Zhangjiexi229/SMART-M/文档/继电器端子特写_缩放.jpg

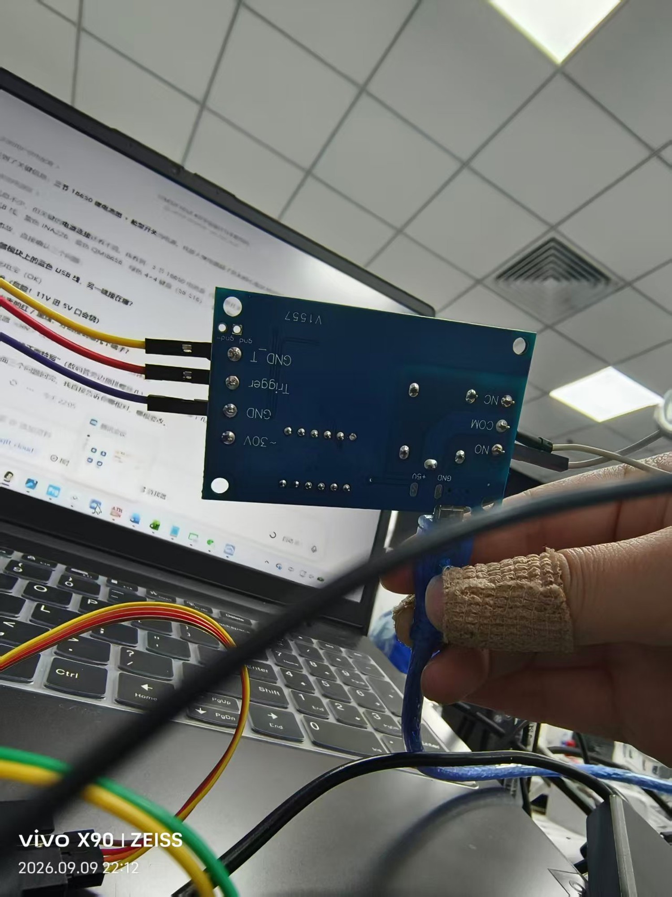
文档/继电器端子特写_缩放.jpg
