Zhangjiexi229/SMART-M/文档/接线_左下板区.jpg

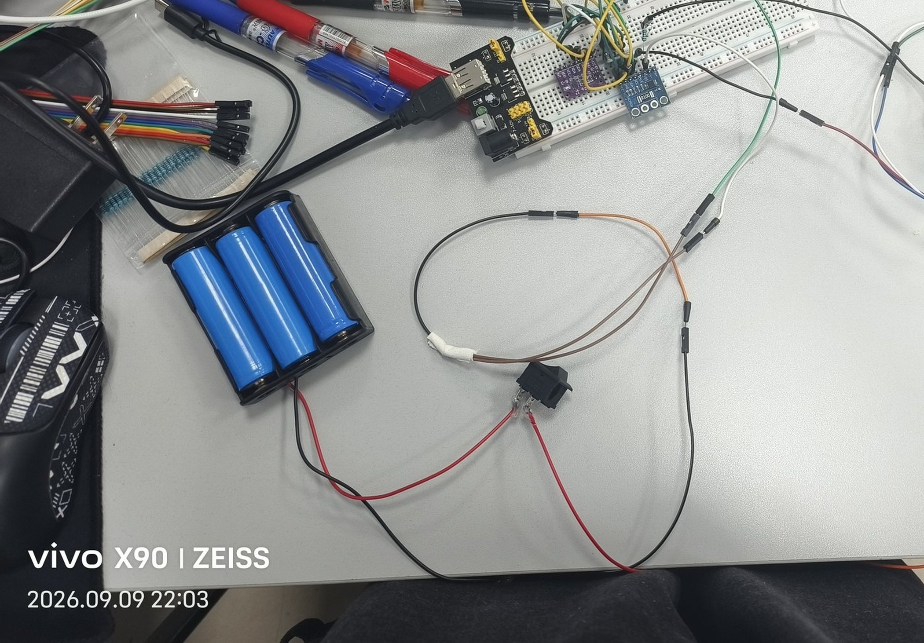
文档/接线_左下板区.jpg
