Zhangjiexi229/SMART-M/文档/器件引脚与功能配置总表.md

# SMART-M — 器件引脚与功能配置总表（F407VET6 新核心板版）

> 芯片：**STM32F407VET6（LQFP100）**，168MHz，512KB Flash / 192KB RAM
> 工程：`D:\STM32kdl\SMART-M`（CubeMX 工程 SMART-M.ioc + usrcode 分层代码）
> 本表为唯一权威引脚依据，与 bsp_xxx.h 头文件、SMART-M.ioc、接线图三处完全一致。

---

## 1. 器件 → 引脚 → 功能 → 配置 总表

| # | 器件/模块 | 信号 | STM32 引脚 | 引脚功能配置 | 配置位置 | 说明 |
|---|---|---|---|---|---|---|
| 1 | **SHT30 温湿度** | SCL | **PB8** | GPIO 推挽输出（开漏模拟时序，外部 4.7kΩ 上拉） | CubeMX GPIO + bsp_i2c_soft.c | 7 位地址 **0x44**（ADDR 接 GND）；总线1 |
| | | SDA | **PB9** | GPIO 开漏/推挽动态切换（4.7kΩ 上拉） | bsp_i2c_soft.c | 总线1 |
| | | VCC/GND | 3.3V / GND | 供电 | - | |
| 2 | **QMI8658 六轴** | SCL | **PB8** | 同上（与 SHT30 共用总线1） | bsp_i2c_soft.c | 7 位地址 **0x6B**（**本模块 AD0 板上固定接地**）；WHO_AM_I=0x05 |
| | | SDA | **PB9** | 同上 | bsp_i2c_soft.c | |
| | | AD0/SA0 | **板上固定 GND** | 地址选择 | 模块固定 | 本模块实测 0x6B；若换悬空模块则地址 0x6A，须同步改驱动 |
| 3 | **INA226 电流** | SCL | **PB8** | 同上（共用总线1） | bsp_i2c_soft.c | 7 位地址 **0x45**（本模块实测；A0/A1 模块出厂固定接 3.3V） |
| | | SDA | **PB9** | 同上 | bsp_i2c_soft.c | |
| | | IN+/IN- | 0.1Ω 采样电阻两端 | 电流采样 | 硬件接线 | 采样电阻串入电机电源回路 |
| 4 | **SSD1306 OLED 0.96"** | SCL | **PD6** | GPIO 推挽输出（总线2，模块自带上拉） | CubeMX GPIO + bsp_oled.c | 7 位地址 **0x3C**；**独立总线2**，不与传感器共用 |
| | | SDA | **PD7** | GPIO 推挽输出 | CubeMX GPIO + bsp_oled.c | |
| 5 | **ESP8266-01S WiFi** | TXD | **PB11** | **USART3_RX**（DMA 循环接收 + IDLE 空闲中断） | CubeMX USART3 + bsp_uart.c + bsp_esp8266.c | 外接（新板无板载接口），115200 8N1 |
| | | RXD | **PB10** | **USART3_TX** | CubeMX USART3 | ESP8266 RXD ← 单片机 TX |
| | | VCC | 独立 3.3V | 供电（**≥300mA**，AMS1117 单独一路） | 硬件接线 | 不可从核心板 3V3 取电 |
| | | CH_PD/EN | 3.3V（10k 上拉） | 使能 | 硬件接线 | 必须拉高 |
| | | GPIO0 | 10k 上拉（或悬空） | 正常运行模式 | 硬件接线 | |
| 6 | **继电器（断电保护）** | IN | **PA4** | GPIO 推挽输出（GPIO_SPEED_FREQ_LOW） | bsp_relay.c 动态初始化 | **高电平吸合**；光耦输入；COM/NO 串接电机电源回路 |
| | | VCC/GND | 5V / GND | 模块供电（光耦隔离，与单片机共地） | 硬件接线 | 上电默认断开，告警断开、恢复自动合闸 |
| 7 | **有源蜂鸣器** | I/O | **PA5** | GPIO 推挽输出 | CubeMX GPIO（BEEP_Pin）+ bsp_beep.c | **外接**（新板无板载）：+→PA5、-→GND；高电平响 |
| 8 | **4×4 矩阵键盘** | 行 R1-R4 | **PE2 / PE6 / PE7 / PE10** | GPIO 推挽输出（扫描时逐行拉低） | bsp_key_matrix.c 动态初始化 | 避开板载 KEY0=PE4、KEY1=PE3、Echo=PE5 |
| | | 列 C1-C4 | **PE8 / PE9 / PE11 / PE12** | GPIO 输入上拉 | bsp_key_matrix.c 动态初始化 | 读列电平判断按下 |
| 9 | **调试串口（printf）** | TX/RX | **PA9 / PA10** | **USART1** 115200 | CubeMX USART1 + bsp_uart.c | 板载 USB 转串口 |
| 10 | 板载 LED2/LED3 | - | **PA6 / PA7** | GPIO 推挽输出（低电平点亮） | CubeMX GPIO + bsp_led.c | 软件占用（LED1/LED3=PA6、LED2/LED4=PA7 为兼容逻辑位） |
| 11 | 板载按键（勿占用） | KEY0/KEY1/WK_UP | **PE4 / PE3 / PA0** | 输入 | 板载 | 勿配置为外设 |
| 12 | HC-SR04（预留，未启用） | Trig | **PC11** | GPIO 推挽输出 | CubeMX GPIO + bsp_hc_sr04.c | 8 外设版未启用 |
| | | Echo | **PE5** | GPIO 输入 | CubeMX GPIO | 5V 电平需 2k/1k 分压 |
| 13 | SWD 下载 | SWDIO/SWCLK | **PA13 / PA14** | SYS Serial Wire | CubeMX SYS | 调试下载口，勿占用 |
| 14 | 外部晶振 | OSC_IN/OUT | **PH0 / PH1** | RCC HSE（8MHz） | CubeMX RCC | 系统时钟 168MHz |

---

## 2. CubeMX 外设配置清单（SMART-M.ioc）

| 外设 | 配置 | 说明 |
|---|---|---|
| RCC | HSE 8MHz，PLL 倍频 → **SYSCLK 168MHz** | PLLM=8, PLLN=336, PLLQ=84 |
| SYS | Debug: **Serial Wire**（PA13/PA14） | SWD 下载 |
| TIM6 | Timebase 时基（NVIC，优先级 15） | HAL 时钟源 |
| TIM2 | 内部时钟（ClockSourceINT） | bsp_delay.c 微秒延时（自由计数） |
| USART1 | 异步 115200 8N1，**DMA2_Stream2 RX 循环** + DMA2_Stream7 TX | 调试 printf（PA9/PA10） |
| USART3 | 异步 115200 8N1，**DMA1_Stream1 RX 循环** + TX | ESP8266 通信口（PB10/PB11） |
| USART2 | 异步 9600（PA2/PA3，Modbus 预留） | module_cfg 中 PROTOCOL 已禁用，不启用 |
| FREERTOS | CMSIS_V2，默认任务 defaultTask | 应用任务在 app_tasks.c 创建 |
| GPIO 静态 | PA5 蜂鸣器 / PA6·PA7 LED / PC11 Trig / PE5 Echo / PD6·PD7 OLED / PB8·PB9 总线1 / PB3·PB4·PB5 SPI(禁用) | 见 gpio.c |
| GPIO 动态 | PA4 继电器 / PE2·PE6·PE7·PE10·PE8·PE9·PE11·PE12 矩阵 | BSP 初始化时配置 |

---

## 3. 8 大外设物理接线明细（杜邦线）

| 外设 | STM32 引脚 | 模块引脚 | 线色建议 | 备注 |
|---|---|---|---|---|
| SHT30 | 3.3V / GND | VCC / GND | 红 / 黑 | |
| | PB8 / PB9 | SCL / SDA | 蓝 / 蓝 | 总线1，SCL/SDA 各 4.7kΩ 上拉至 3.3V |
| QMI8658 | 3.3V / GND | VCC / GND | 红 / 黑 | |
| | - | AD0/SA0 | - | 本模块板上固定接地，**实测地址 0x6B**（软件已按 0x6B 编译） |
| | PB8 / PB9 | SCL / SDA | 蓝 / 蓝 | 共用总线1 |
| INA226 | 3.3V / GND | VCC / GND | 红 / 黑 | |
| | - | A0 / A1 | - | 本模块出厂固定接 3.3V，**实测地址 0x45**（软件已按 0x45 编译） |
| | PB8 / PB9 | SCL / SDA | 蓝 / 蓝 | 共用总线1 |
| | IN+ / IN- | 0.1Ω 电阻两端 | - | 串入电机电源回路 |
| | VBUS | 电机电源正极（与 IN+ 同节点） | 红 | **必接**：母线电压采样，悬空则 Bus 恒为 0 |
| OLED | 3.3V / GND | VCC / GND | 红 / 黑 | 0.96" SSD1306 |
| | PD6 / PD7 | SCL / SDA | 蓝 / 蓝 | 独立总线2 |
| ESP8266 | 独立3.3V | VCC | 红（独立） | ≥300mA |
| | GND | GND | 黑 | 共地 |
| | PB10 / PB11 | RXD / TXD | 绿 / 绿 | USART3 |
| | 3.3V | EN/CH_PD | 红 | 使能拉高 |
| | - | GPIO0 | - | 10k 上拉或悬空 |
| 继电器 | 5V / GND | VCC / GND | 红 / 黑 | 光耦隔离 |
| | PA4 | IN | 黄 | 高电平吸合；COM/NO 串接电机电源 |
| 蜂鸣器 | 3.3V 或 5V | VCC | 红 | 按模块额定电压 |
| | GND | GND | 黑 | |
| | PA5 | I/O | 黄 | 高电平响 |
| 矩阵键盘 | PE2 / PE6 / PE7 / PE10 | R1-R4 | 黄×4 | 行 |
| | PE8 / PE9 / PE11 / PE12 | C1-C4 | 黄×4 | 列 |

---

## 4. 供电架构

```
12V 适配器 ──┬─ 电机驱动板（功率回路，经继电器 COM/NO 通断）
             └─ 5V 降压（AMS1117-5.0 / MP1584）──┬─ 核心板 5V-IN → 板载 3.3V LDO
                                                 ├─ 继电器 VCC（5V）
                                                 └─ 独立 AMS1117-3.3 → ESP8266 VCC（单独一路，≥300mA）
    传感器 / OLED / 蜂鸣器：3.3V（核心板 3V3 或独立 3.3V，与 STM32 共地）
```

---

## 5. 与旧板（小达 M4 核心板 v1.2）关键差异

| 项 | 旧板 | 新板（本表） |
|----|---|---|
| 芯片 | STM32F407（LQFP100） | STM32F407VET6（LQFP100） |
| SHT30/QMI8658/OLED | I2C1 PB8/PB9 共用（OLED 同总线） | 总线1 PB8/PB9 挂三传感器；**OLED 拆独立总线2 PD6/PD7** |
| QMI8658 地址 | 0x6B | **0x6B（本模块 AD0 板上固定接地，实测；悬空模块为 0x6A）** |
| INA226 | 独立 I2C2 PB10/PB11（与 USART3 冲突） | 并入总线1 PB8/PB9 |
| ESP8266 | 板载 P1 接口 | **外接** USART3 PB10/PB11，独立 3.3V |
| 继电器 | PE2 | **PA4** |
| 蜂鸣器 | PE3（板载） | **PA5 外接**（新板无板载） |
| 矩阵键盘 | 行 PE4-PE7 / 列 PE8-PE11 | **行 PE2/PE6/PE7/PE10，列 PE8/PE9/PE11/PE12** |
| 板载 LED | - | PA6/PA7（低电平点亮） |
| HC-SR04（预留） | PA0/PA1 | PC11(Trig)/PE5(Echo) |

---

*本表由工程源码（bsp_*.h / main.h / SMART-M.ioc）考证生成，与已交付接线文档一致。*
