Zhangjiexi229/SMART-M/文档/Day 5 — 告警联动与上位机（完整代码版）.pdf

Day 5 — | 告警联动与上位机（完整代码版）
Day 5 — | 告警联动与上位机（完整代码版）

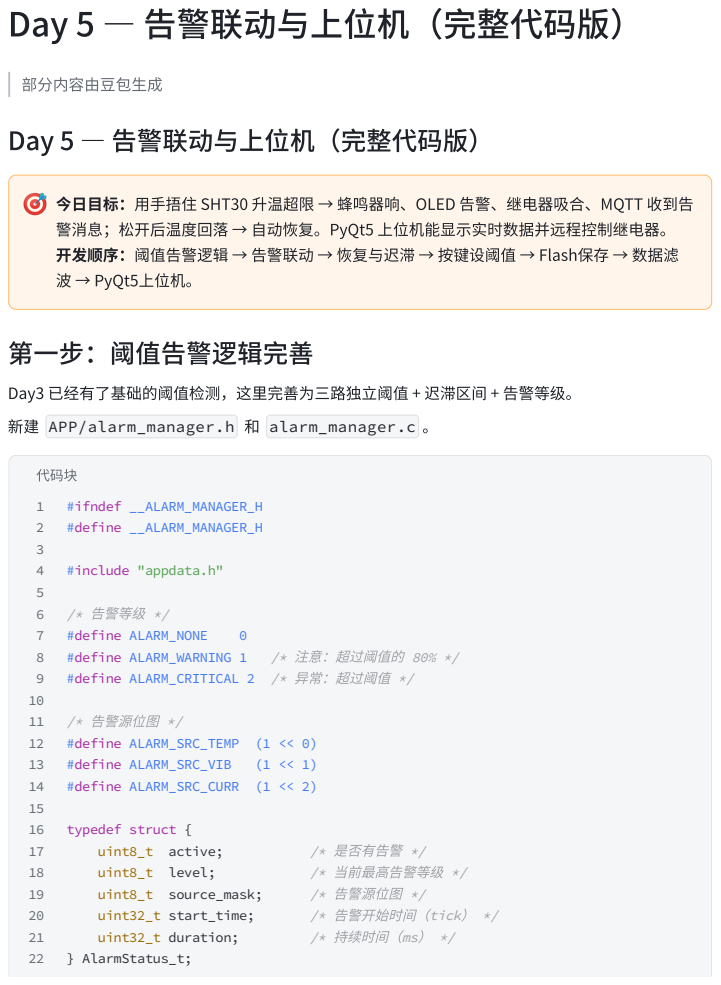
[picture p3: page 1]
部分内容由豆包生成; 第一步：阈值告警逻辑完善; 代码块; #ifndef __ALARM_MANAGER_H #define __ALARM_MANAGER_H; #include "appdata.h"; #define ALARM_NONE; #define ALARM_WARNING 1; /* 注意：超过阈值的 80% */; /* 告警源位图 */ #define ALARM_SRC_TEMP (1 << 0); #define ALARM_SRC_VIB; #define ALARM_SRC_CURR (1 << 2); typedef struct {; uint8_t active;; /* 是否有告警 */; uint8_t level;; /* 当前最高告警等级 */; uint8_t source_mask;; /* 告警源位图 */; uint32_t start_time;; /* 告警开始时间（tick） */; uint32_t duration;; /* 持续时间（ms） */; } AlarmStatus_t;

🎯 今日目标：用手捂住 SHT30 升温超限 → 蜂鸣器响、OLED 告警、继电器吸合、MQTT 收到告
警消息；松开后温度回落 → 自动恢复。PyQt5 上位机能显示实时数据并远程控制继电器。
开发顺序：阈值告警逻辑 → 告警联动 → 恢复与迟滞 → 按键设阈值 → Flash保存 → 数据滤
波 → PyQt5上位机。

Day3 已经有了基础的阈值检测，这里完善为三路独立阈值 + 迟滞区间 + 告警等级。
新建 APP/alarm_manager.h 和 alarm_manager.c 。

/* 告警等级 */
#define ALARM_CRITICAL 2 /* 异常：超过阈值 */

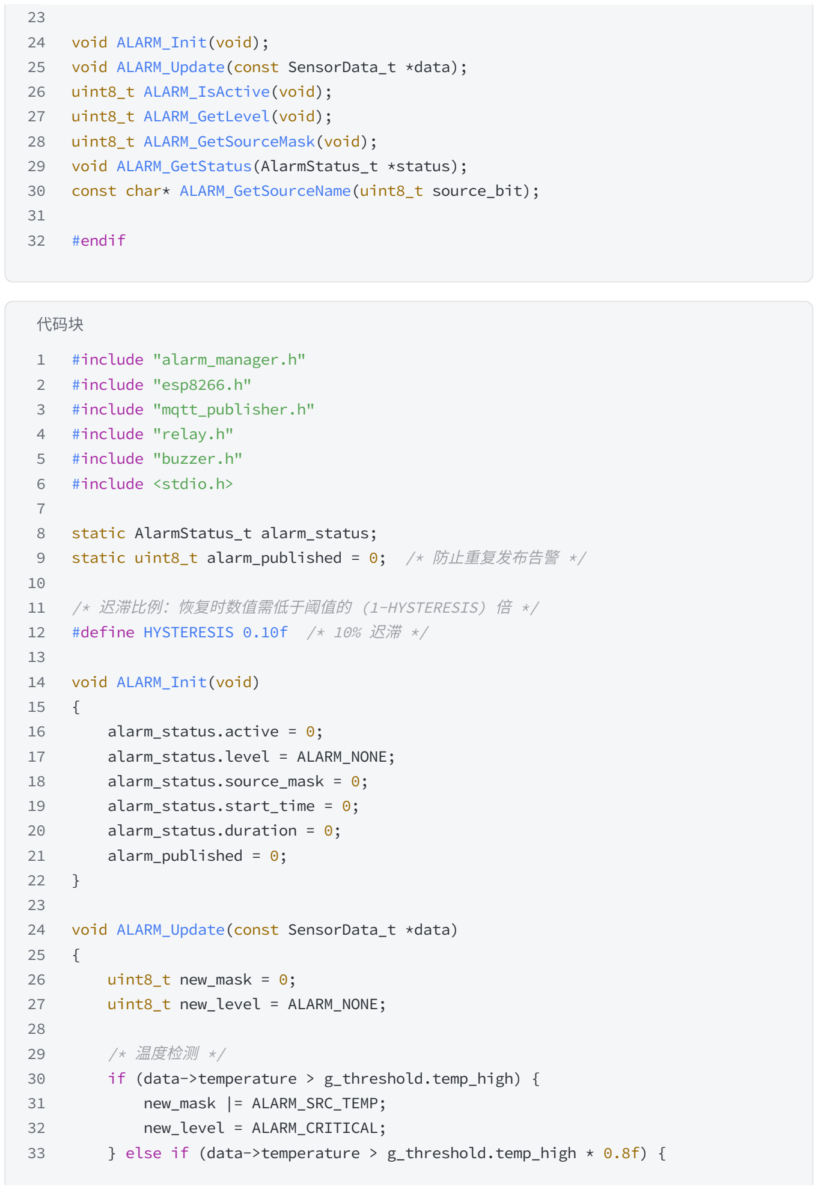
[picture p4: figure]
void ALARM_Init(void); void ALARM_Update(const SensorData_t *data); uint8_t ALARM_IsActive(void); uint8_t ALARM_GetLevel(void); uint8_t ALARM_GetSourceMask(void); void ALARM_GetStatus(AlarmStatus_t *status); const char* ALARM_GetSourceName(uint8_t source_bit);; #endif; 代码块; #include "alarm_manager.h" #include "esp8266.h" #include "mqtt_publisher.h" #include "relay.h" #include "buzzer.h" #include <stdio.h>; static AlarmStatus_t alarm_status;; /* 迟滞比例：恢复时数值需低于阈值的 (1-HYSTERESIS) 倍 */ #define HYSTERESIS 0.10f /* 10% 迟滞 */; void ALARM_Init(void) {; alarm_status.active = 0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

static uint8_t alarm_published = 0; /* 防止重复发布告警 */

} else if (data->temperature > g_threshold.temp_high * 0.8f) {

new_mask |= ALARM_SRC_TEMP;
if (new_level < ALARM_WARNING) new_level = ALARM_WARNING; }

/* 振动检测 */
if (data->vibration > g_threshold.vib_high) {
new_mask |= ALARM_SRC_VIB;
new_level = ALARM_CRITICAL;
} else if (data->vibration > g_threshold.vib_high * 0.8f) { new_mask |= ALARM_SRC_VIB;
if (new_level < ALARM_WARNING) new_level = ALARM_WARNING; }

/* 电流检测 */
if (data->current > g_threshold.curr_high) {
new_mask |= ALARM_SRC_CURR;
new_level = ALARM_CRITICAL;
} else if (data->current > g_threshold.curr_high * 0.8f) { new_mask |= ALARM_SRC_CURR;
if (new_level < ALARM_WARNING) new_level = ALARM_WARNING; }

/* 状态机：带迟滞的告警触发/恢复 */
if (!alarm_status.active && new_level >= ALARM_CRITICAL) { /* 触发告警 */
alarm_status.active = 1;
alarm_status.level = new_level; alarm_status.source_mask = new_mask; alarm_status.start_time = xTaskGetTickCount(); g_alarm_active = 1;
alarm_published = 0;
printf("ALARM TRIGGERED: mask=0x%02X level=%d\r\n", new_mask, new_level);
} else if (alarm_status.active) {
/* 更新告警等级和源 */
alarm_status.level = new_level; alarm_status.source_mask = new_mask; alarm_status.duration = (xTaskGetTickCount() -alarm_status.start_time);

/* 恢复条件：所有指标都低于阈值的 (1-HYSTERESIS) 倍 */
uint8_t can_recover = 1;
if (data->temperature > g_threshold.temp_high * (1.0f - HYSTERESIS)) can_recover = 0;
if (data->vibration > g_threshold.vib_high * (1.0f - HYSTERESIS)) can_recover = 0;

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
75 if (data->current > g_threshold.curr_high * (1.0f - HYSTERESIS)) can_recover = 0;

if (can_recover) {
alarm_status.active = 0;
alarm_status.level = ALARM_NONE; alarm_status.source_mask = 0; g_alarm_active = 0;
alarm_published = 0;
printf("ALARM RECOVERED, duration=%ums\r\n", alarm_status.duration);
}
}
}

uint8_t ALARM_IsActive(void) { return alarm_status.active; }
uint8_t ALARM_GetLevel(void) { return alarm_status.level; }
uint8_t ALARM_GetSourceMask(void) { return alarm_status.source_mask; }

void ALARM_GetStatus(AlarmStatus_t *status)
{
*status = alarm_status;
}

const char* ALARM_GetSourceName(uint8_t source_bit) {
switch (source_bit) {
case ALARM_SRC_TEMP: return "Temperature"; case ALARM_SRC_VIB: return "Vibration"; case ALARM_SRC_CURR: return "Current"; default: return "Unknown";
}
}

## 第二步：告警联动完整实现

在 AlarmTask 中调用 ALARM_Update，并执行联动动作。替换 Day3 的 AlarmTask：

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
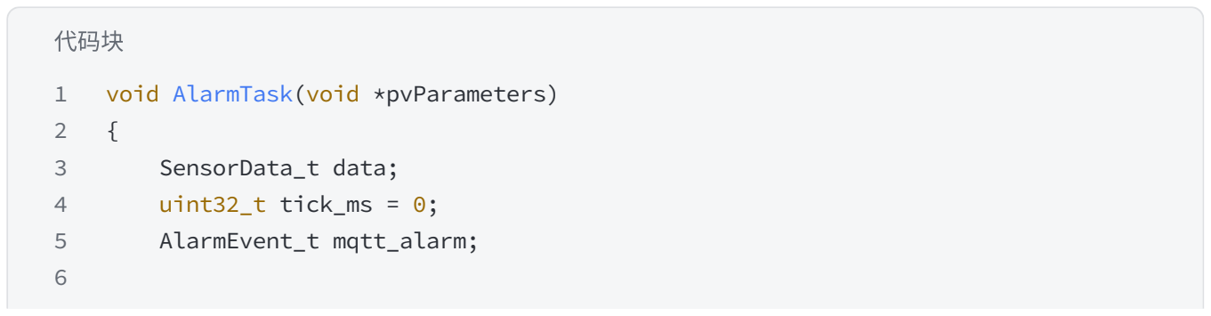
[picture p5: figure]
代码块; void AlarmTask(void *pvParameters) {; SensorData_t data; uint32_t tick_ms = 0; AlarmEvent_t mqtt_alarm;

ALARM_Init();

for (;;) {
/* 读取最新传感器数据 */
if (xSemaphoreTake(xDataMutex, pdMS_TO_TICKS(50)) == pdTRUE) { data = g_sensor_data;
xSemaphoreGive(xDataMutex);

/* 更新告警状态 */
uint8_t was_active = alarm_status.active; ALARM_Update(&data);

/* 告警触发瞬间：执行联动 + 发布 MQTT */
if (alarm_status.active && !was_active) { /* 1. 继电器吸合断电 */
RELAY_On();
/* 2. 蜂鸣器急促告警 */
BUZZER_AlarmPattern(1);
/* 3. 发布 MQTT 告警消息 */
if (alarm_status.source_mask & ALARM_SRC_TEMP) { mqtt_alarm.type = 1;
mqtt_alarm.value = data.temperature; mqtt_alarm.threshold = g_threshold.temp_high;
} else if (alarm_status.source_mask & ALARM_SRC_VIB) { mqtt_alarm.type = 2;
mqtt_alarm.value = data.vibration; mqtt_alarm.threshold = g_threshold.vib_high;
} else {
mqtt_alarm.type = 3;
mqtt_alarm.value = data.current; mqtt_alarm.threshold = g_threshold.curr_high; }
mqtt_alarm.level = alarm_status.level; MQTT_Pub_Alarm(&mqtt_alarm);

printf("ALARM ACTION: relay=ON buzzer=ON mqtt=published\r\n"); }

/* 告警恢复瞬间：解除联动 */
if (!alarm_status.active && was_active) { RELAY_Off();
BUZZER_AlarmPattern(0);
printf("ALARM RECOVER: relay=OFF buzzer=OFF\r\n"); }
}

/* 更新蜂鸣器节奏 */

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
## 第三步：OLED 告警显示优化

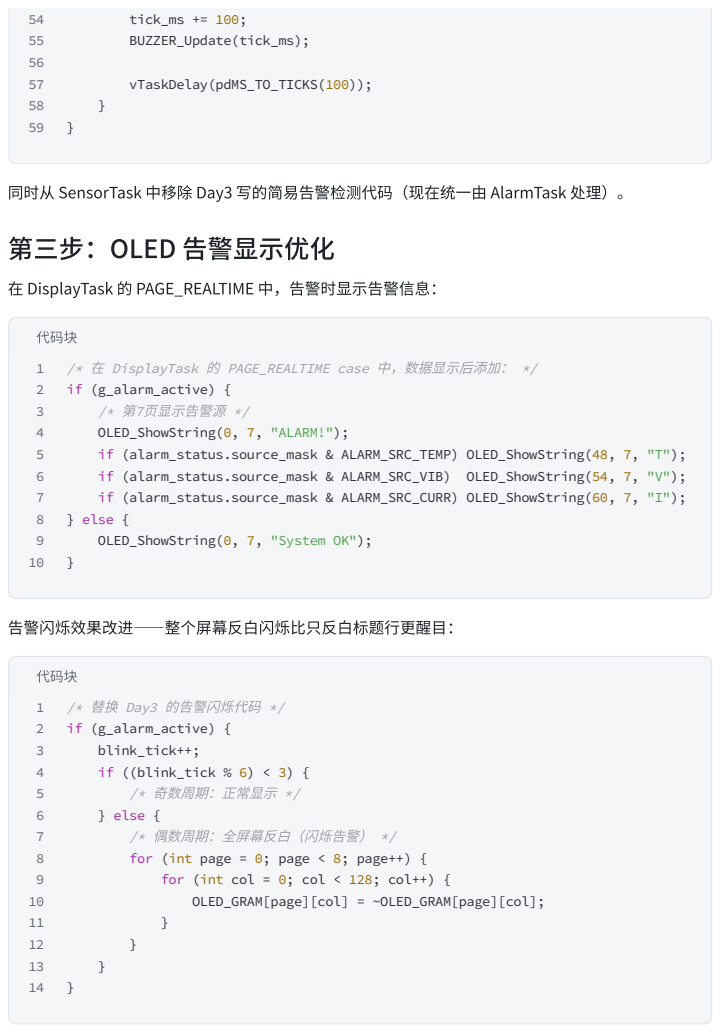
[picture p6: page 6]
tick_ms += 100; BUZZER_Update(tick_ms);; vTaskDelay(pdMS_TO_TICKS(100));; 在 DisplayTask 的 PAGE_REALTIME 中，告警时显示告警信息：; 代码块; /* 在 DisplayTask 的 PAGE_REALTIME case 中，数据显示后添加： */ if (g_alarm_active) { /* 第7页显示告警源 */ OLED_ShowString(0, 7, "ALARM!"); if (alarm_status.source_mask & ALARM_SRC_TEMP) OLED_ShowString(48, 7, "T"); if (alarm_status.source_mask & ALARM_SRC_VIB) OLED_ShowString(54, 7, "V"); if (alarm_status.source_mask & ALARM_SRC_CURR) OLED_ShowString(60, 7, "I")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

同时从 SensorTask 中移除 Day3 写的简易告警检测代码（现在统一由 AlarmTask 处理）。

代码块
if (g_alarm_active) {
blink_tick++;
if ((blink_tick % 6) < 3) {
/* 奇数周期：正常显示 */
} else {
/* 偶数周期：全屏幕反白（闪烁告警） */
for (int page = 0; page < 8; page++) {
for (int col = 0; col < 128; col++) {
OLED_GRAM[page][col] = ~OLED_GRAM[page][col];

## 第四步：按键设置阈值（完整交互）

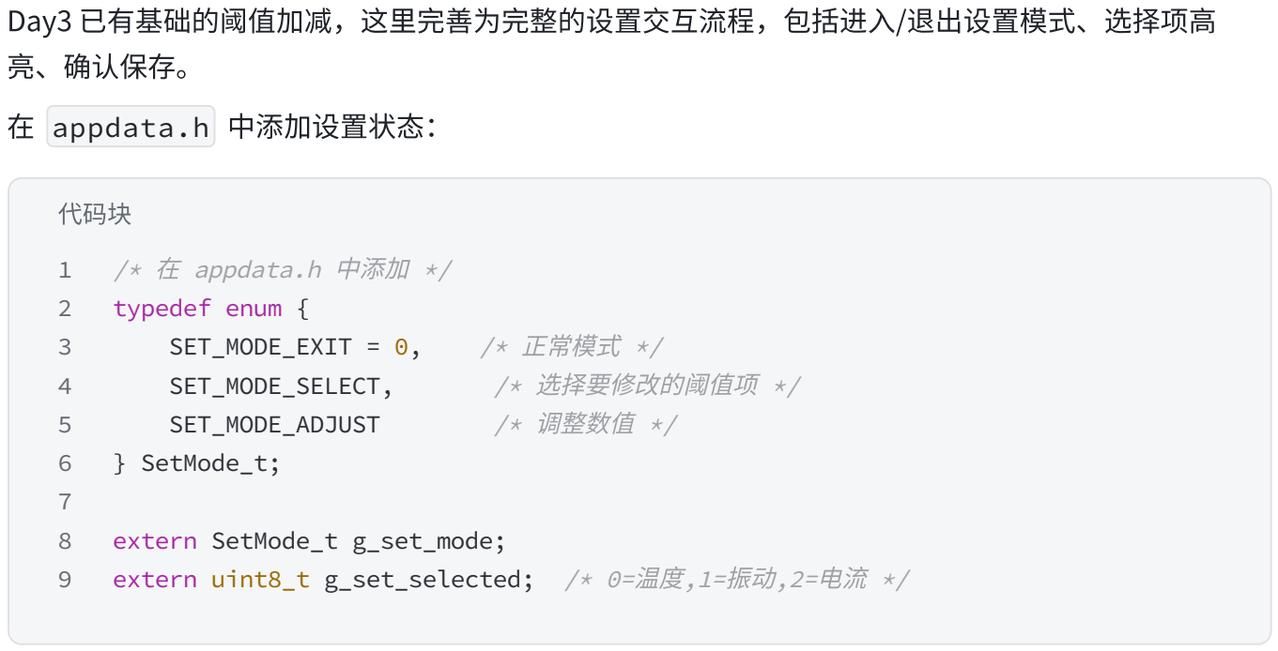
[picture p7: figure]
Day3 已有基础的阈值加减，这里完善为完整的设置交互流程，包括进入/退出设置模式、选择项高; 亮、确认保存。; 在 appdata.h 中添加设置状态：; 代码块; /* 在 appdata.h 中添加 */ typedef enum {; SET_MODE_EXIT = 0,; /* 正常模式 */; SET_MODE_SELECT,; /* 选择要修改的阈值项 */; SET_MODE_ADJUST; /* 调整数值 */; } SetMode_t;; extern SetMode_t g_set_mode;

extern uint8_t g_set_selected; /* 0=温度,1=振动,2=电流 */

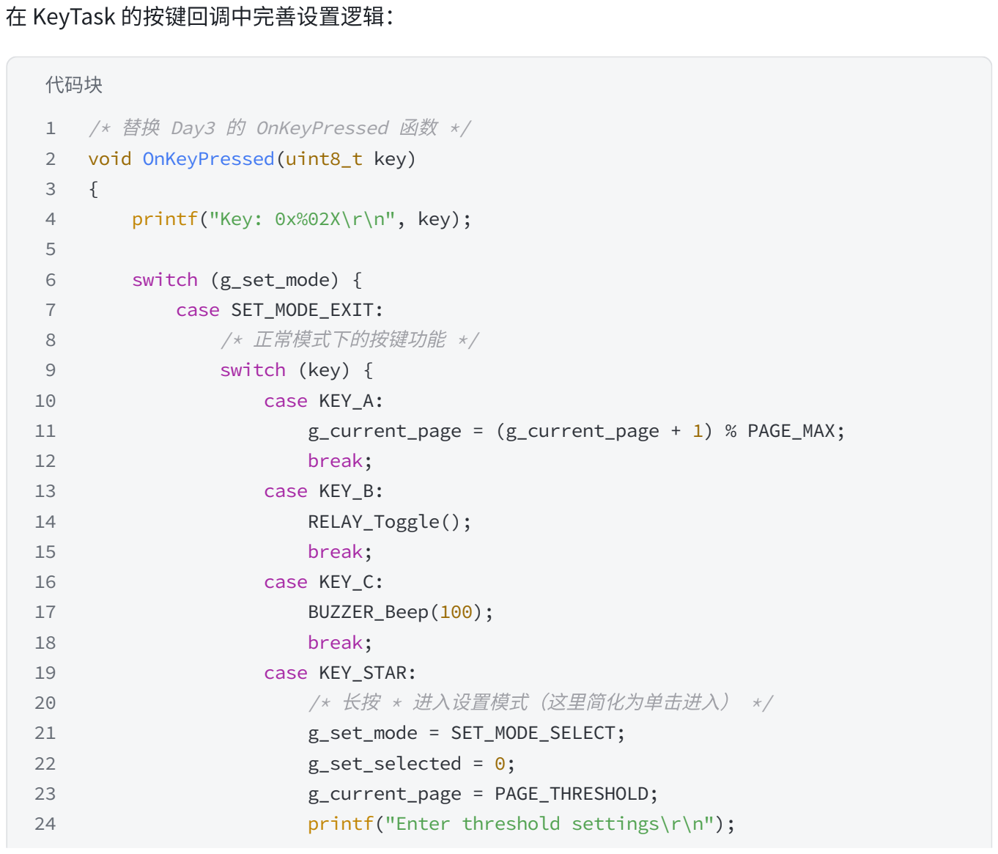
[picture p8: figure]
在 KeyTask 的按键回调中完善设置逻辑：; 代码块; /* 替换 Day3 的 OnKeyPressed 函数 */ void OnKeyPressed(uint8_t key) {; printf("Key: 0x%02X\r\n", key);; switch (g_set_mode) { case SET_MODE_EXIT:; /* 正常模式下的按键功能 */ switch (key) { case KEY_A:; break; case KEY_B: RELAY_Toggle(); break; case KEY_C: BUZZER_Beep(100); break; case KEY_STAR:; /* 长按 * 进入设置模式（这里简化为单击进入） */ g_set_mode = SET_MODE_SELECT; g_set_selected = 0; g_current_page = PAGE_THRESHOLD; printf("Enter threshold settings\r\n");

g_current_page = (g_current_page + 1) % PAGE_MAX;

break;
default:
break;
}
break;

case SET_MODE_SELECT:
/* 选择阈值项模式 */
switch (key) {
case KEY_2: /* 上移 */
g_set_selected = (g_set_selected + 2) % 3; break;
case KEY_8: /* 下移 */
g_set_selected = (g_set_selected + 1) % 3; break;
case KEY_A: /* 确认进入调整 */
g_set_mode = SET_MODE_ADJUST;
break;
case KEY_STAR: /* 退出设置 */
g_set_mode = SET_MODE_EXIT; g_current_page = PAGE_REALTIME; printf("Exit settings\r\n"); break;
default:
break;
}
break;

case SET_MODE_ADJUST:
/* 调整数值模式 */
switch (key) {
case KEY_2: /* 加 */
case KEY_POUND:
switch (g_set_selected) {
case 0: g_threshold.temp_high += 1.0f; break; case 1: g_threshold.vib_high += 0.1f; break; case 2: g_threshold.curr_high += 0.1f; break; }
break;
case KEY_8: /* 减 */
case KEY_STAR:
switch (g_set_selected) {
case 0:
if (g_threshold.temp_high > 10.0f) g_threshold.temp_high -= 1.0f; break;
case 1:

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
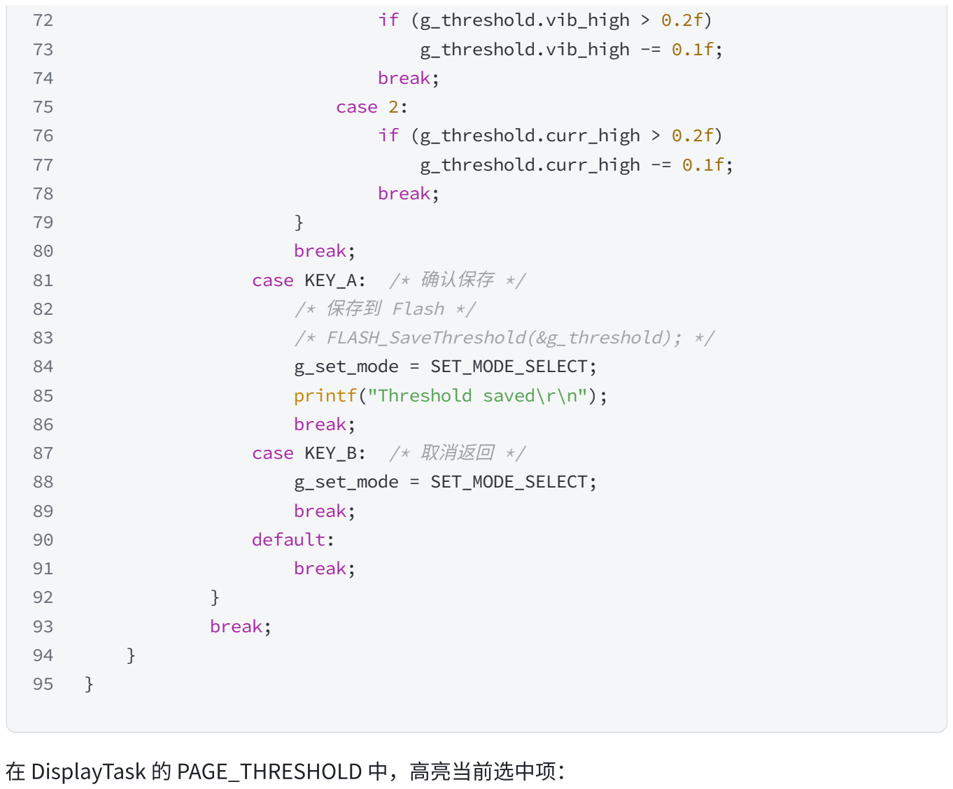
[picture p9: figure]
if (g_threshold.vib_high > 0.2f) g_threshold.vib_high -= 0.1f; break; case 2: if (g_threshold.curr_high > 0.2f) g_threshold.curr_high -= 0.1f; break;; } break; case KEY_A: /* 确认保存 */ /* 保存到 Flash */ /* FLASH_SaveThreshold(&g_threshold); */ g_set_mode = SET_MODE_SELECT; printf("Threshold saved\r\n"); break; case KEY_B: /* 取消返回 */ g_set_mode = SET_MODE_SELECT; break; default: break;; } break;; 在 DisplayTask 的 PAGE_THRESHOLD 中，高亮当前选中项：
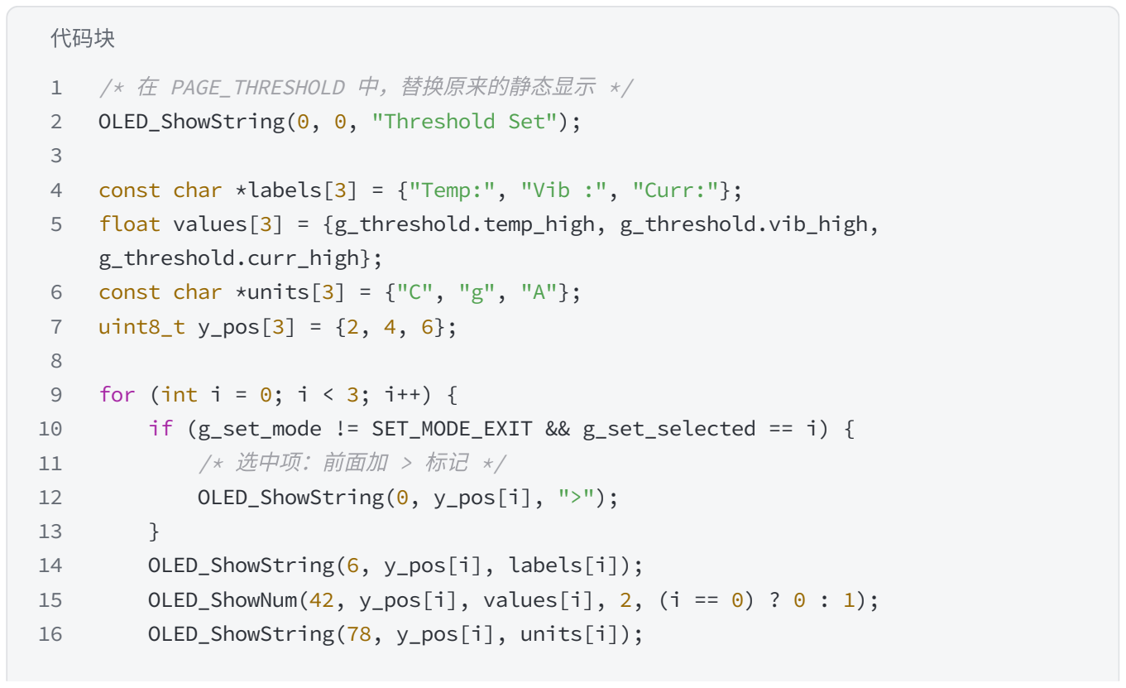
[picture p10: figure]
代码块; /* 在 PAGE_THRESHOLD 中，替换原来的静态显示 */ OLED_ShowString(0, 0, "Threshold Set");; float values[3] = {g_threshold.temp_high, g_threshold.vib_high, g_threshold.curr_high}; const char *units[3] = {"C", "g", "A"}; uint8_t y_pos[3] = {2, 4, 6};; for (int i = 0; i < 3; i++) {; /* 选中项：前面加 > 标记 */ OLED_ShowString(0, y_pos[i], ">");; } OLED_ShowString(6, y_pos[i], labels[i]);; OLED_ShowString(78, y_pos[i], units[i]);

const char *labels[3] = {"Temp:", "Vib :", "Curr:"};

if (g_set_mode != SET_MODE_EXIT && g_set_selected == i) {

OLED_ShowNum(42, y_pos[i], values[i], 2, (i == 0) ? 0 : 1);

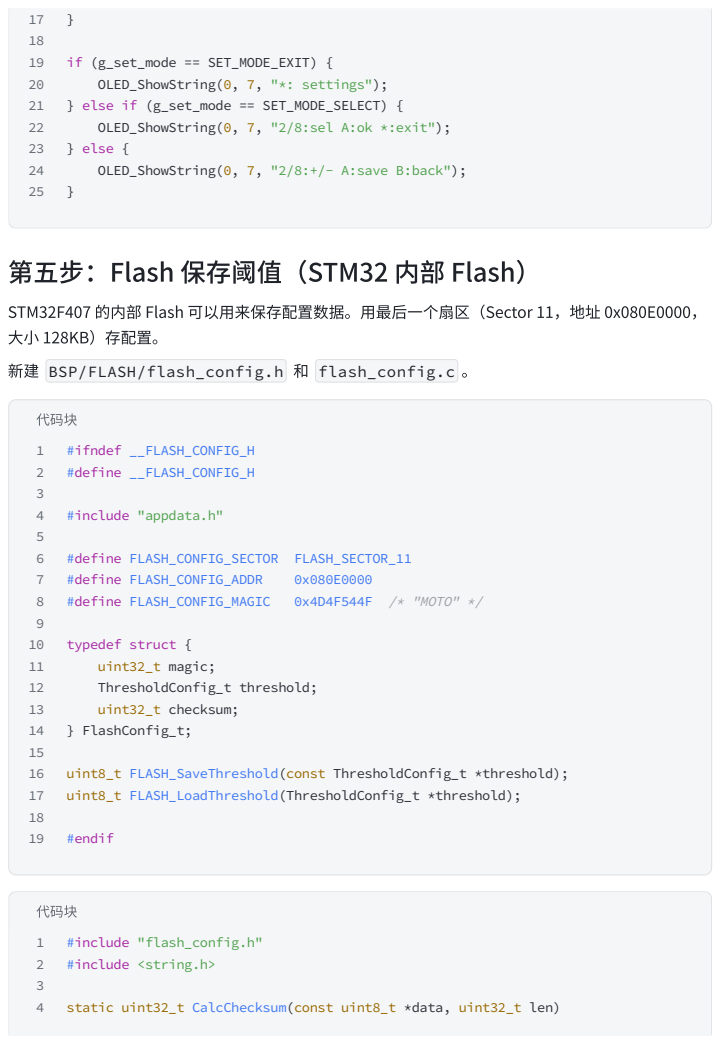
[picture p11: page 10]
if (g_set_mode == SET_MODE_EXIT) { OLED_ShowString(0, 7, "*: settings"); } else if (g_set_mode == SET_MODE_SELECT) { OLED_ShowString(0, 7, "2/8:sel A:ok *:exit"); } else { OLED_ShowString(0, 7, "2/8:+/- A:save B:back");; 代码块; #ifndef __FLASH_CONFIG_H #define __FLASH_CONFIG_H; #include "appdata.h"; #define FLASH_CONFIG_SECTOR FLASH_SECTOR_11; #define FLASH_CONFIG_ADDR; #define FLASH_CONFIG_MAGIC; 0x4D4F544F /* "MOTO" */; typedef struct { uint32_t magic; ThresholdConfig_t threshold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

第五步：Flash 保存阈值（STM32 内部 Flash）

STM32F407 的内部 Flash 可以用来保存配置数据。用最后一个扇区（Sector 11，地址 0x080E0000，
大小 128KB）存配置。
新建 BSP/FLASH/flash_config.h 和 flash_config.c 。

代码块
#include "flash_config.h"
#include <string.h>
static uint32_t CalcChecksum(const uint8_t *data, uint32_t len)

{
uint32_t sum = 0;
for (uint32_t i = 0; i < len; i++) { sum += data[i];
}
return sum;
}

uint8_t FLASH_SaveThreshold(const ThresholdConfig_t *threshold) {
FlashConfig_t config;
config.magic = FLASH_CONFIG_MAGIC;
config.threshold = *threshold;
config.checksum = CalcChecksum((uint8_t *)&config, sizeof(FlashConfig_t) -4);

HAL_FLASH_Unlock();

/* 擦除扇区 */
FLASH_EraseInitTypeDef erase_init; erase_init.TypeErase = FLASH_TYPEERASE_SECTORS; erase_init.Sector = FLASH_CONFIG_SECTOR; erase_init.NbSectors = 1;
erase_init.VoltageRange = FLASH_VOLTAGE_RANGE_3;
uint32_t page_error = 0;
if (HAL_FLASHEx_Erase(&erase_init, &page_error) != HAL_OK) { HAL_FLASH_Lock();
return 1;
}

/* 按字写入 */
uint32_t *data = (uint32_t *)&config;
uint32_t addr = FLASH_CONFIG_ADDR;
for (uint32_t i = 0; i < sizeof(FlashConfig_t) / 4; i++) {
if (HAL_FLASH_Program(FLASH_TYPEPROGRAM_WORD, addr, data[i]) != HAL_OK) {
HAL_FLASH_Lock();
return 2;
}
addr += 4;
}

HAL_FLASH_Lock();
return 0;
}

uint8_t FLASH_LoadThreshold(ThresholdConfig_t *threshold)

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
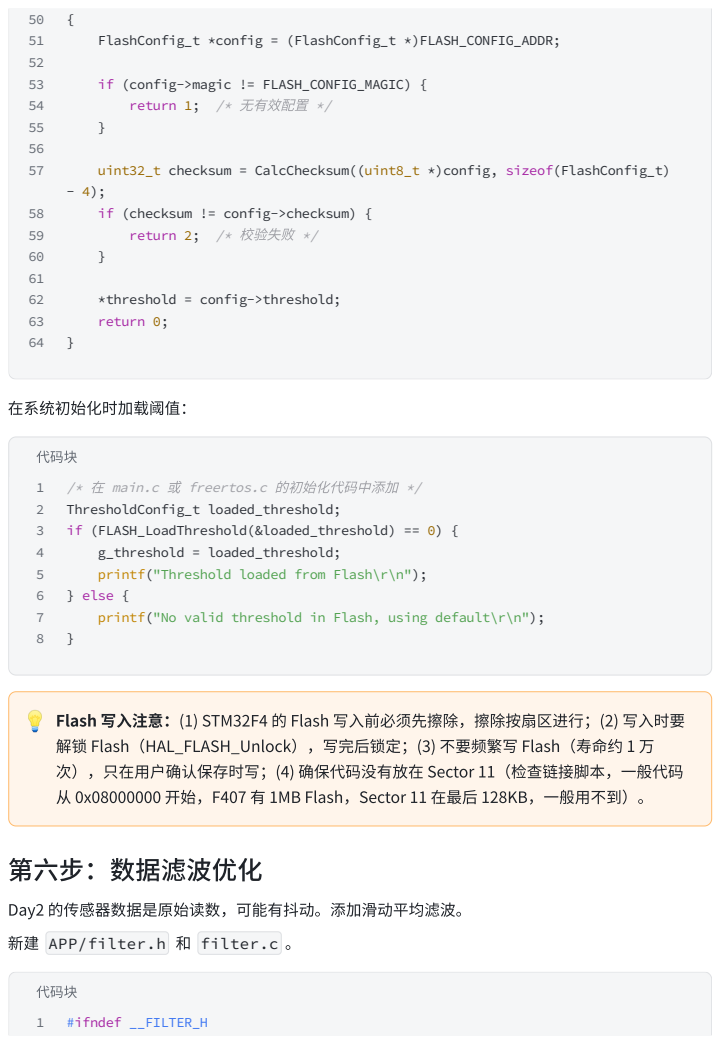
[picture p12: page 12]
FlashConfig_t *config = (FlashConfig_t *)FLASH_CONFIG_ADDR;; - 4); if (checksum != config->checksum) { return 2; /* 校验失败 */; 在系统初始化时加载阈值：; 第六步：数据滤波优化; 代码块; #ifndef __FILTER_H

if (config->magic != FLASH_CONFIG_MAGIC) {
return 1; /* 无有效配置 */

uint32_t checksum = CalcChecksum((uint8_t *)config, sizeof(FlashConfig_t)

*threshold = config->threshold;
return 0;

代码块
/* 在 main.c 或 freertos.c 的初始化代码中添加 */
ThresholdConfig_t loaded_threshold;
if (FLASH_LoadThreshold(&loaded_threshold) == 0) {
g_threshold = loaded_threshold;
printf("Threshold loaded from Flash\r\n");
} else {
printf("No valid threshold in Flash, using default\r\n");

💡 Flash 写入注意：(1) STM32F4 的 Flash 写入前必须先擦除，擦除按扇区进行；(2) 写入时要
解锁 Flash（HAL_FLASH_Unlock），写完后锁定；(3) 不要频繁写 Flash（寿命约 1 万
次），只在用户确认保存时写；(4) 确保代码没有放在 Sector 11（检查链接脚本，一般代码
从 0x08000000 开始，F407 有 1MB Flash，Sector 11 在最后 128KB，一般用不到）。

Day2 的传感器数据是原始读数，可能有抖动。添加滑动平均滤波。
新建 APP/filter.h 和 filter.c 。

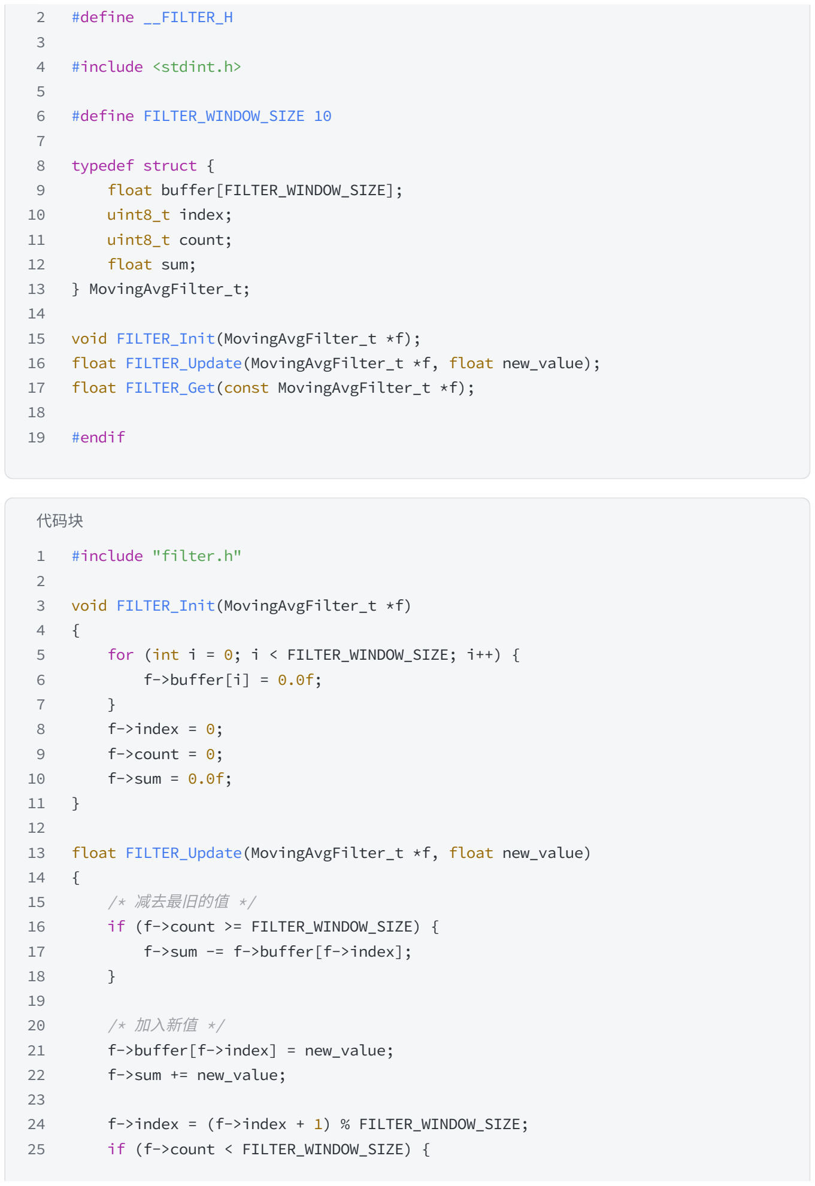
[picture p13: figure]
#define __FILTER_H; #include <stdint.h>; #define FILTER_WINDOW_SIZE 10; typedef struct { float buffer[FILTER_WINDOW_SIZE]; uint8_t index; uint8_t count; float sum; } MovingAvgFilter_t;; void FILTER_Init(MovingAvgFilter_t *f); float FILTER_Update(MovingAvgFilter_t *f, float new_value); float FILTER_Get(const MovingAvgFilter_t *f);; #endif; 代码块; #include "filter.h"; void FILTER_Init(MovingAvgFilter_t *f) {; f->buffer[i] = 0.0f;; } f->index = 0; f->count = 0; f->sum = 0.0f;; float FILTER_Update(MovingAvgFilter_t *f, float new_value) {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

for (int i = 0; i < FILTER_WINDOW_SIZE; i++) {

f->index = (f->index + 1) % FILTER_WINDOW_SIZE;

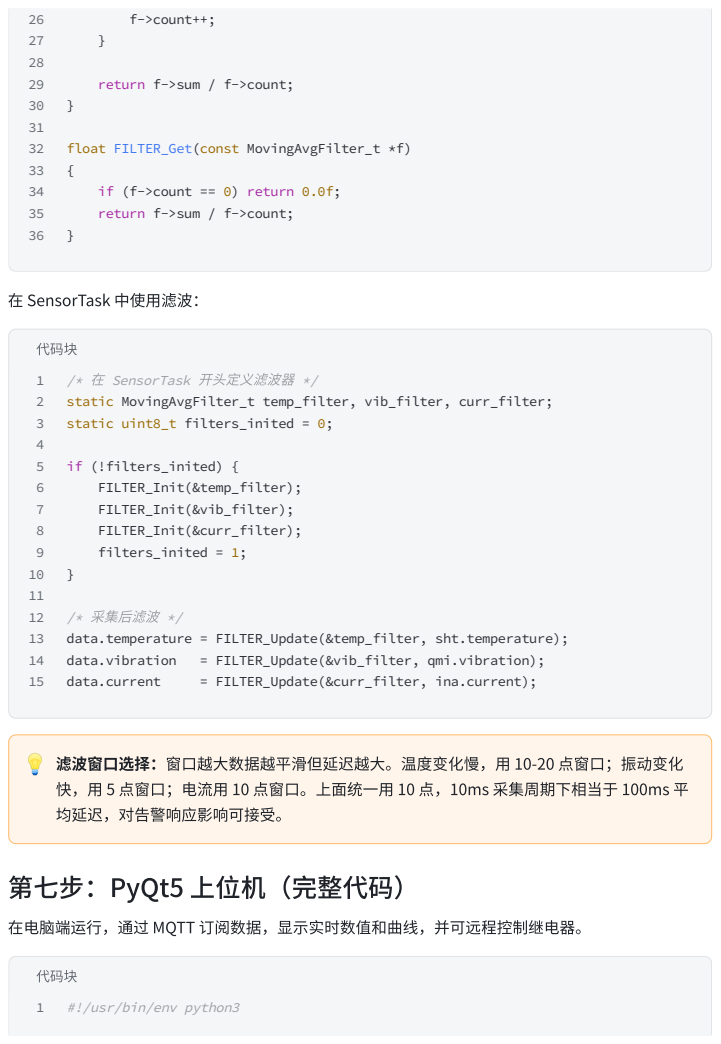
[picture p14: page 14]
f->count++;; 在 SensorTask 中使用滤波：; 代码块; /* 在 SensorTask 开头定义滤波器 */ static MovingAvgFilter_t temp_filter, vib_filter, curr_filter; static uint8_t filters_inited = 0;; if (!filters_inited) { FILTER_Init(&temp_filter); FILTER_Init(&vib_filter); FILTER_Init(&curr_filter); filters_inited = 1;; data.vibration; = FILTER_Update(&vib_filter, qmi.vibration);; data.current; = FILTER_Update(&curr_filter, ina.current);

return f->sum / f->count;

float FILTER_Get(const MovingAvgFilter_t *f)
if (f->count == 0) return 0.0f;

/* 采集后滤波 */
data.temperature = FILTER_Update(&temp_filter, sht.temperature);

💡 滤波窗口选择：窗口越大数据越平滑但延迟越大。温度变化慢，用 10-20 点窗口；振动变化
快，用 5 点窗口；电流用 10 点窗口。上面统一用 10 点，10ms 采集周期下相当于 100ms 平
均延迟，对告警响应影响可接受。

第七步：PyQt5 上位机（完整代码）

在电脑端运行，通过 MQTT 订阅数据，显示实时数值和曲线，并可远程控制继电器。

代码块
#!/usr/bin/env python3

# -*- coding: utf-8 -*-

"""
STM32 工业电机监测系统 — PyQt5 上位机
依赖: pip install PyQt5 paho-mqtt pyqtgraph """

import sys
import json
import time
from collections import deque

from PyQt5.QtWidgets import (QApplication, QMainWindow, QWidget, QVBoxLayout, QHBoxLayout, QLabel, QPushButton, QGroupBox, QGridLayout, QComboBox, QLineEdit)
from PyQt5.QtCore import Qt, QTimer
from PyQt5.QtGui import QFont, QColor, QPalette

import paho.mqtt.client as mqtt
import pyqtgraph as pg

BROKER = "broker.emqx.io"
PORT = 1883
TOPIC_DATA = "motor/sensor/data" TOPIC_ALARM = "motor/sensor/alarm" TOPIC_CTRL = "motor/ctrl"

MAX_POINTS = 100

class MotorMonitorWindow(QMainWindow): def __init__(self):
super().__init__()
self.setWindowTitle("STM32 工业电机监测系统 — 上位机") self.setGeometry(100, 100, 1000, 700)

# 数据缓冲

self.times = deque(maxlen=MAX_POINTS) self.temp_data = deque(maxlen=MAX_POINTS) self.vib_data = deque(maxlen=MAX_POINTS) self.curr_data = deque(maxlen=MAX_POINTS)

# MQTT 客户端

self.mqtt_client = mqtt.Client(client_id="pyqt_upper_001") self.mqtt_client.on_connect = self.on_mqtt_connect self.mqtt_client.on_message = self.on_mqtt_message self.mqtt_connected = False

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
self.init_ui()
self.connect_mqtt()

# 定时刷新曲线

self.timer = QTimer()
self.timer.timeout.connect(self.update_plot) self.timer.start(200)

def init_ui(self):
central = QWidget()
self.setCentralWidget(central) main_layout = QVBoxLayout(central)

# 顶部：连接状态 + 控制

top_group = QGroupBox("连接与控制") top_layout = QHBoxLayout(top_group)

self.conn_label = QLabel("MQTT: 未连接") self.conn_label.setStyleSheet("color: red; font-weight: bold;") top_layout.addWidget(self.conn_label)

top_layout.addWidget(QLabel("Broker:"))
self.broker_edit = QLineEdit(BROKER) self.broker_edit.setFixedWidth(150) top_layout.addWidget(self.broker_edit)

self.reconnect_btn = QPushButton("重新连接") self.reconnect_btn.clicked.connect(self.reconnect_mqtt) top_layout.addWidget(self.reconnect_btn)

top_layout.addStretch()

self.relay_btn = QPushButton("继电器: 断开") self.relay_btn.setCheckable(True) self.relay_btn.clicked.connect(self.toggle_relay) self.relay_btn.setStyleSheet("background-color: #4CAF50; color: white; padding: 8px 16px;")
top_layout.addWidget(self.relay_btn)

main_layout.addWidget(top_group)

# 中部：实时数值卡片

data_group = QGroupBox("实时数据") data_layout = QGridLayout(data_group)

self.value_labels = {}
items = [

("温度", "temp", "°C", "#2196F3"), ("湿度", "humi", "%RH", "#00BCD4"), ("振动", "vib", "g", "#FF9800"), ("电流", "curr", "A", "#F44336"), ("电压", "volt", "V", "#9C27B0"), ("功率", "power", "W", "#795548"),
]

for i, (name, key, unit, color) in enumerate(items): row, col = divmod(i, 3)
card = QVBoxLayout()
title_label = QLabel(name) title_label.setAlignment(Qt.AlignCenter) title_label.setStyleSheet(f"color: {color}; font-size: 14px;")

value_label = QLabel("--") value_label.setAlignment(Qt.AlignCenter) value_label.setStyleSheet(f"color: {color}; font-size: 28px; font-weight: bold;")

unit_label = QLabel(unit)
unit_label.setAlignment(Qt.AlignCenter) unit_label.setStyleSheet("color: #666; font-size: 12px;")

card.addWidget(title_label)
card.addWidget(value_label)
card.addWidget(unit_label) data_layout.addLayout(card, row, col) self.value_labels[key] = value_label

# 告警状态

self.alarm_label = QLabel("系统正常") self.alarm_label.setAlignment(Qt.AlignCenter) self.alarm_label.setStyleSheet("background-color: #4CAF50; color: white; "
"padding: 10px; font-size: 16px; font-weight: bold; "
"border-radius: 5px;")
data_layout.addWidget(self.alarm_label, 2, 0, 1, 3)

main_layout.addWidget(data_group)

# 底部：曲线图

plot_group = QGroupBox("实时曲线") plot_layout = QVBoxLayout(plot_group)

self.plot_widget = pg.PlotWidget()

self.plot_widget.setBackground('w') self.plot_widget.showGrid(x=True, y=True, alpha=0.3) self.plot_widget.addLegend() self.plot_widget.setLabel('left', '数值') self.plot_widget.setLabel('bottom', '时间')

self.curve_temp = self.plot_widget.plot(pen=pg.mkPen('#2196F3', width=2), name='温度(°C)')
self.curve_vib = self.plot_widget.plot(pen=pg.mkPen('#FF9800', width=2), name='振动(g)')
self.curve_curr = self.plot_widget.plot(pen=pg.mkPen('#F44336', width=2), name='电流(A)')

plot_layout.addWidget(self.plot_widget) main_layout.addWidget(plot_group)

def connect_mqtt(self):
try:
self.mqtt_client.connect(self.broker_edit.text(), PORT, 60) self.mqtt_client.loop_start()
except Exception as e:
self.conn_label.setText(f"MQTT: 连接失败 ({e})")

def reconnect_mqtt(self):
self.mqtt_client.loop_stop() self.mqtt_client.disconnect()
self.connect_mqtt()

def on_mqtt_connect(self, client, userdata, flags, rc): if rc == 0:
self.mqtt_connected = True
self.conn_label.setText("MQTT: 已连接") self.conn_label.setStyleSheet("color: green; font-weight: bold;") client.subscribe([(TOPIC_DATA, 0), (TOPIC_ALARM, 0)])
else:
self.conn_label.setText(f"MQTT: 连接失败 (rc={rc})")

def on_mqtt_message(self, client, userdata, msg): try:
data = json.loads(msg.payload.decode()) if msg.topic == TOPIC_DATA: self.update_values(data)
except Exception as e:
print(f"Parse error: {e}")

def update_values(self, data): now = time.strftime("%H:%M:%S")

self.times.append(now)

for key in ['temp', 'humi', 'vib', 'curr', 'volt', 'power']: if key in data and key in self.value_labels:
decimals = 1 if key in ['temp', 'humi', 'volt'] else 2 self.value_labels[key].setText(f"{data[key]:.{decimals}f}")

self.temp_data.append(data.get('temp', 0)) self.vib_data.append(data.get('vib', 0)) self.curr_data.append(data.get('curr', 0))

# 告警状态

if data.get('alarm', 0):
self.alarm_label.setText("⚠ 告警中!") self.alarm_label.setStyleSheet("background-color: #F44336; color: white; "
"padding: 10px; font-size: 16px; font-weight: bold; "
"border-radius: 5px;")
else:
self.alarm_label.setText("系统正常") self.alarm_label.setStyleSheet("background-color: #4CAF50; color: white; "
"padding: 10px; font-size: 16px; font-weight: bold; "
"border-radius: 5px;")

def update_plot(self):
if len(self.times) > 0:
x = list(range(len(self.times))) self.curve_temp.setData(x, list(self.temp_data)) self.curve_vib.setData(x, list(self.vib_data)) self.curve_curr.setData(x, list(self.curr_data))

def toggle_relay(self):
if self.relay_btn.isChecked():
self.relay_btn.setText("继电器: 吸合") self.relay_btn.setStyleSheet("background-color: #F44336; color: white; padding: 8px 16px;") payload = json.dumps({"relay": 1})
else:
self.relay_btn.setText("继电器: 断开") self.relay_btn.setStyleSheet("background-color: #4CAF50; color: white; padding: 8px 16px;") payload = json.dumps({"relay": 0})

if self.mqtt_connected:

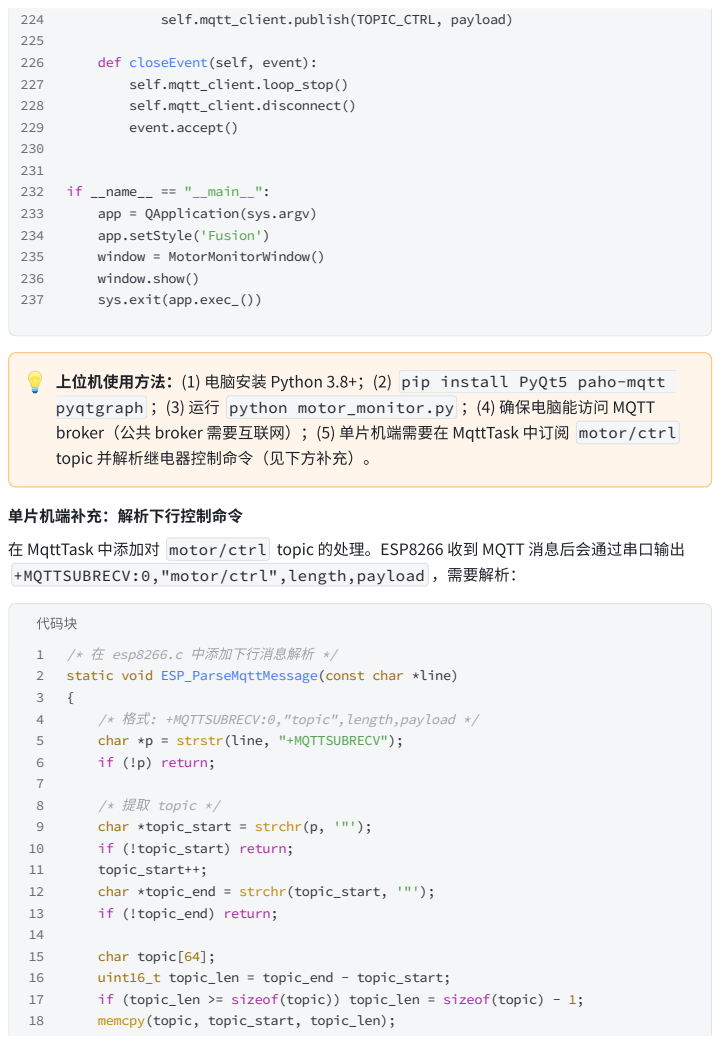
[picture p15: page 20]
💡 上位机使用方法：(1) 电脑安装 Python 3.8+；(2); pip install PyQt5 paho-mqtt; pyqtgraph; ；(3) 运行 python motor_monitor.py ；(4) 确保电脑能访问 MQTT; 单片机端补充：解析下行控制命令; /* 提取 topic */ char *topic_start = strchr(p, '"'); if (!topic_start) return; topic_start++; char *topic_end = strchr(topic_start, '"'); if (!topic_end) return;

self.mqtt_client.publish(TOPIC_CTRL, payload)

def closeEvent(self, event):
self.mqtt_client.loop_stop()
self.mqtt_client.disconnect()
event.accept()

if __name__ == "__main__":
app = QApplication(sys.argv)
app.setStyle('Fusion')
window = MotorMonitorWindow()
window.show()
sys.exit(app.exec_())

broker（公共 broker 需要互联网）；(5) 单片机端需要在 MqttTask 中订阅 motor/ctrl
topic 并解析继电器控制命令（见下方补充）。

在 MqttTask 中添加对 motor/ctrl topic 的处理。ESP8266 收到 MQTT 消息后会通过串口输出
+MQTTSUBRECV:0,"motor/ctrl",length,payload ，需要解析：

代码块
/* 在 esp8266.c 中添加下行消息解析 */
static void ESP_ParseMqttMessage(const char *line)
/* 格式: +MQTTSUBRECV:0,"topic",length,payload */
char *p = strstr(line, "+MQTTSUBRECV");
if (!p) return;

char topic[64];
uint16_t topic_len = topic_end - topic_start;
if (topic_len >= sizeof(topic)) topic_len = sizeof(topic) - 1;
memcpy(topic, topic_start, topic_len);

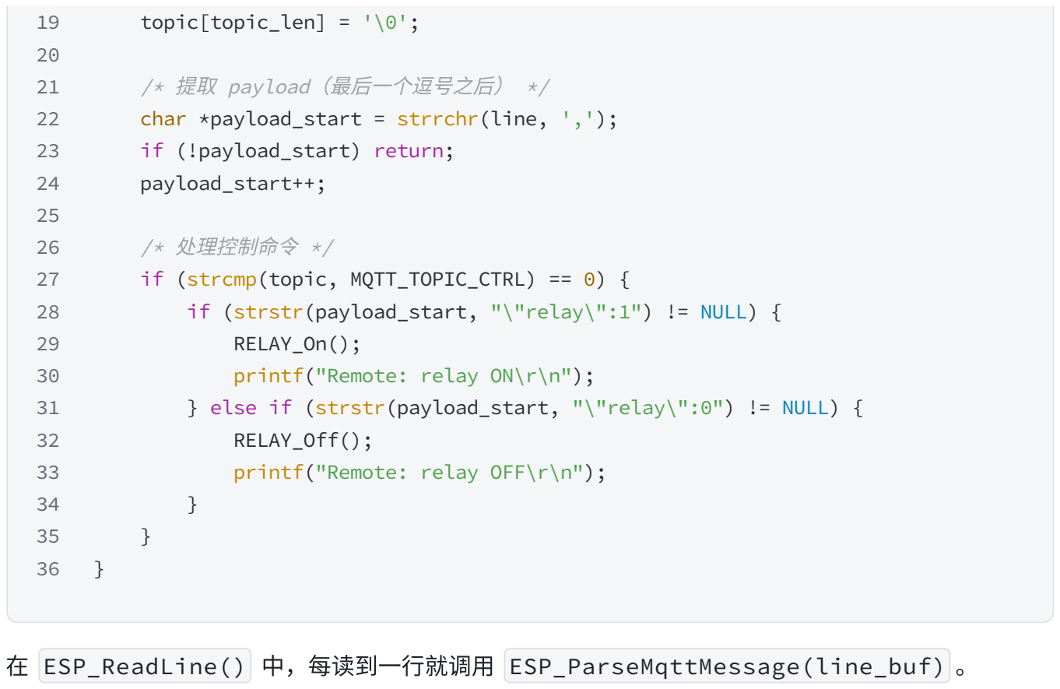
[picture p16: figure]
topic[topic_len] = '\0';; /* 提取 payload（最后一个逗号之后） */ char *payload_start = strrchr(line, ','); if (!payload_start) return; payload_start++;; /* 处理控制命令 */; RELAY_On(); printf("Remote: relay ON\r\n");; RELAY_Off(); printf("Remote: relay OFF\r\n");; 在 ESP_ReadLine() 中，每读到一行就调用 ESP_ParseMqttMessage(line_buf) 。

if (strcmp(topic, MQTT_TOPIC_CTRL) == 0) {
if (strstr(payload_start, "\"relay\":1") != NULL) {

} else if (strstr(payload_start, "\"relay\":0") != NULL) {

## 常见问题排查

现象 | 排查方向
告警不触发 | (1) 阈值设置是否太高（默认 60°C/3g/5A，手捂可能达不到）；(2) ALARM_Update 是否被 AlarmTask 正确调用；(3) 传感器数据是否正常 （滤波后是否有值）
告警不恢复 | (1) 迟滞比例是否太大（10% 意味着温度要降到阈值的 90% 以下）；(2) 传 感器是否有偏移导致读数始终偏高；(3) 继电器是否粘住（机械继电器触点 粘连）
OLED 告警闪烁不明显 | (1) 闪烁周期是否合适（600ms 周期）；(2) 全屏反白是否正确实现；(3) OLED_Refresh 是否在闪烁后调用
按键设置阈值不生效 | (1) 设置模式状态机是否正确切换；(2) 按键回调中 SET_MODE 判断是否正 确；(3) 阈值下限保护是否阻止了修改
Flash 保存后重启丢失 | (1) 写入是否成功（检查返回值）；(2) 魔术字和校验和是否正确；(3) Flash 地址是否被代码覆盖（检查链接脚本）；(4) 读取时指针是否正确
PyQt5 上位机连不上 MQTT | (1) 电脑是否能访问 broker（ping broker.emqx.io）；(2) 端口 1883 是否 被防火墙拦截；(3) client_id 是否和单片机重复（必须唯一）；(4) paho-mqtt 是否正确安装

（注：部分内容可能由 AI 生成）

上位机收不到数据 | (1) topic 是否完全一致；(2) 单片机是否在发布数据（MQTTX 验证）；(3) 上位机是否成功订阅（on_connect 中检查 rc=0）；(4) JSON 解析是否报 错（看控制台输出）
远程控制继电器没反应 | (1) 单片机是否订阅了 motor/ctrl topic；(2) ESP_ParseMqttMessage 是否 被调用；(3) payload 格式是否匹配（"relay":1）；(4) 继电器是否被告警逻 辑强制覆盖（告警时继电器强制吸合）

🏆 Day 5 完成标志：用手捂住 SHT30 升温到阈值以上 → 蜂鸣器急促响、OLED 全屏闪烁告警、

继电器吸合、MQTT 收到告警消息、上位机告警卡片变红；松开手温度回落到阈值 90% 以下 → 自动恢复，继电器断开，蜂鸣器停止。按键 * 进入阈值设置模式，2/8 选择和调整，A 保存 到 Flash，重启后阈值不丢失。PyQt5 上位机显示六路实时数据和曲线，点击继电器按钮可 远程控制。连续运行 1 小时告警功能正常。
