Zhangjiexi229/SMART-M/uploaded_image.png

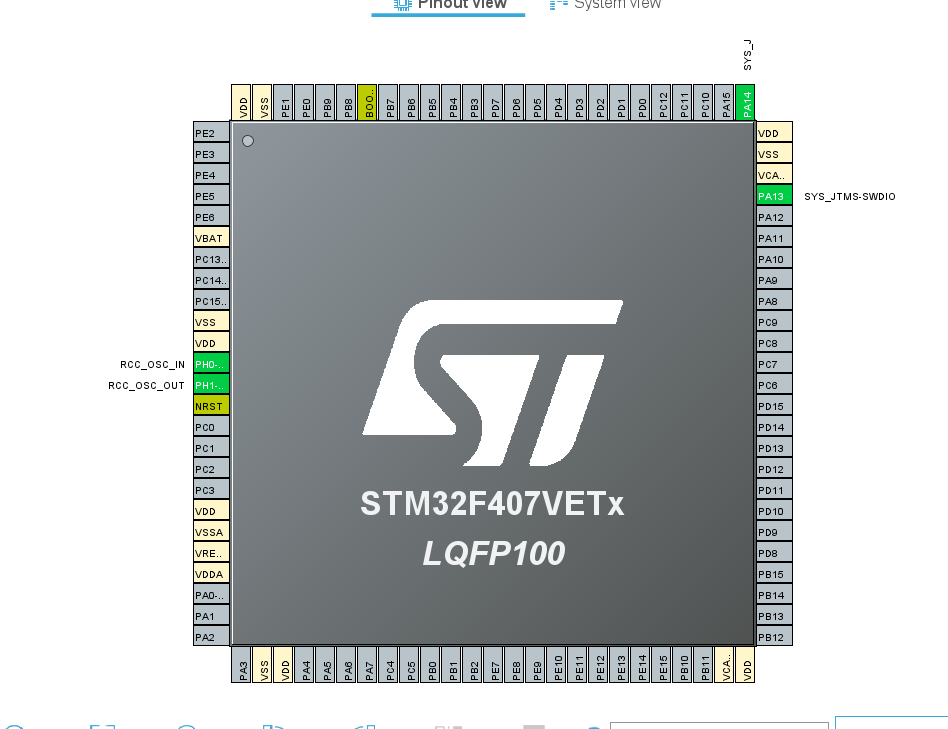
uploaded_image.png
