Zhangjiexi229/SMART-M/user_upload_1445.png

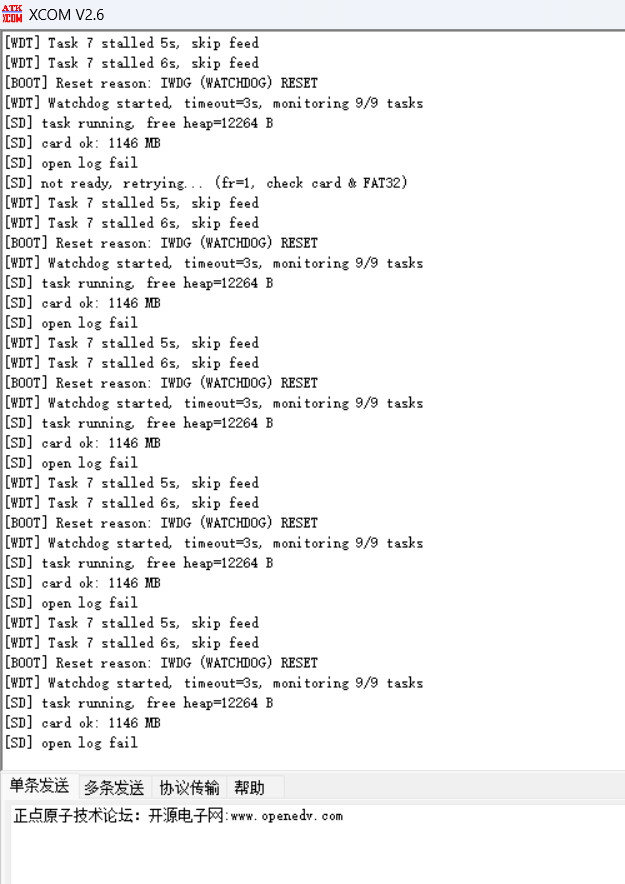
user_upload_1445.png
