Zhangjiexi229/SMART-M/文档/INA226模块照片.jpg

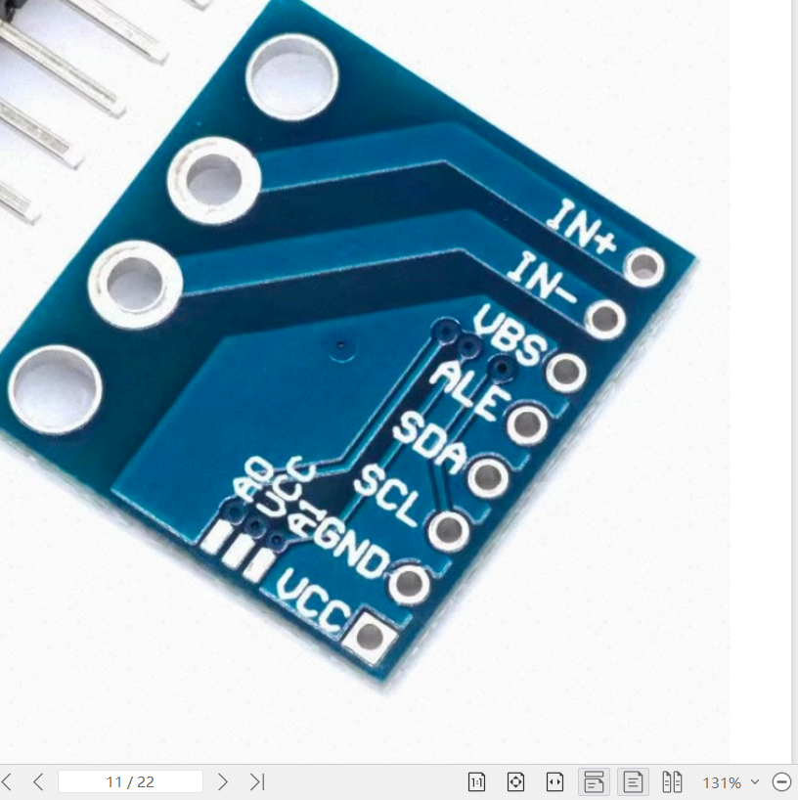
文档/INA226模块照片.jpg
