Zhangjiexi229/SMART-M/文档/sch_led23.png

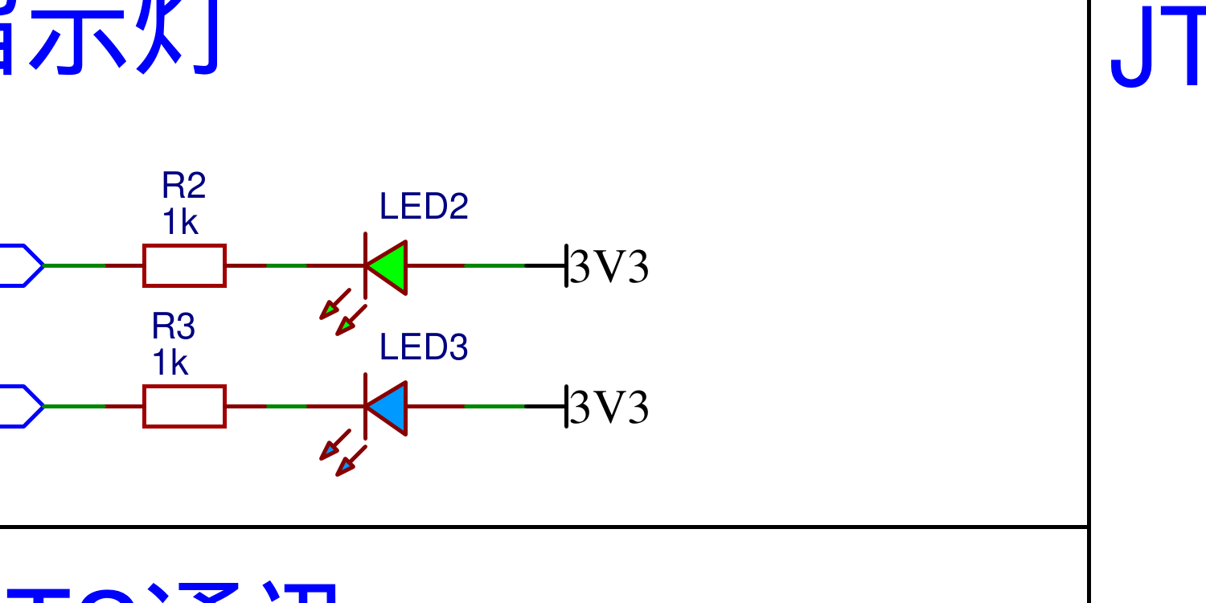
文档/sch_led23.png
