Zhangjiexi229/SMART-M/文档/sch_led_ind.png

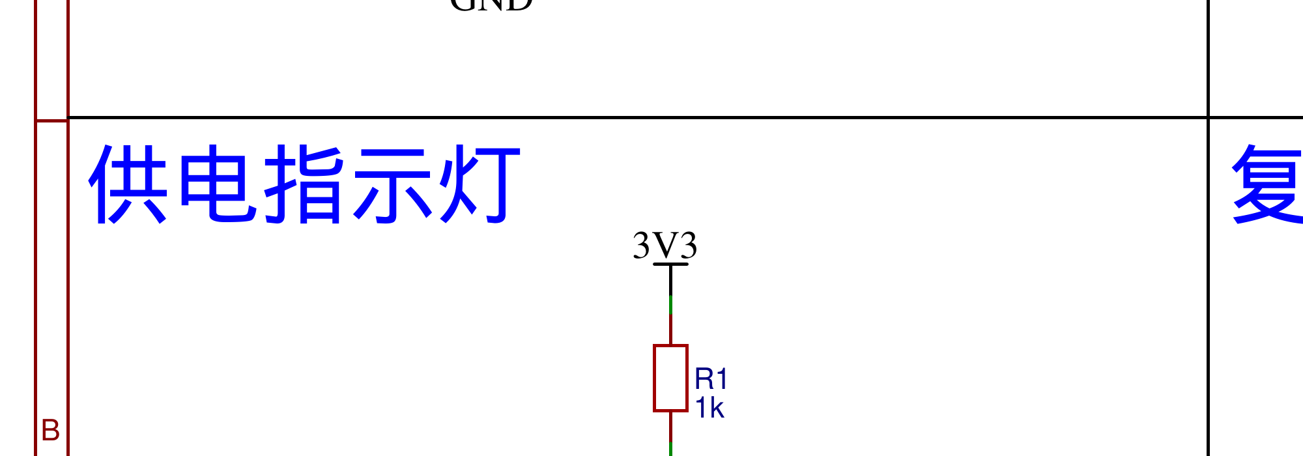
文档/sch_led_ind.png
