Zhangjiexi229/SMART-M/文档/sch_led_left.png

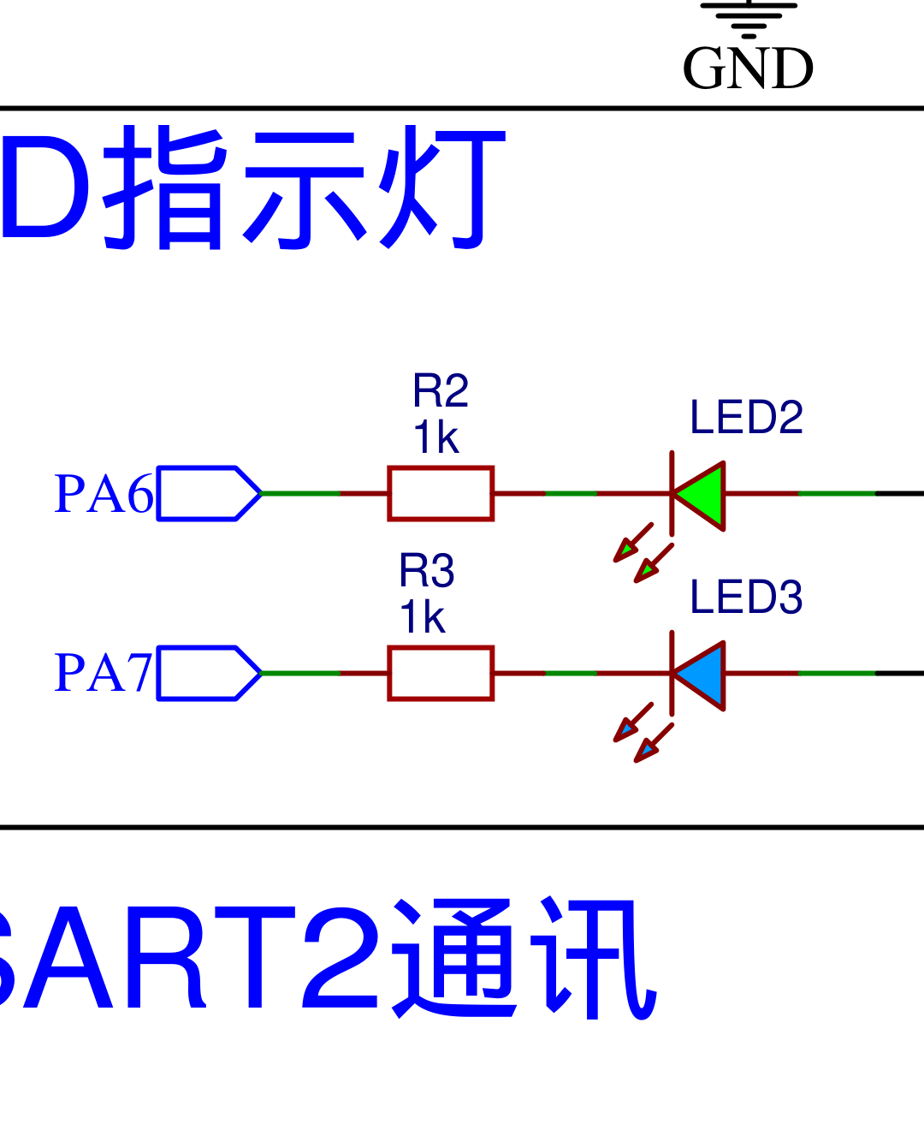
文档/sch_led_left.png
