Zhangjiexi229/SMART-M/文档/sch_led_whole.png

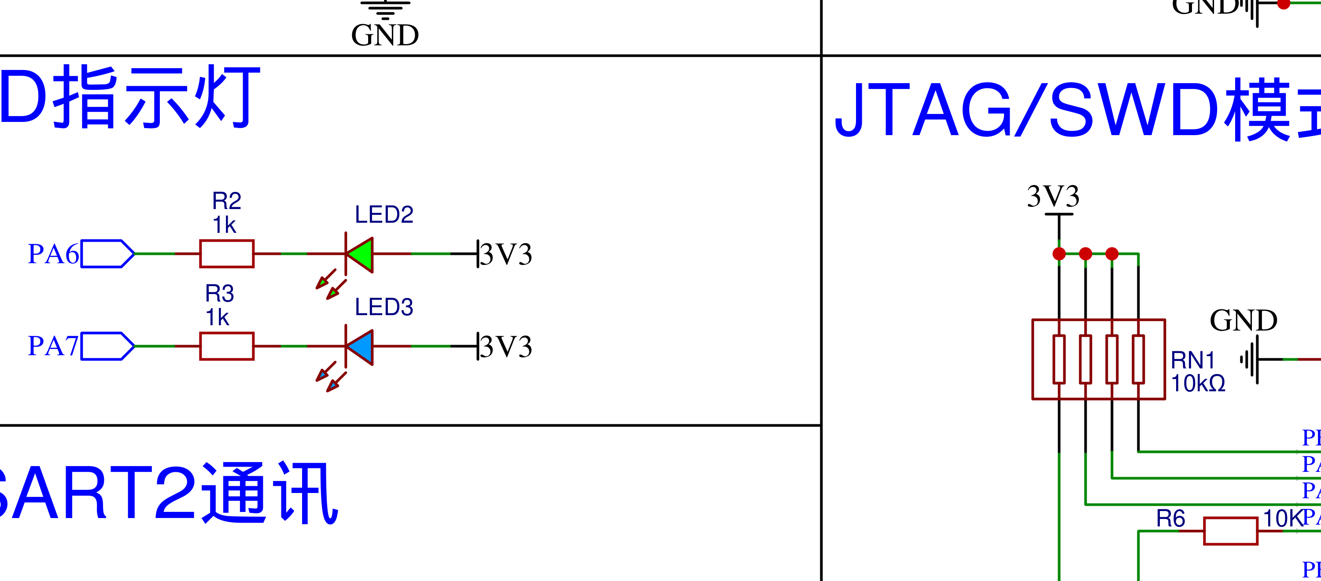
文档/sch_led_whole.png
