Zhangjiexi229/SMART-M/文档/sch_wkup.png

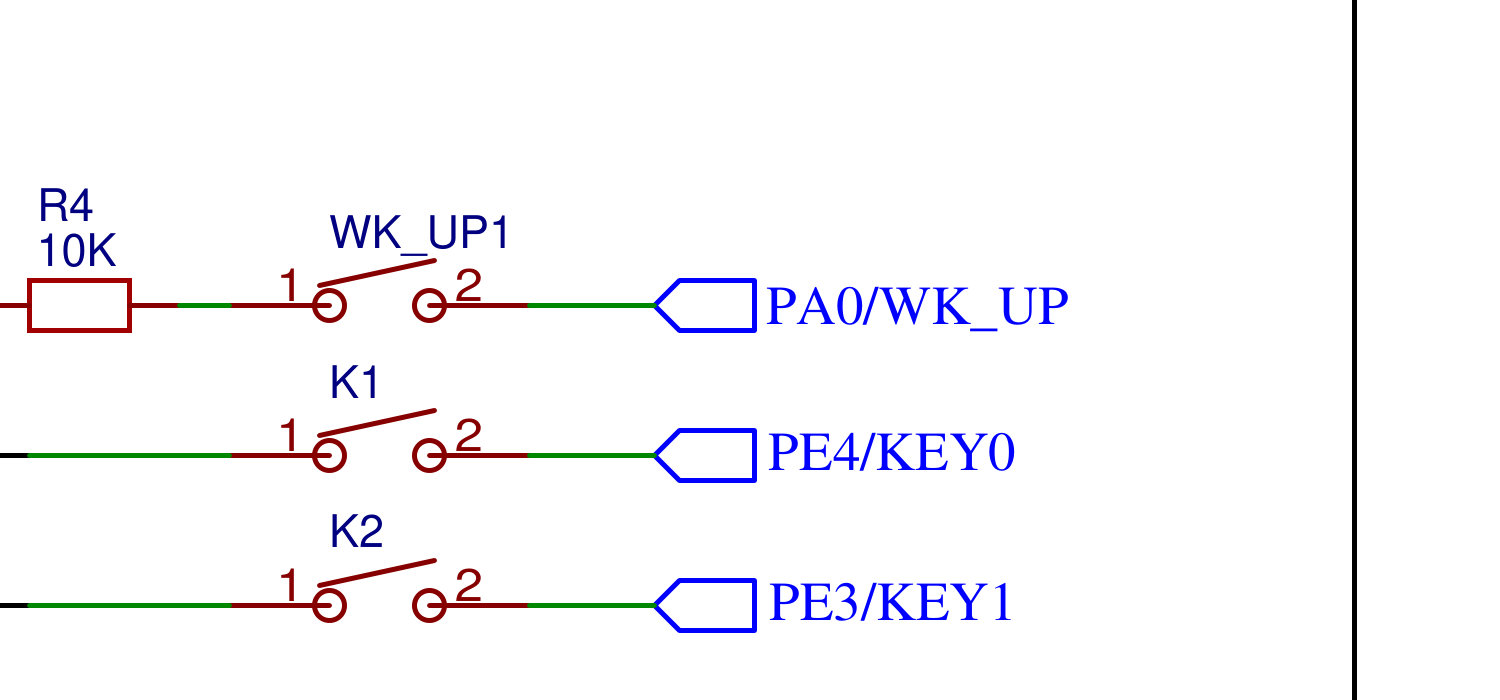
文档/sch_wkup.png
