Zhangjiexi229/SMART-M/文档/tmp_继电器图_2.png

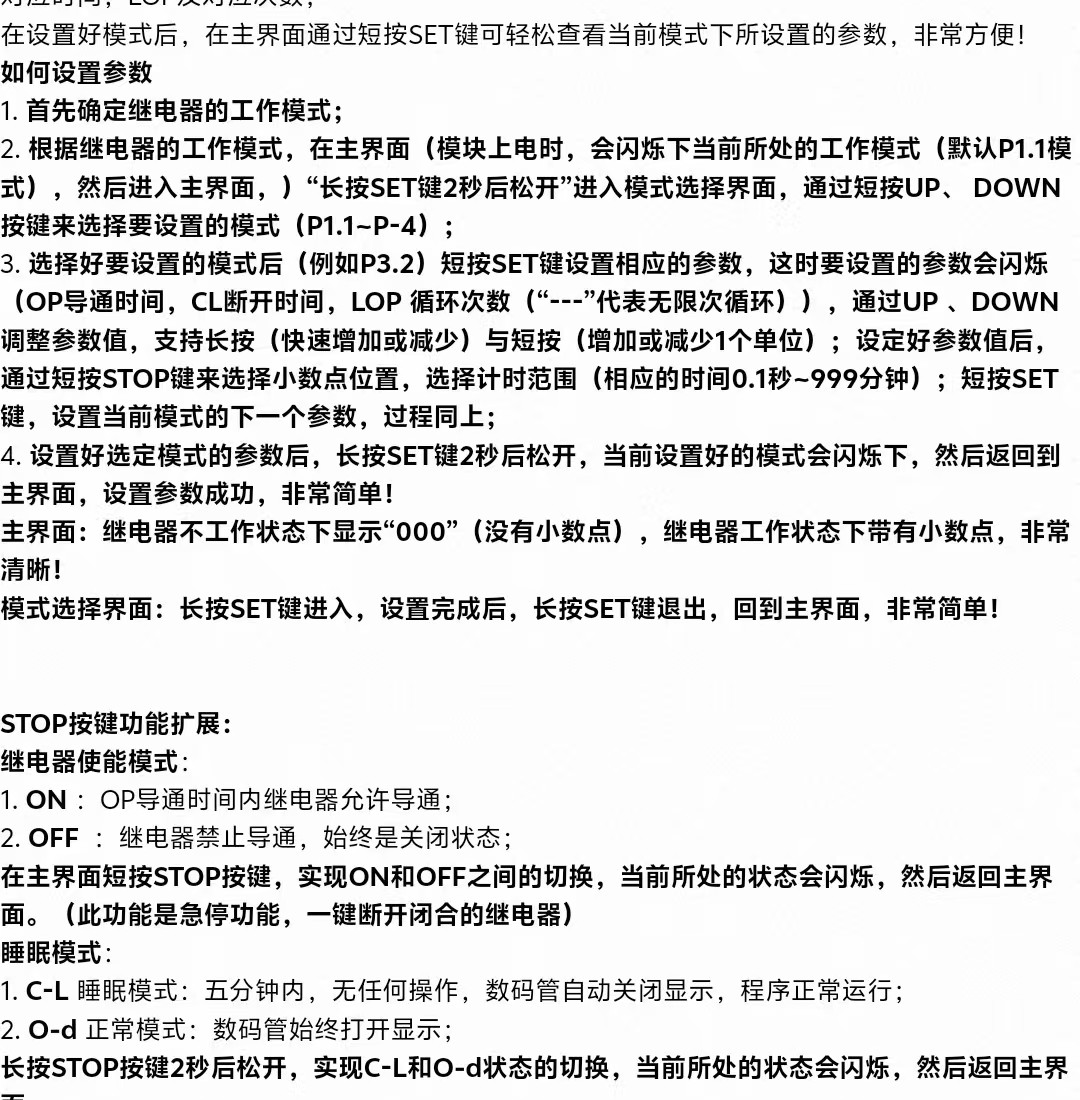
文档/tmp_继电器图_2.png
