Zhangjiexi229/SMART-M/文档/截图_30V端子.jpg

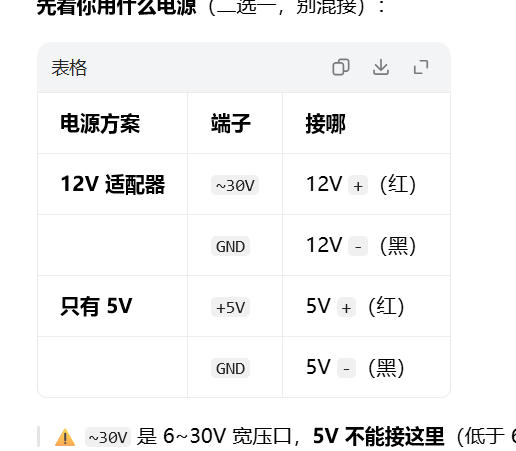
文档/截图_30V端子.jpg
