Zhangjiexi229/SMART-M/文档/截图_AT测试.png

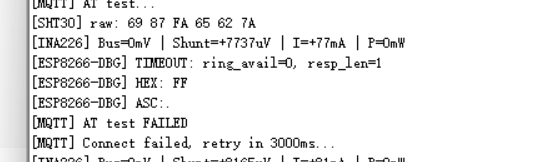
文档/截图_AT测试.png
