Zhangjiexi229/SMART-M/文档/截图_I2C时序修复.png

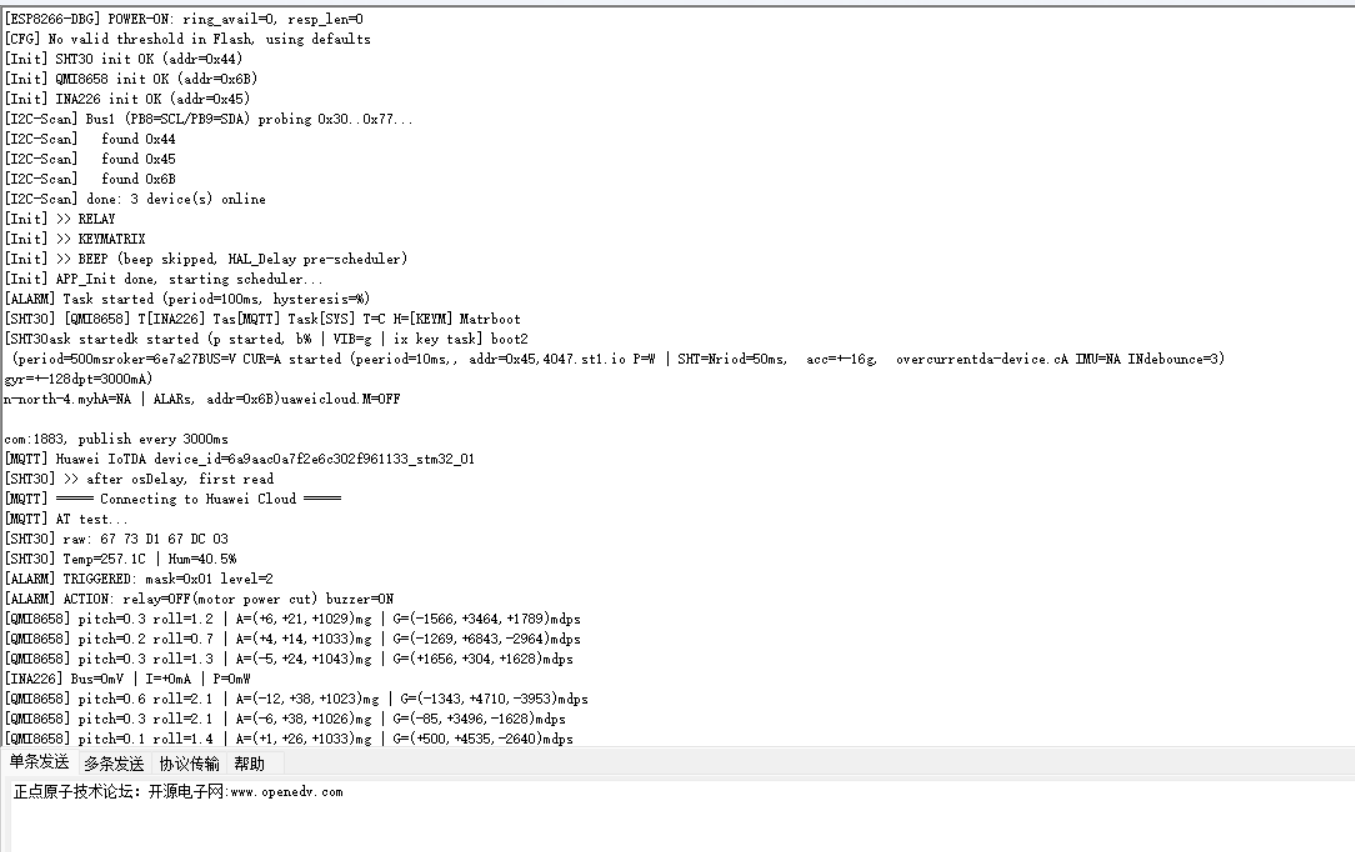
文档/截图_I2C时序修复.png
