Zhangjiexi229/SMART-M/文档/截图_INA226_shunt读数2.png

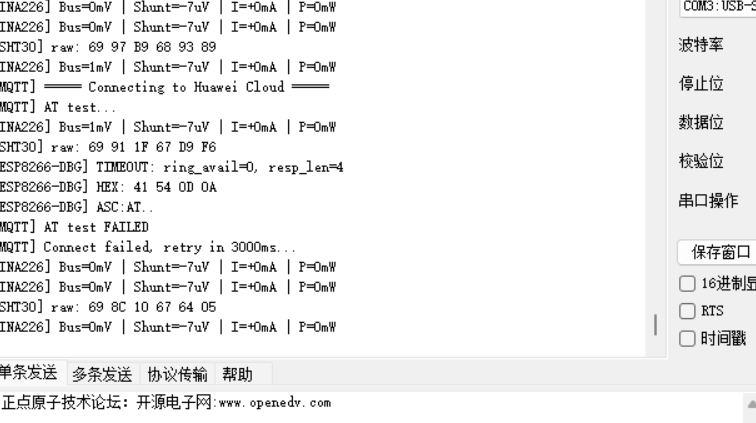
文档/截图_INA226_shunt读数2.png
