Zhangjiexi229/SMART-M/文档/截图_INA226_电流读数.png

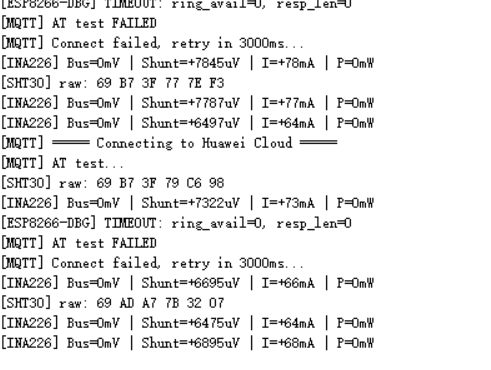
文档/截图_INA226_电流读数.png
