Zhangjiexi229/SMART-M/文档/截图_INA226模块.png

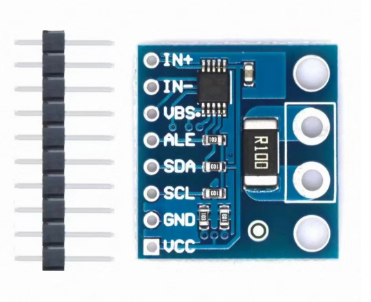
文档/截图_INA226模块.png
