Zhangjiexi229/SMART-M/文档/截图_INA226诊断.jpg

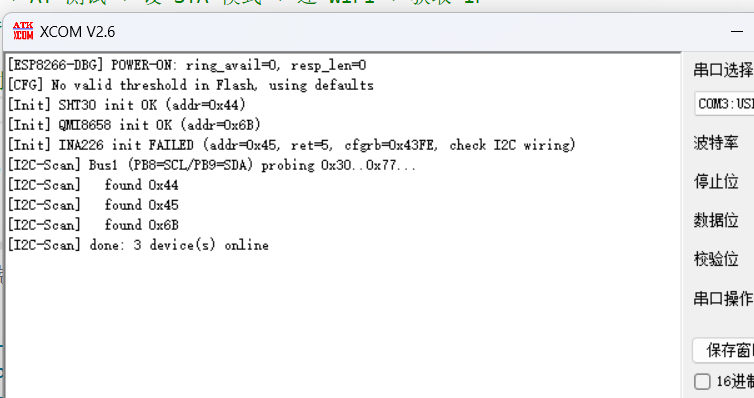
文档/截图_INA226诊断.jpg
