Zhangjiexi229/SMART-M/文档/截图_INA226读数.png

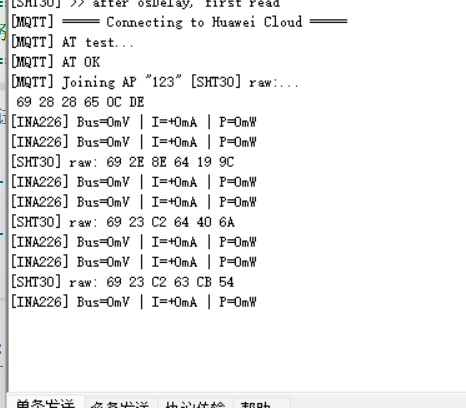
文档/截图_INA226读数.png
