Zhangjiexi229/SMART-M/文档/截图_MQTT测试2.png

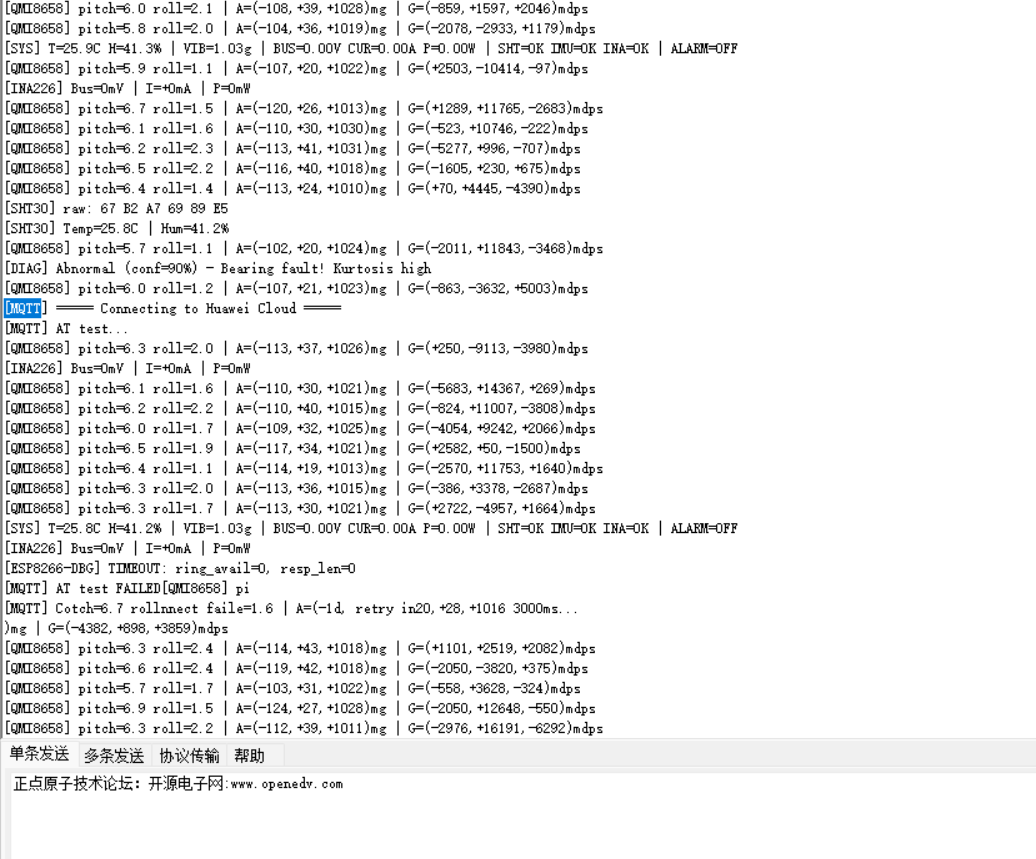
文档/截图_MQTT测试2.png
