Zhangjiexi229/SMART-M/文档/截图_MQTT测试.png

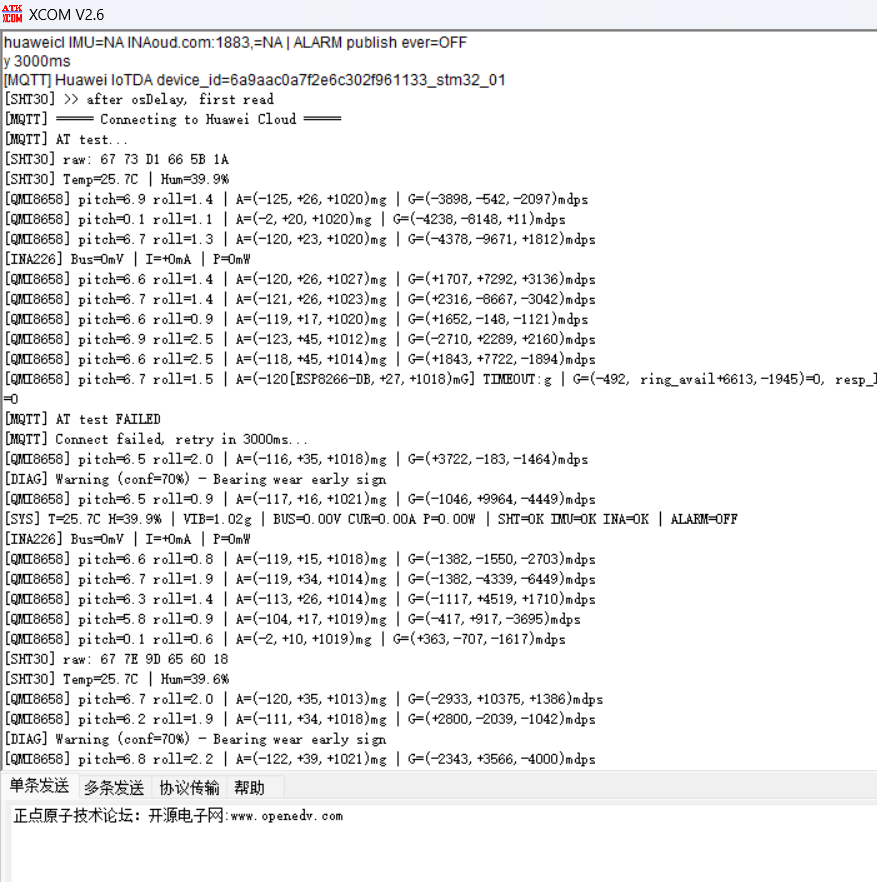
文档/截图_MQTT测试.png
