Zhangjiexi229/SMART-M/文档/截图_MQTT连接成功2.png

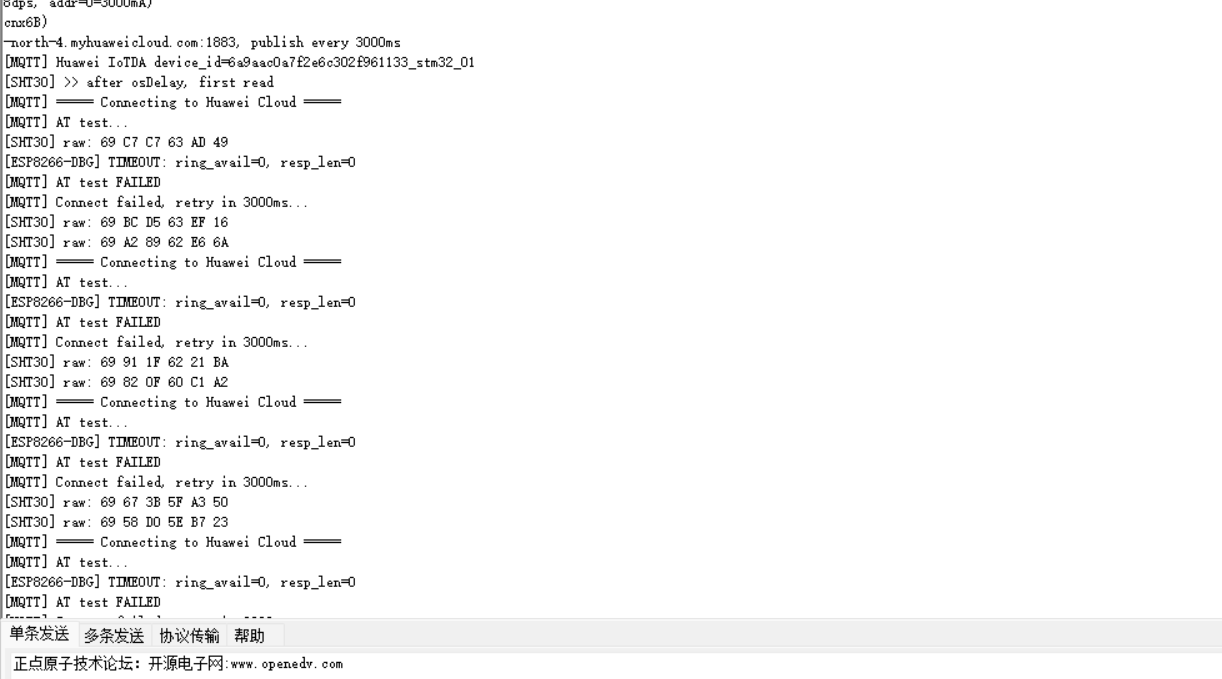
文档/截图_MQTT连接成功2.png
