Zhangjiexi229/SMART-M/文档/截图_MQTT连接成功.png

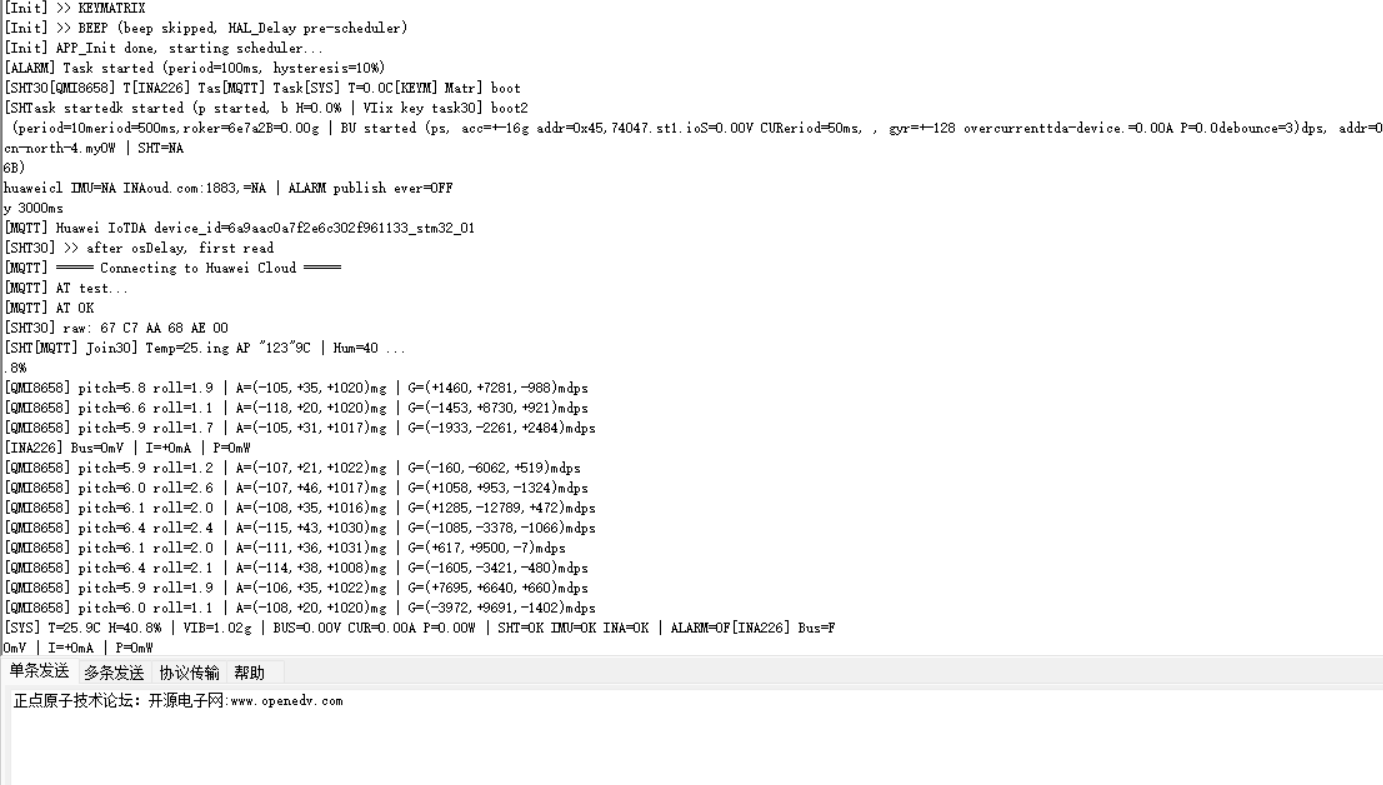
文档/截图_MQTT连接成功.png
