Zhangjiexi229/SMART-M/文档/截图_OLED关闭后.png

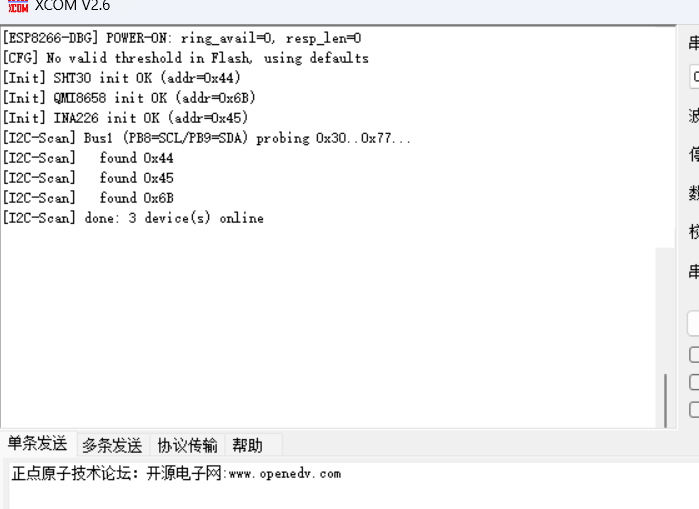
文档/截图_OLED关闭后.png
