Zhangjiexi229/SMART-M/文档/截图_SHT30等待50ms.png

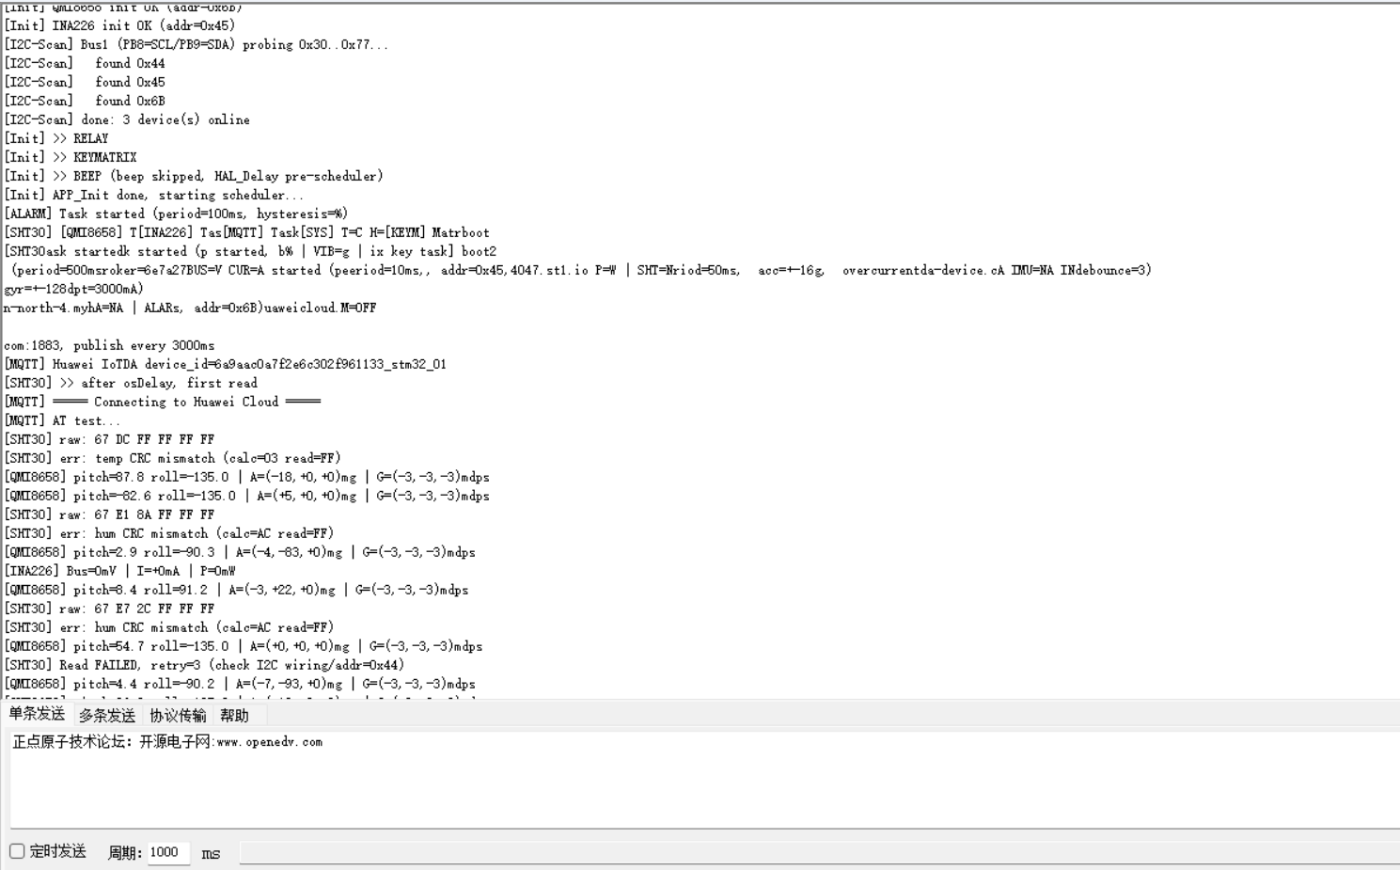
文档/截图_SHT30等待50ms.png
