Zhangjiexi229/SMART-M/文档/截图_SHT30诊断2.png

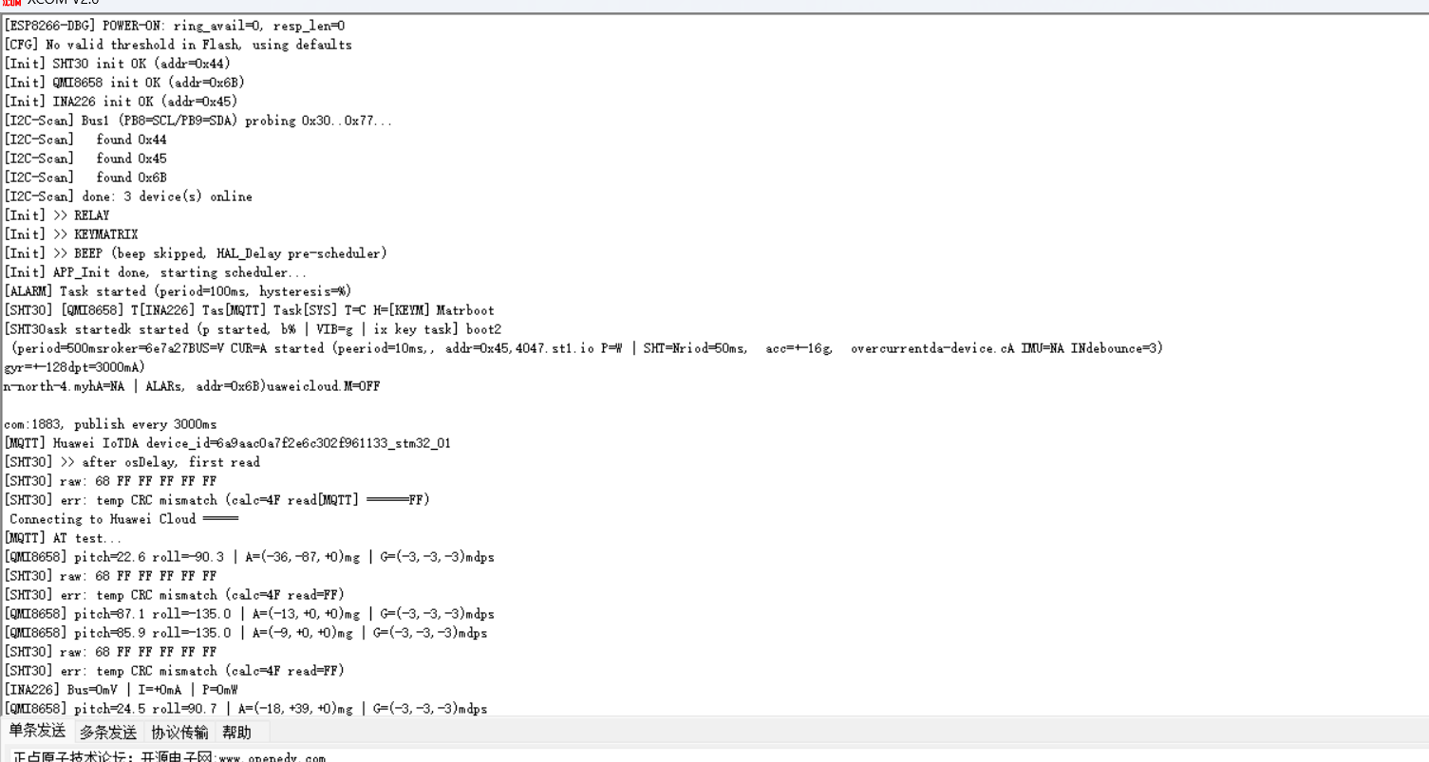
文档/截图_SHT30诊断2.png
