Zhangjiexi229/SMART-M/文档/截图_SHT30诊断.png

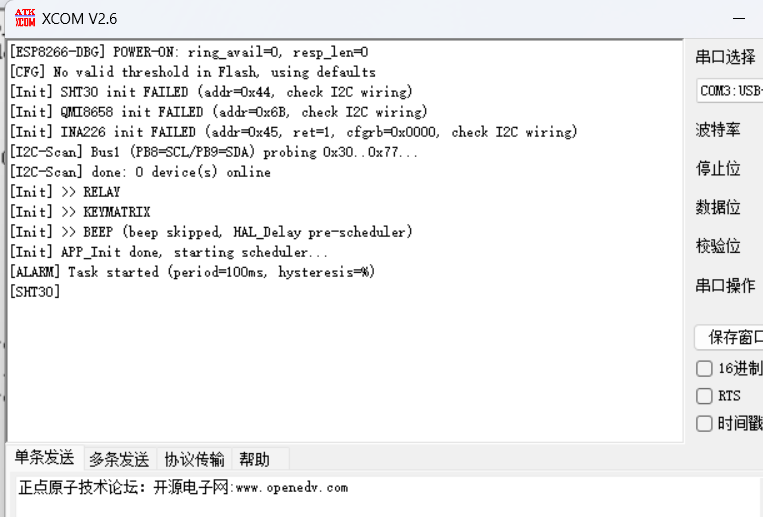
文档/截图_SHT30诊断.png
