Zhangjiexi229/SMART-M/文档/截图_SYS出来了.png

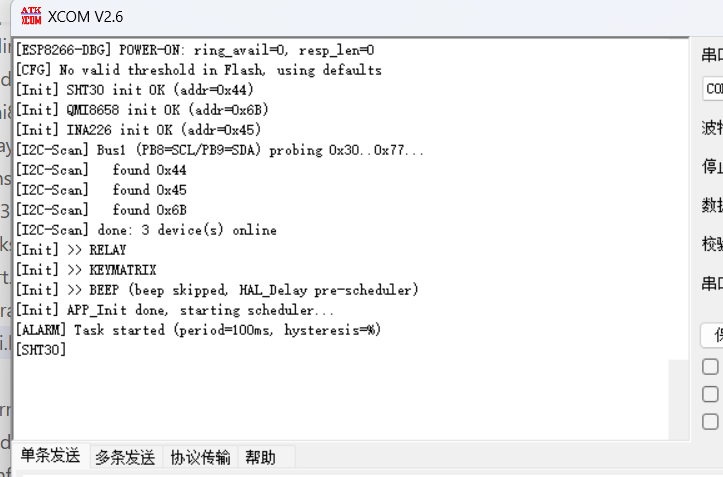
文档/截图_SYS出来了.png
