Zhangjiexi229/SMART-M/文档/截图_SYS数据行.png

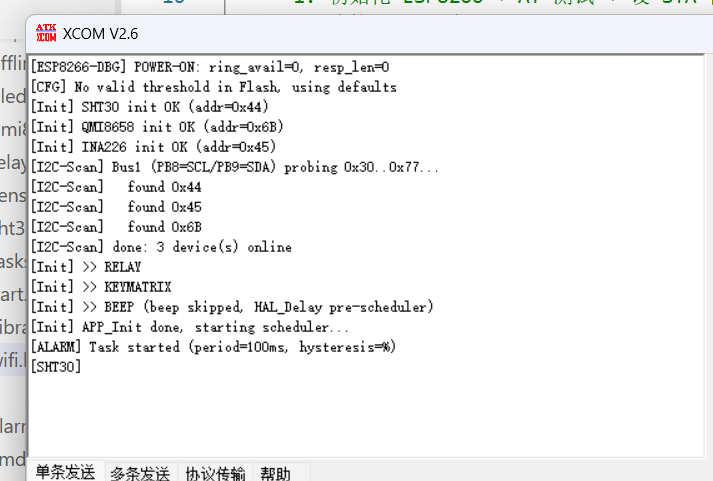
文档/截图_SYS数据行.png
