Zhangjiexi229/SMART-M/文档/截图_三传感器全通.jpg

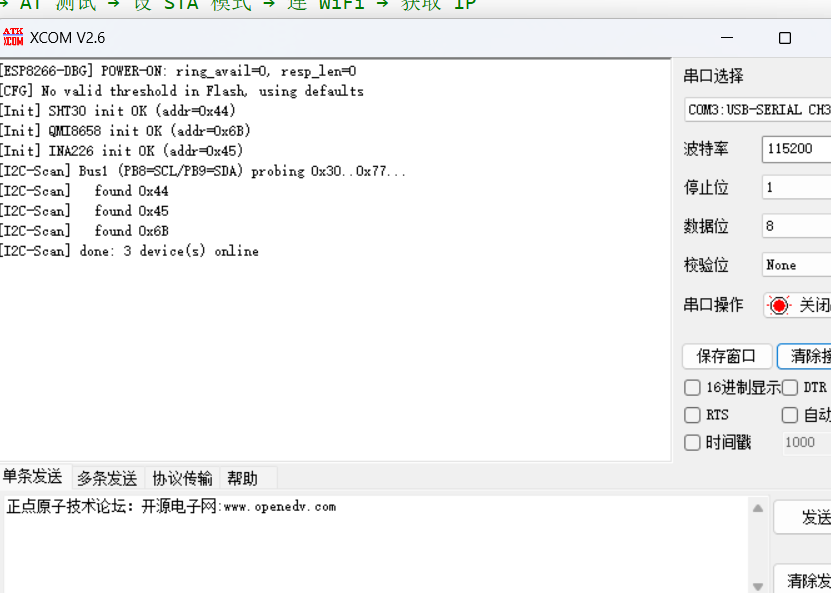
文档/截图_三传感器全通.jpg
