Zhangjiexi229/SMART-M/文档/截图_三传感器验证.jpg

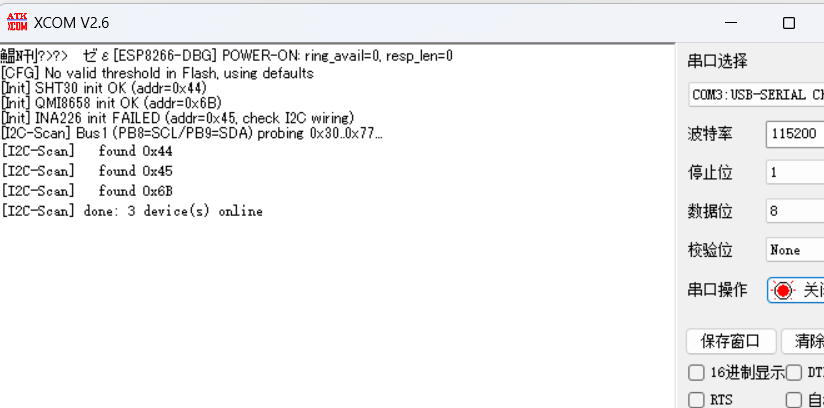
文档/截图_三传感器验证.jpg
