Zhangjiexi229/SMART-M/文档/截图_两个12V.jpg

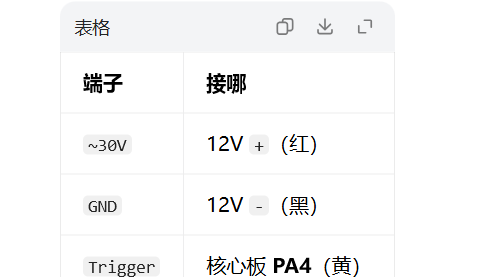
文档/截图_两个12V.jpg
