Zhangjiexi229/SMART-M/文档/截图_串口排查2.jpg

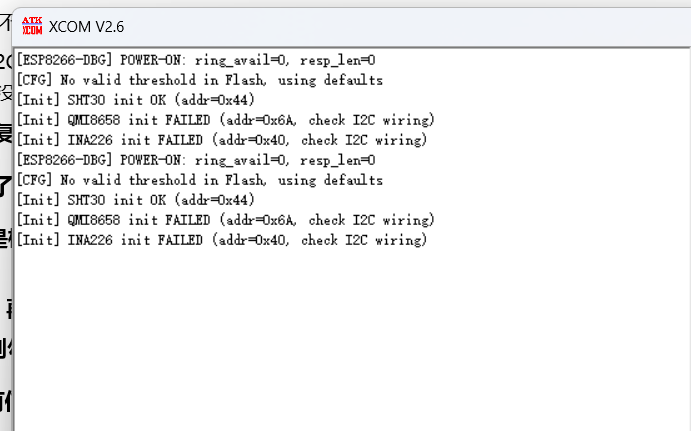
文档/截图_串口排查2.jpg
