Zhangjiexi229/SMART-M/文档/截图_全任务跑通.png

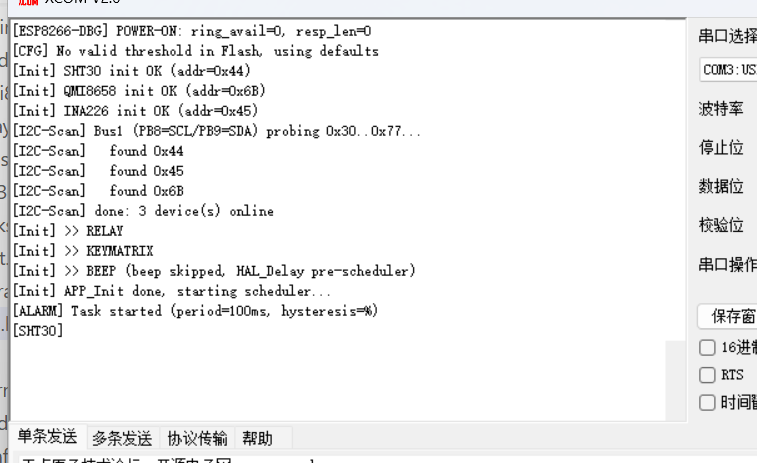
文档/截图_全任务跑通.png
