Zhangjiexi229/SMART-M/文档/截图_卡点诊断.png

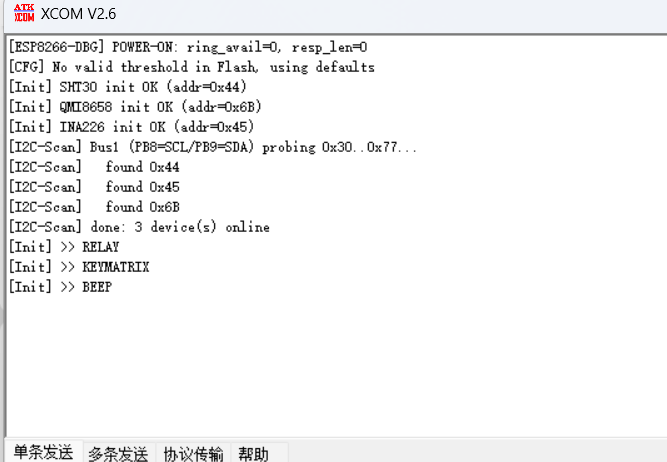
文档/截图_卡点诊断.png
