Zhangjiexi229/SMART-M/文档/截图_寄存器版UART.png

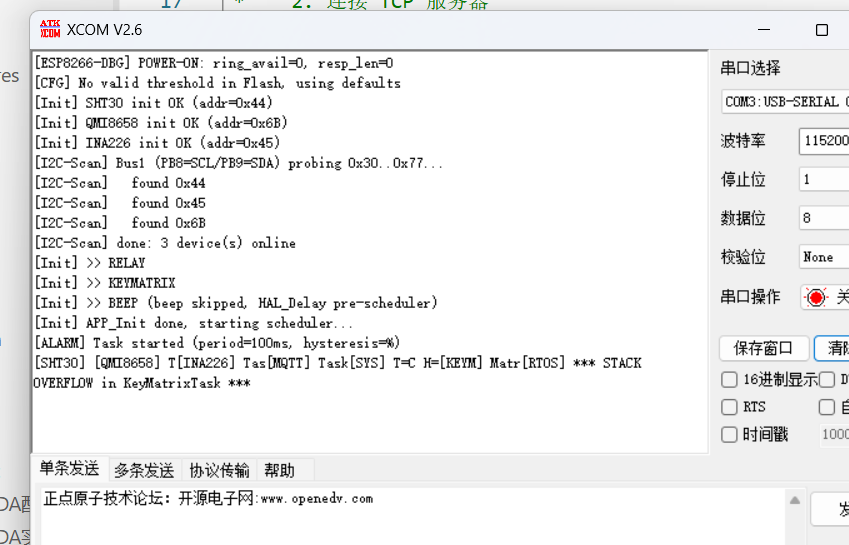
文档/截图_寄存器版UART.png
