Zhangjiexi229/SMART-M/文档/截图_属性列表完成.png

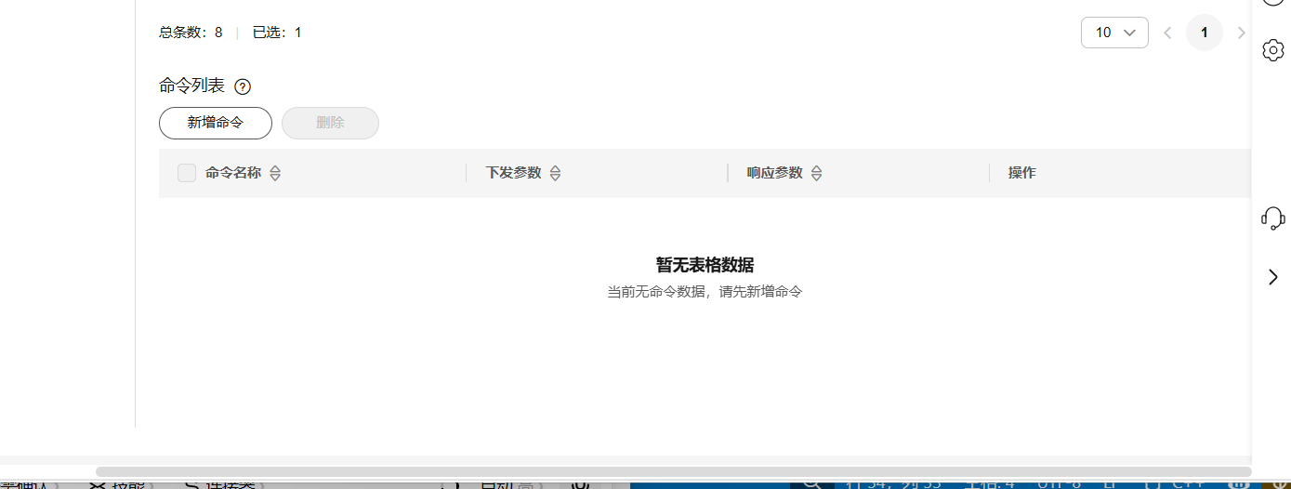
文档/截图_属性列表完成.png
