Zhangjiexi229/SMART-M/文档/截图_属性编辑.png

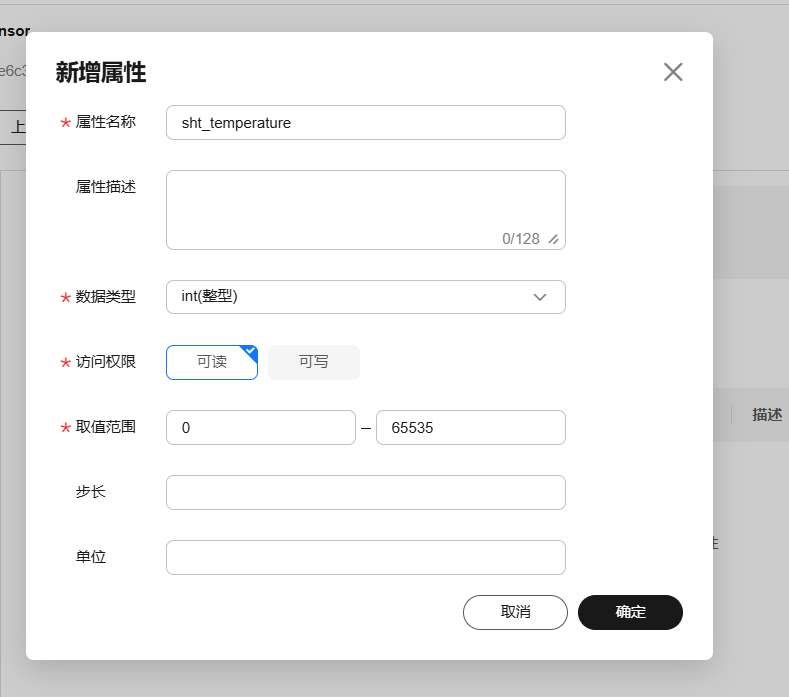
文档/截图_属性编辑.png
