Zhangjiexi229/SMART-M/文档/截图_扫描结果.jpg

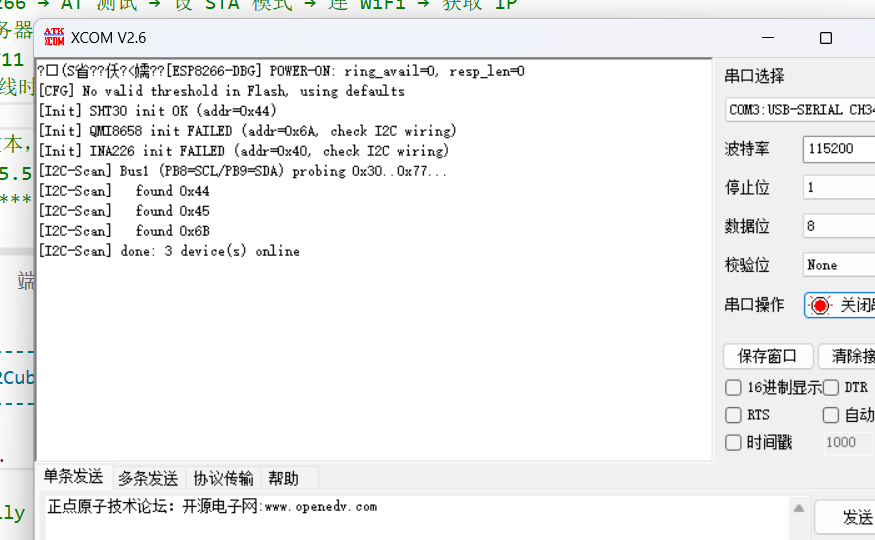
文档/截图_扫描结果.jpg
