Zhangjiexi229/SMART-M/文档/截图_报警测试2.png

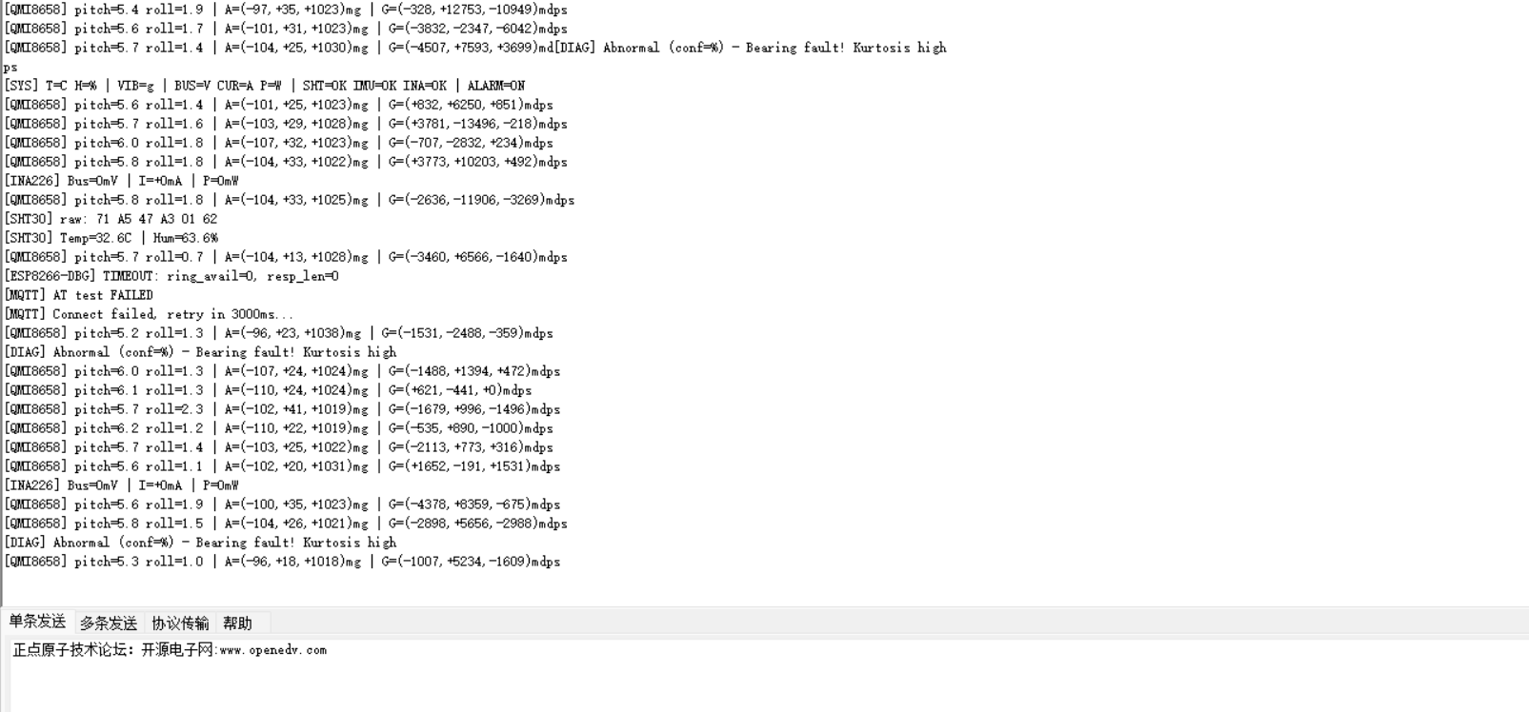
文档/截图_报警测试2.png
