Zhangjiexi229/SMART-M/文档/截图_指认端子.jpg

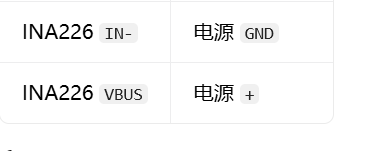
文档/截图_指认端子.jpg
