Zhangjiexi229/SMART-M/文档/截图_按键没反应.png

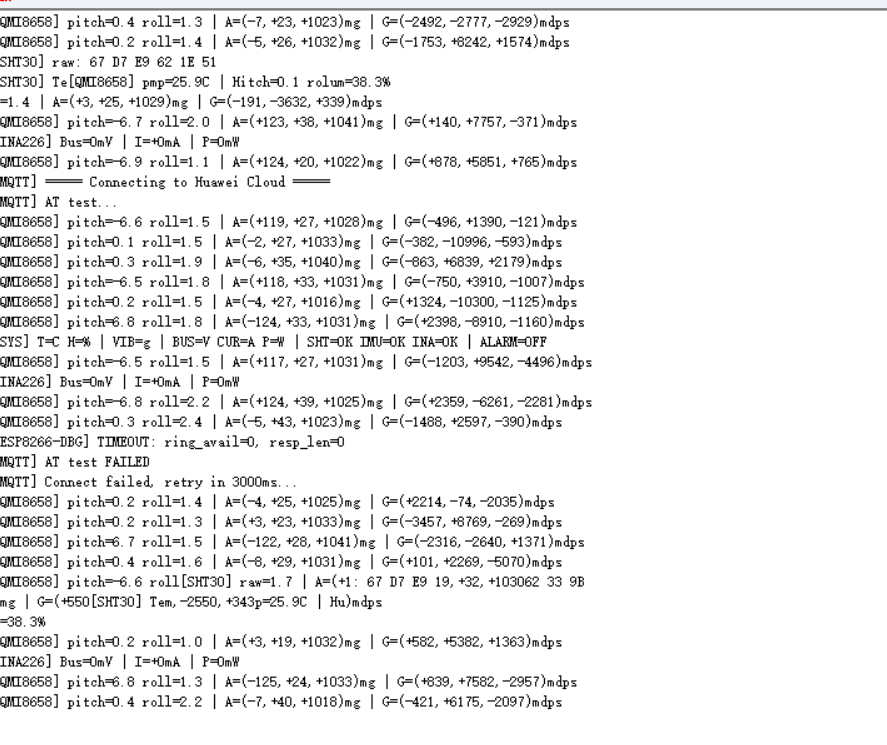
文档/截图_按键没反应.png
