Zhangjiexi229/SMART-M/文档/截图_按键测试.png

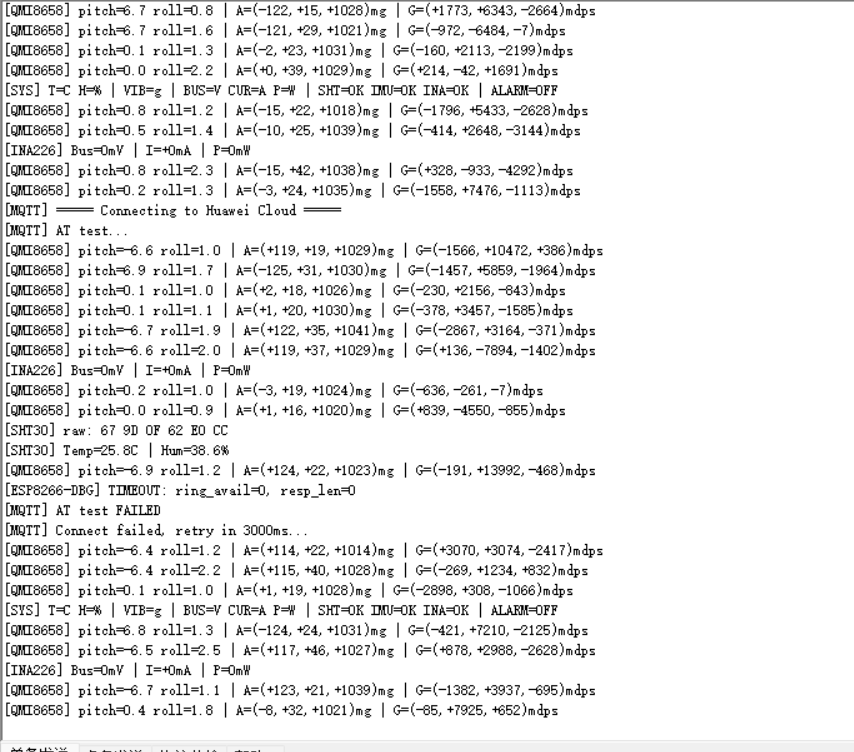
文档/截图_按键测试.png
