Zhangjiexi229/SMART-M/文档/截图_按键诊断.png

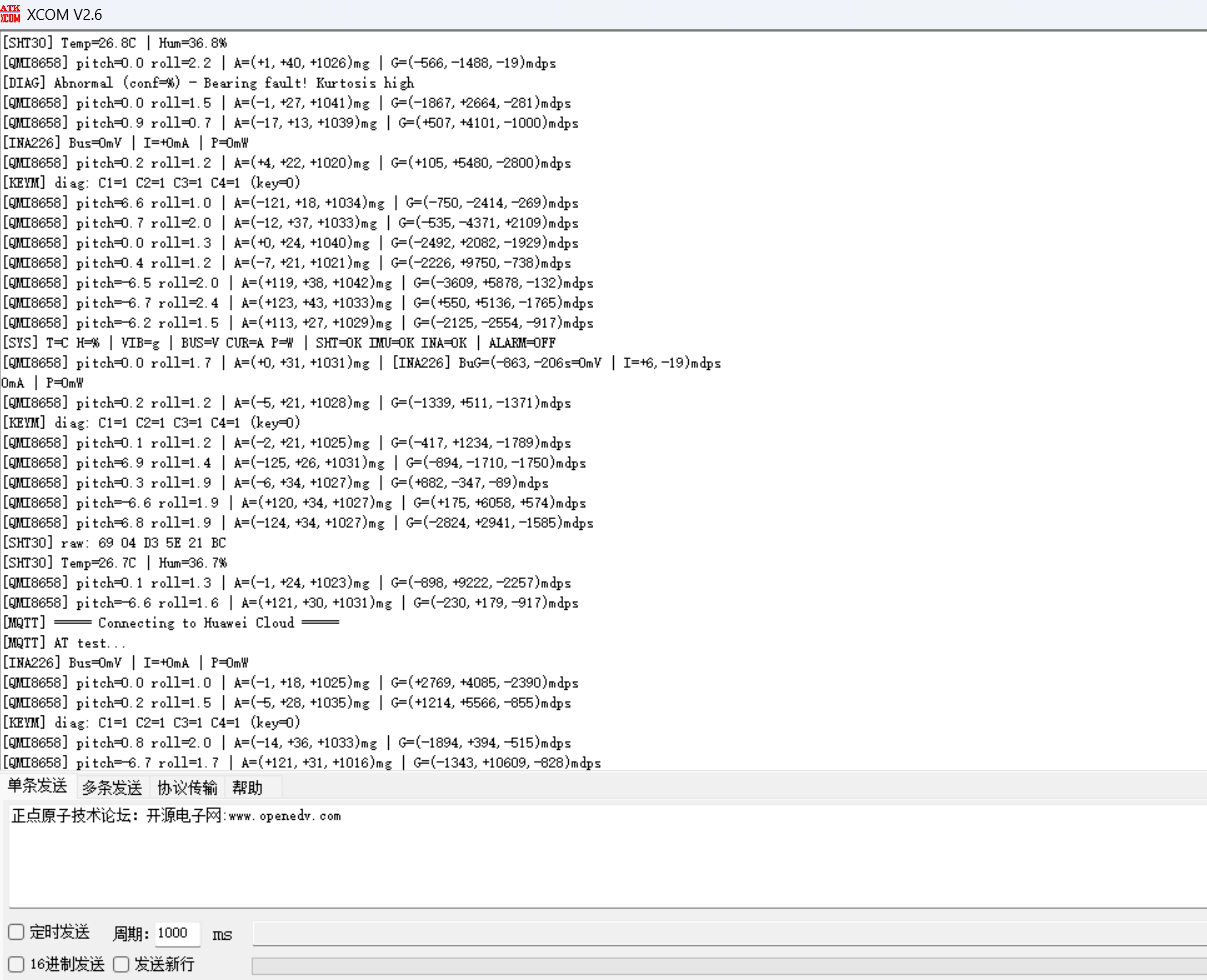
文档/截图_按键诊断.png
