Zhangjiexi229/SMART-M/文档/截图_改WiFi配置.png

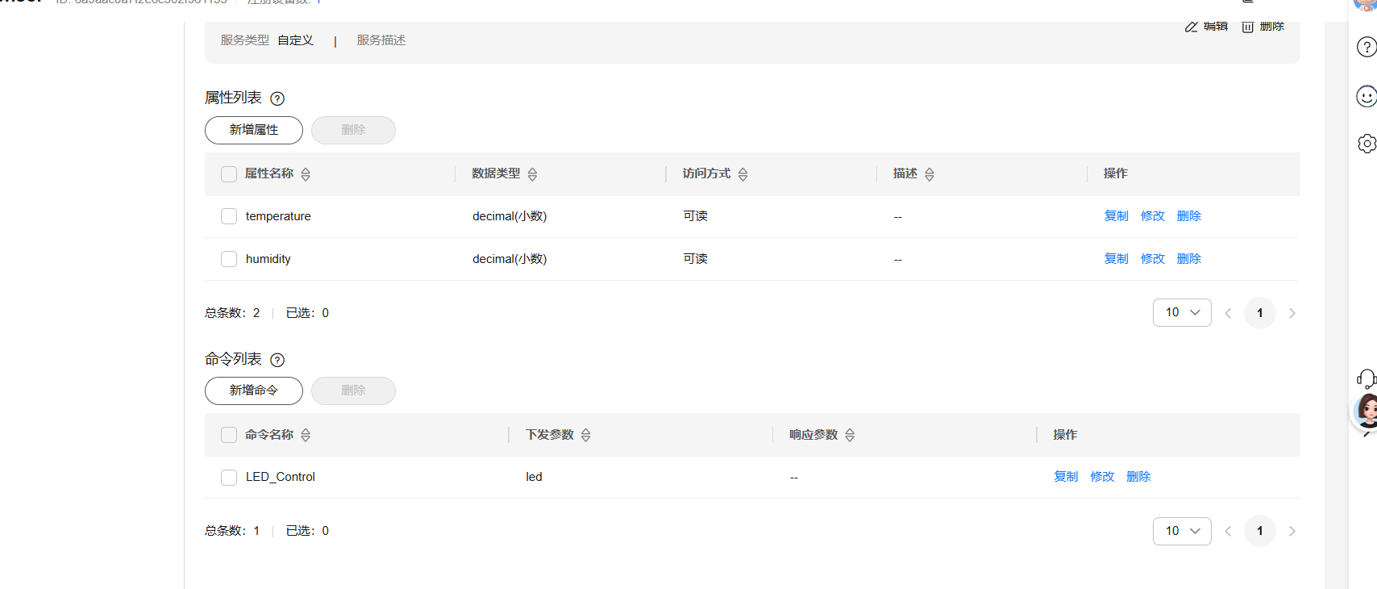
文档/截图_改WiFi配置.png
