Zhangjiexi229/SMART-M/文档/截图_新ESP8266测试.png

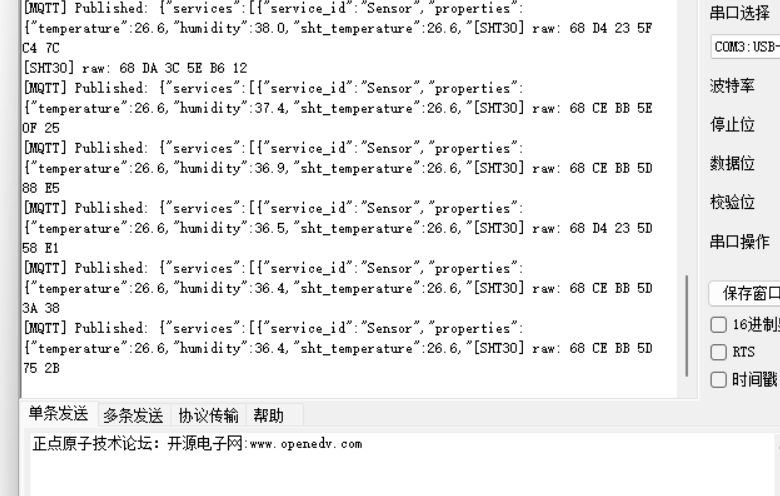
文档/截图_新ESP8266测试.png
