Zhangjiexi229/SMART-M/文档/截图_无变化.png

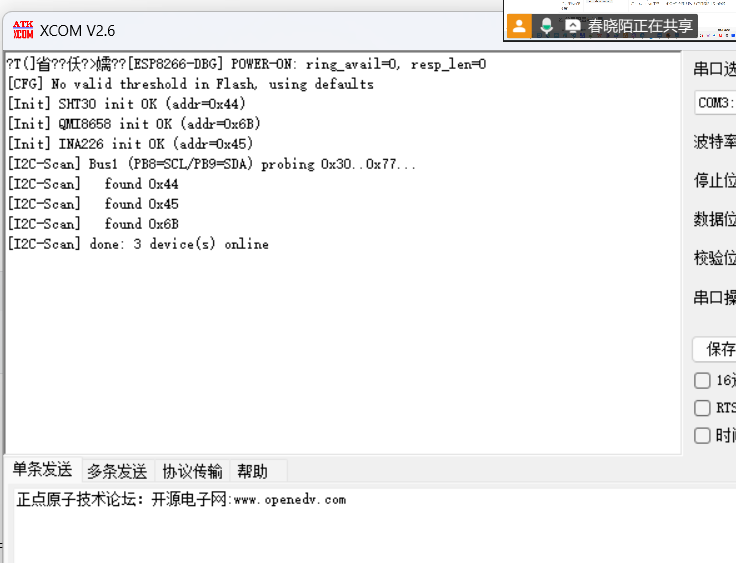
文档/截图_无变化.png
