Zhangjiexi229/SMART-M/文档/截图_无湿度.png

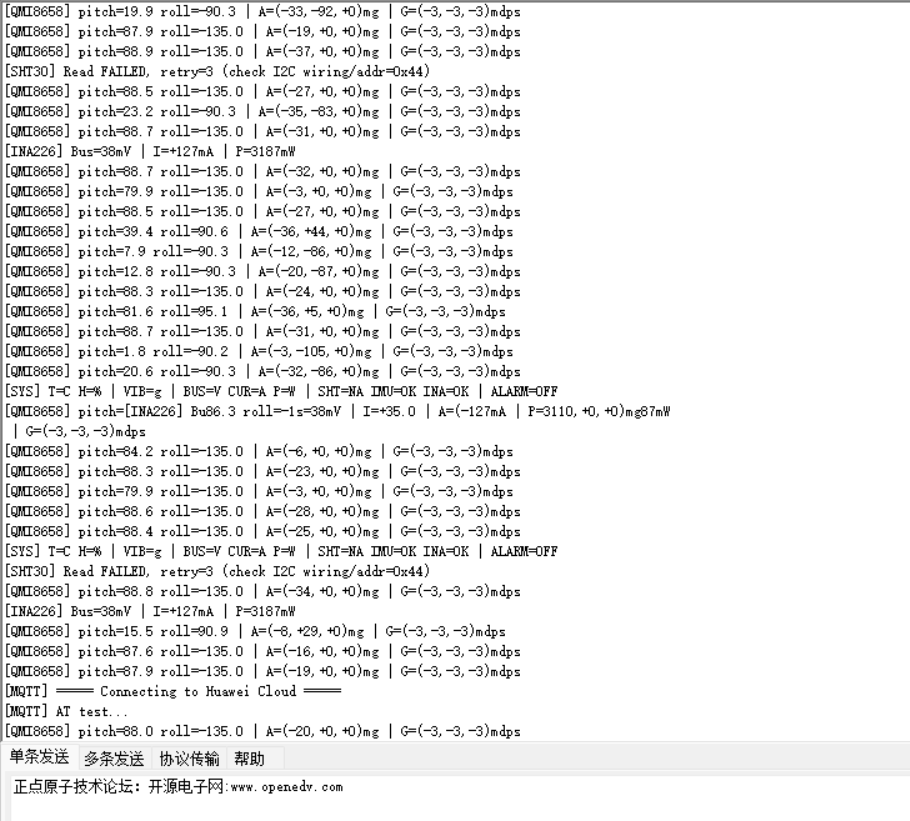
文档/截图_无湿度.png
