Zhangjiexi229/SMART-M/文档/截图_最简打印版.png

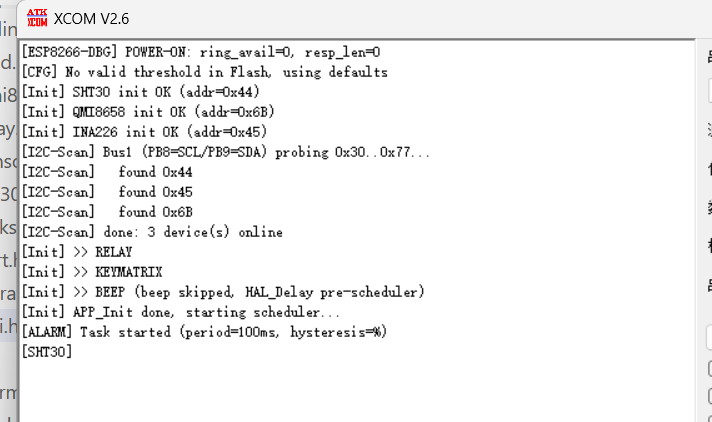
文档/截图_最简打印版.png
