Zhangjiexi229/SMART-M/文档/截图_栈增大版.png

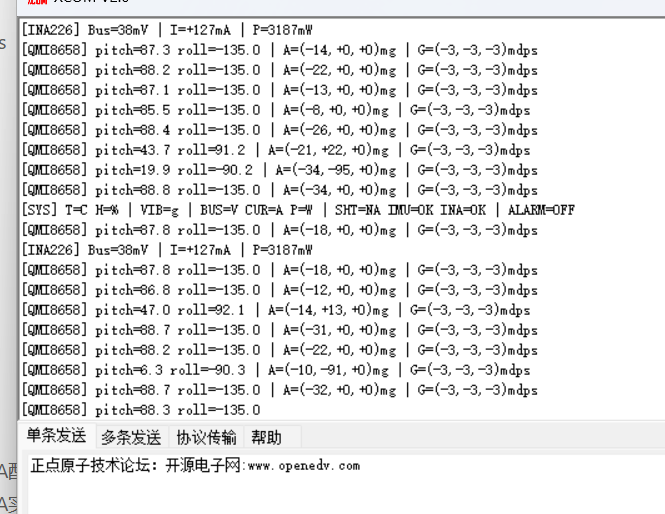
文档/截图_栈增大版.png
