Zhangjiexi229/SMART-M/文档/截图_检查接线后.png

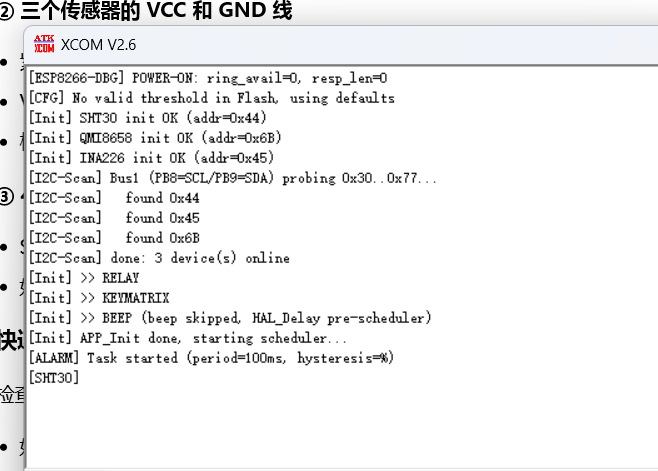
文档/截图_检查接线后.png
