Zhangjiexi229/SMART-M/文档/截图_正常扫描测试.png

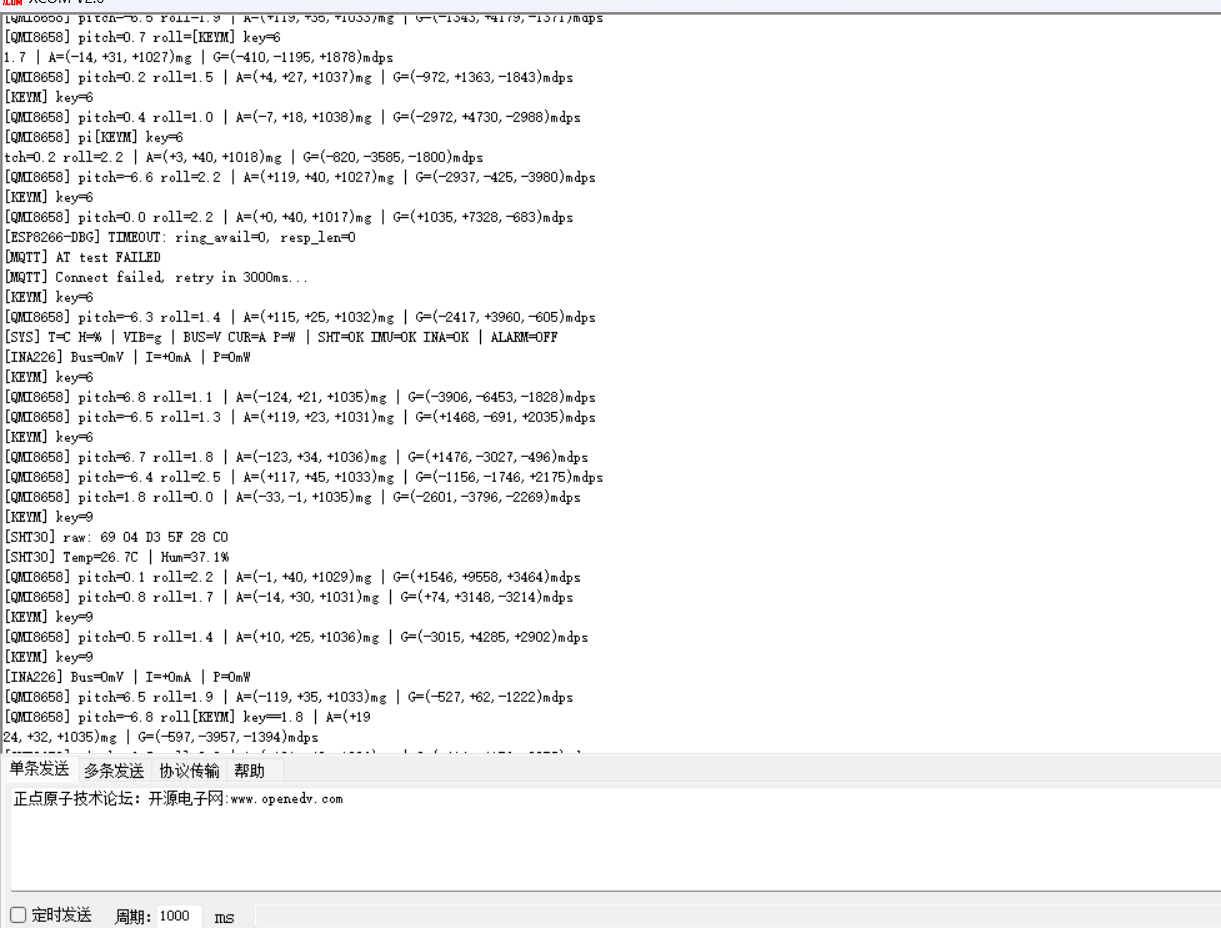
文档/截图_正常扫描测试.png
