Zhangjiexi229/SMART-M/文档/截图_温度修复.png

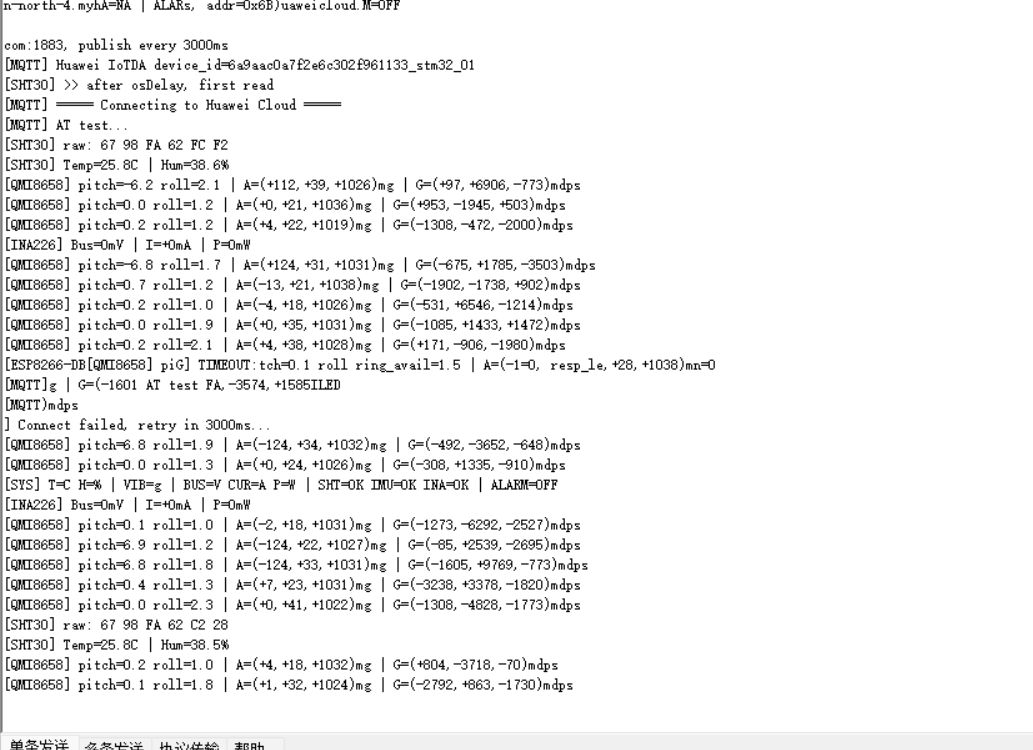
文档/截图_温度修复.png
