Zhangjiexi229/SMART-M/文档/截图_烧录检查.jpg

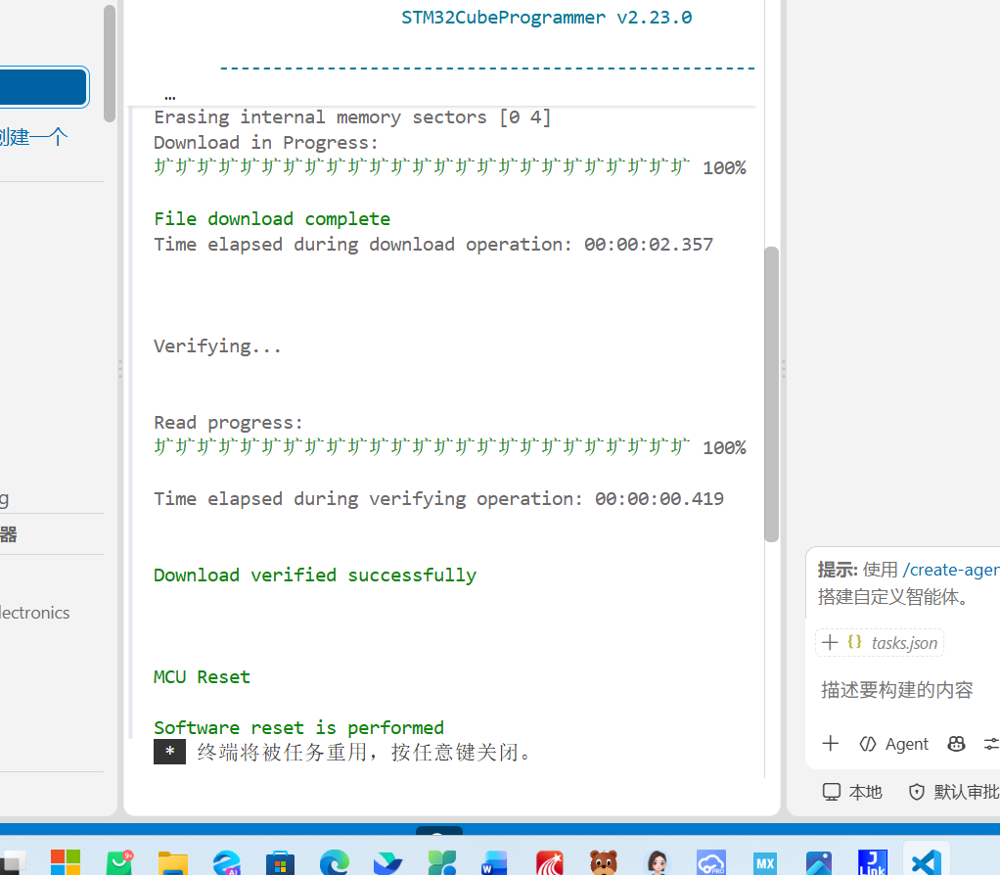
文档/截图_烧录检查.jpg
