Zhangjiexi229/SMART-M/文档/截图_电机上电验证.png

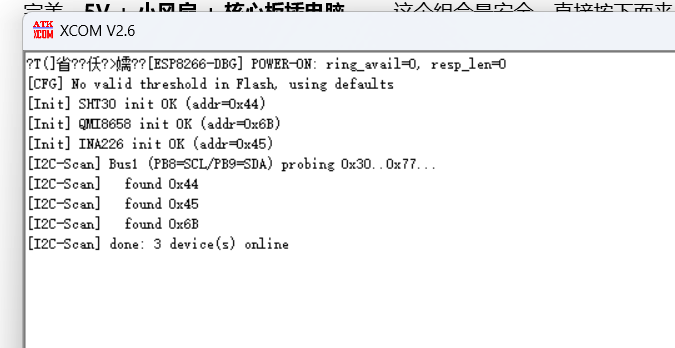
文档/截图_电机上电验证.png
