Zhangjiexi229/SMART-M/文档/截图_蜂鸣器测试.png

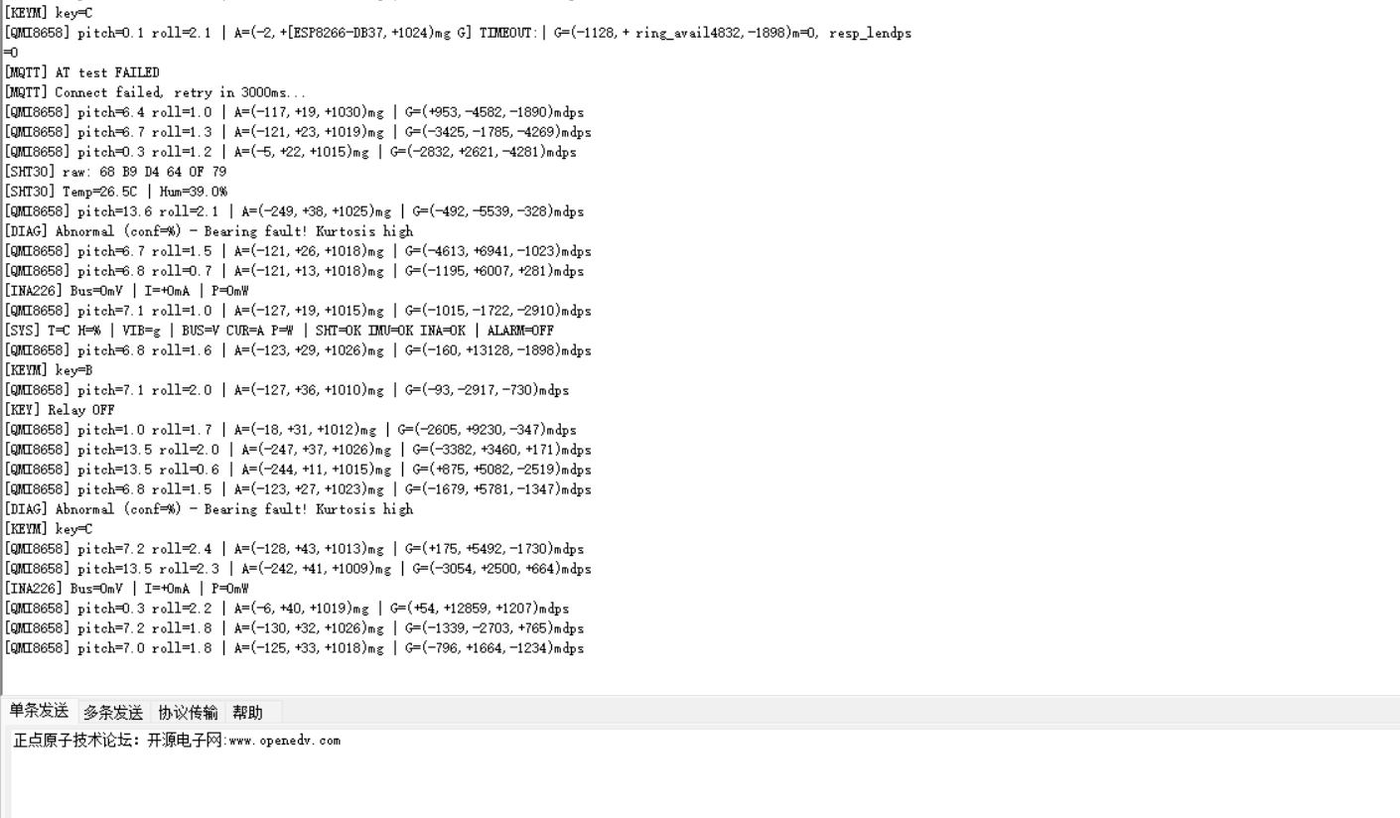
文档/截图_蜂鸣器测试.png
