Zhangjiexi229/SMART-M/文档/截图_行列交换测试.png

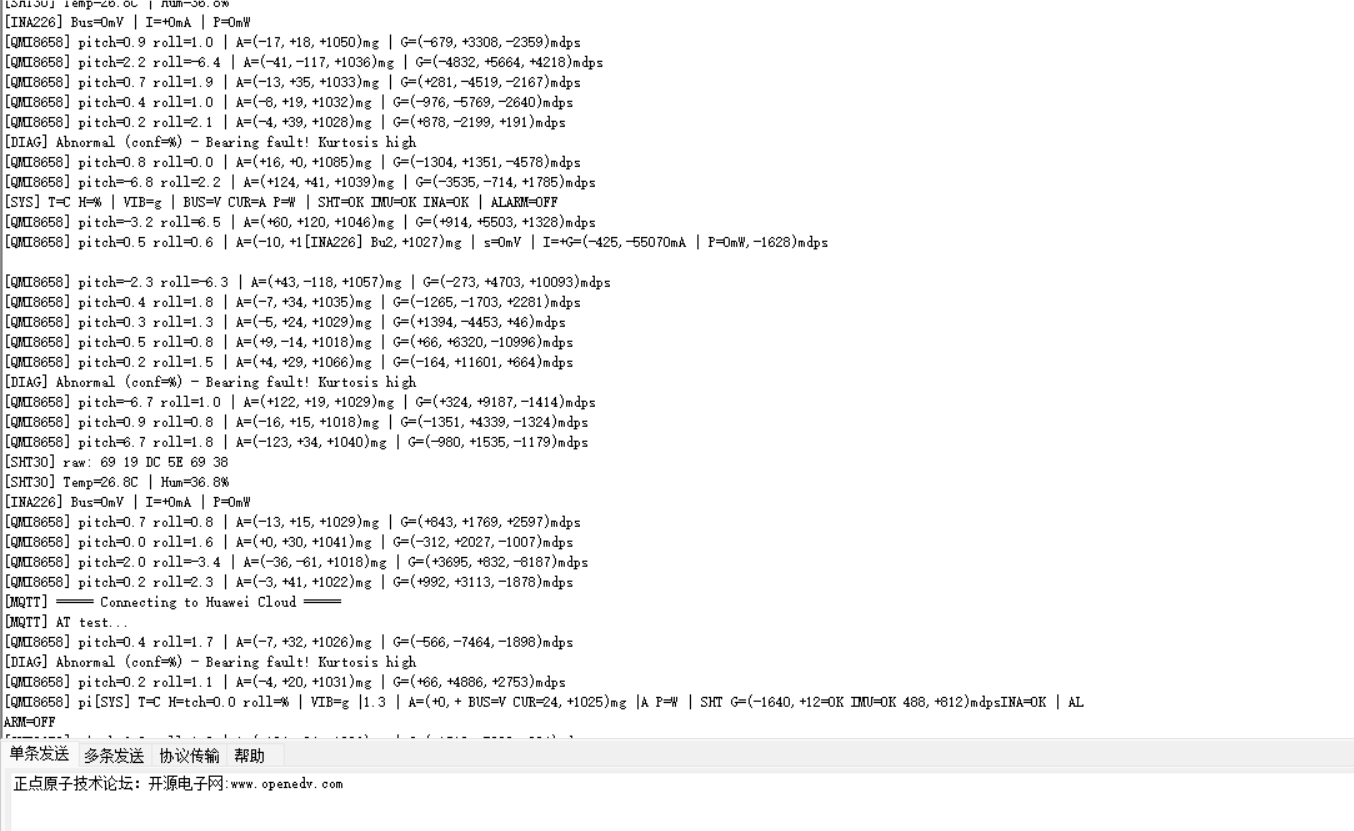
文档/截图_行列交换测试.png
