Zhangjiexi229/SMART-M/文档/截图_行拉低诊断.png

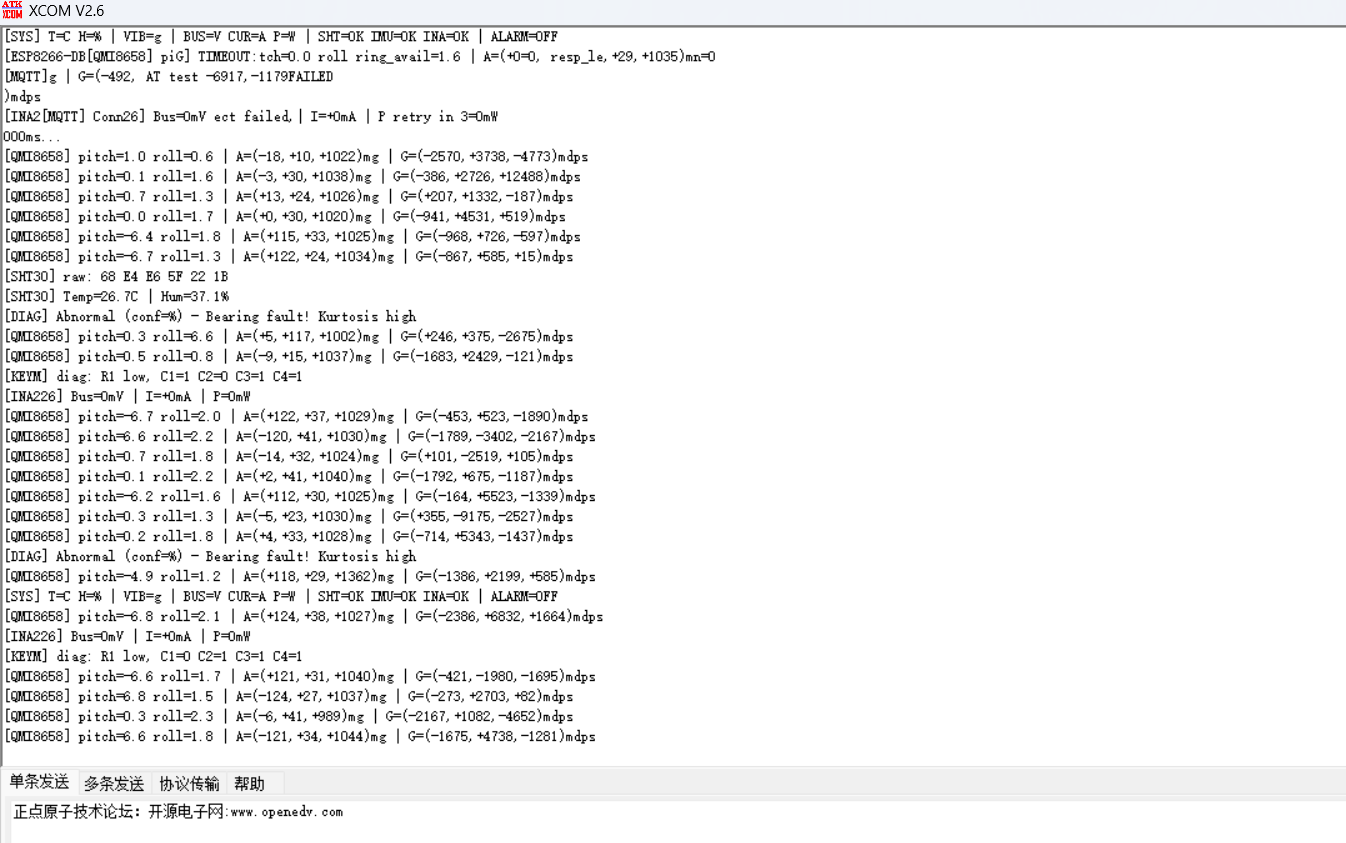
文档/截图_行拉低诊断.png
