Zhangjiexi229/SMART-M/文档/截图_设备数据无显示.png

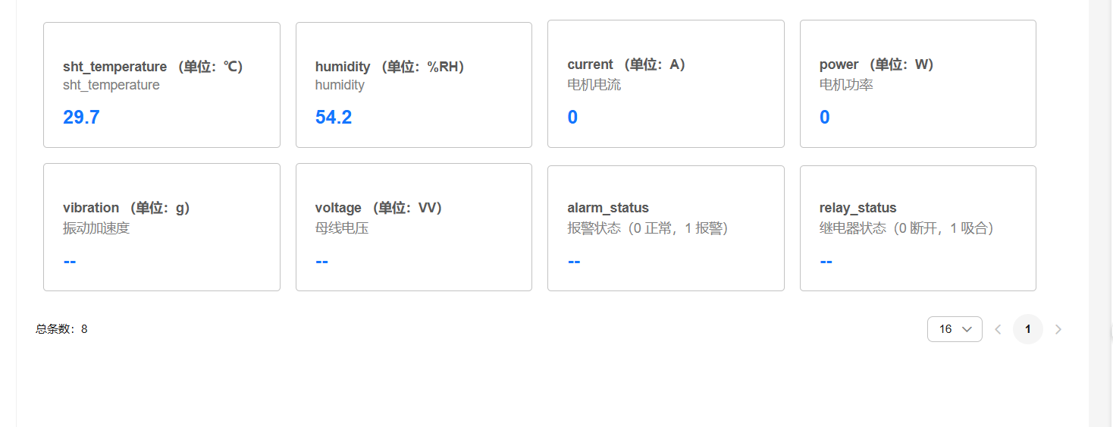
文档/截图_设备数据无显示.png
