Zhangjiexi229/SMART-M/文档/截图_设备数据部分显示.png

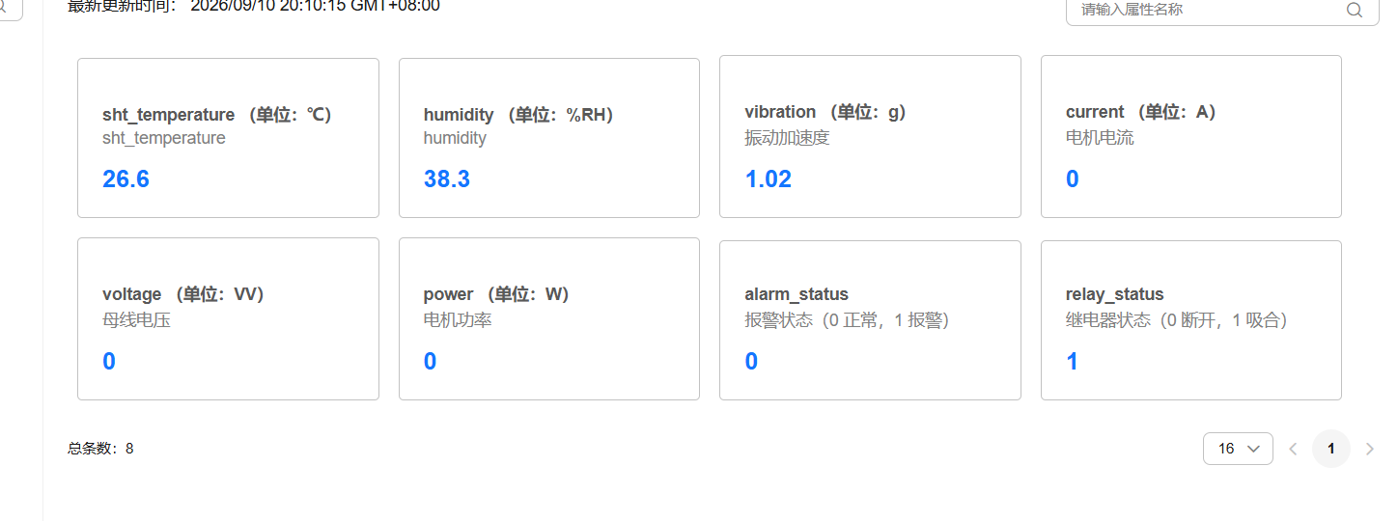
文档/截图_设备数据部分显示.png
