Zhangjiexi229/SMART-M/文档/接线_右上继电器区.jpg

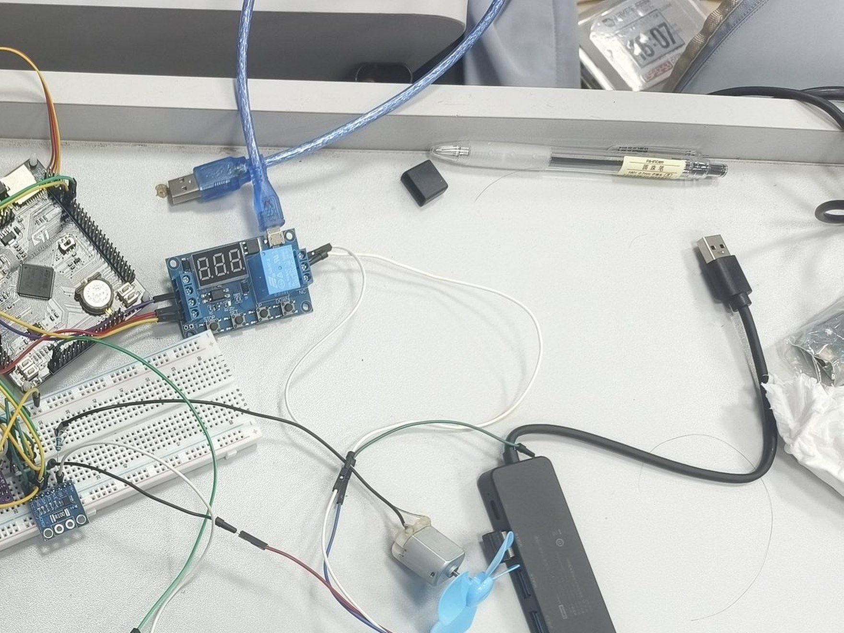
文档/接线_右上继电器区.jpg
