Zhangjiexi229/SMART-M/文档/接线_核心板区.jpg

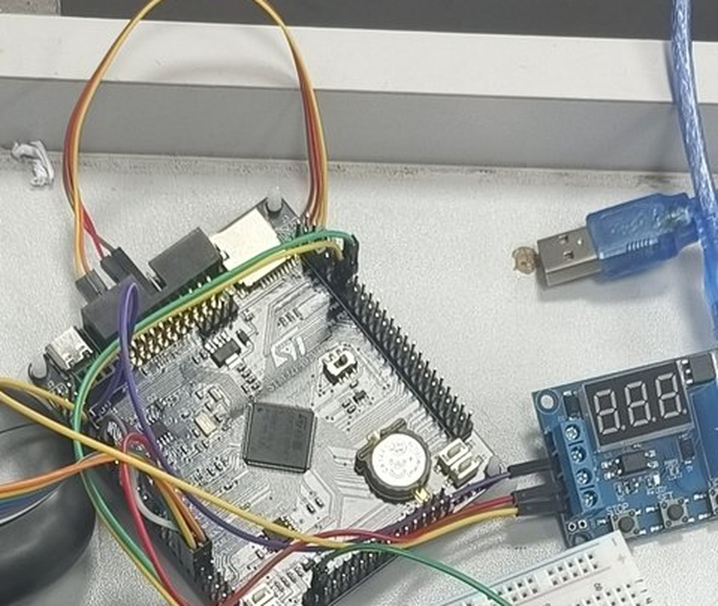
文档/接线_核心板区.jpg
