Zhangjiexi229/SMART-M/文档/接线_电池电源区.jpg

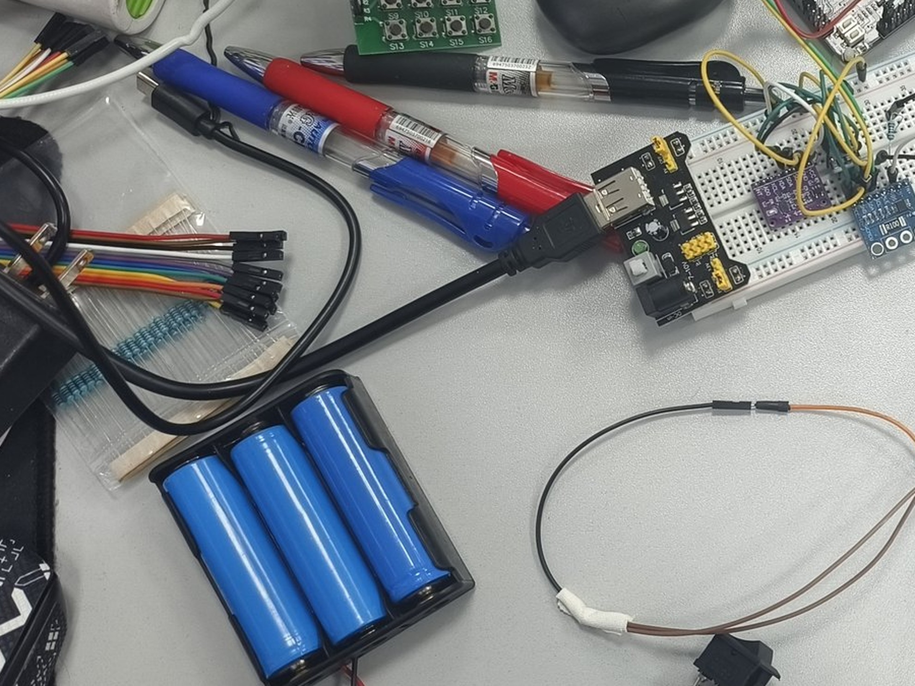
文档/接线_电池电源区.jpg
