Zhangjiexi229/SMART-M/文档/接线_矩阵键盘_缩放.jpg

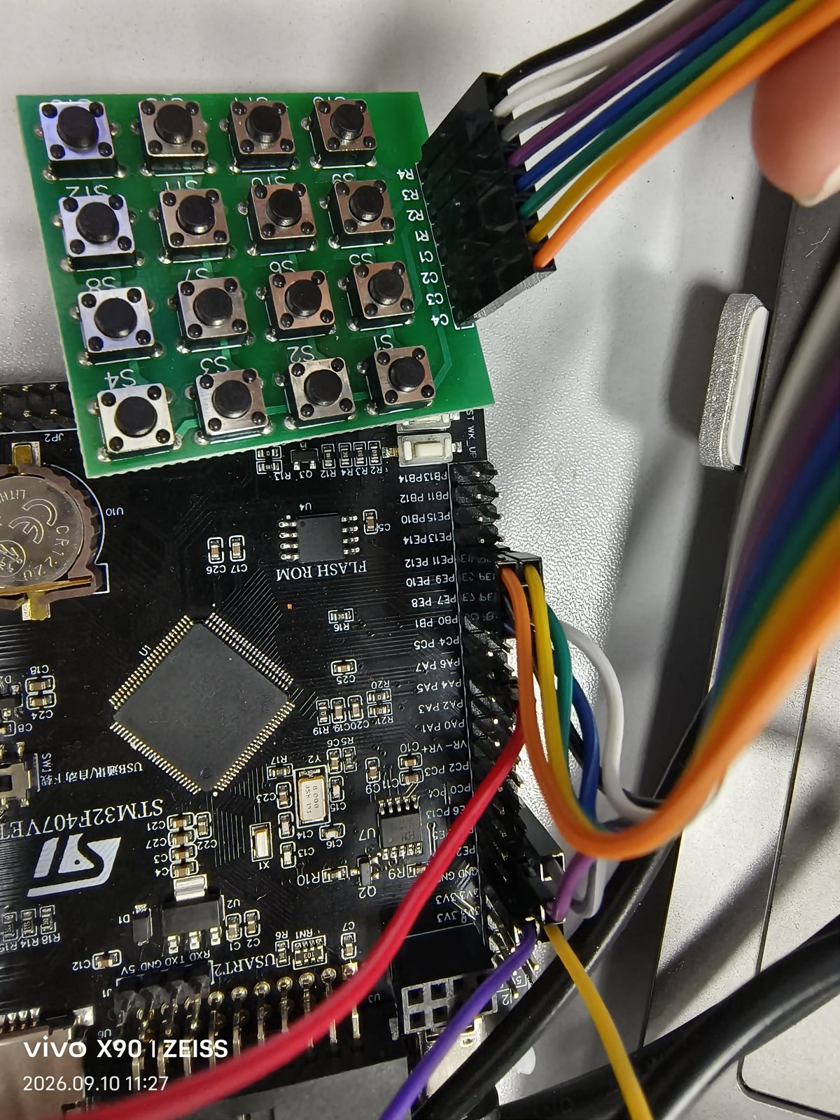
文档/接线_矩阵键盘_缩放.jpg
