Zhangjiexi229/SMART-M/文档/接线_继电器模块区.jpg

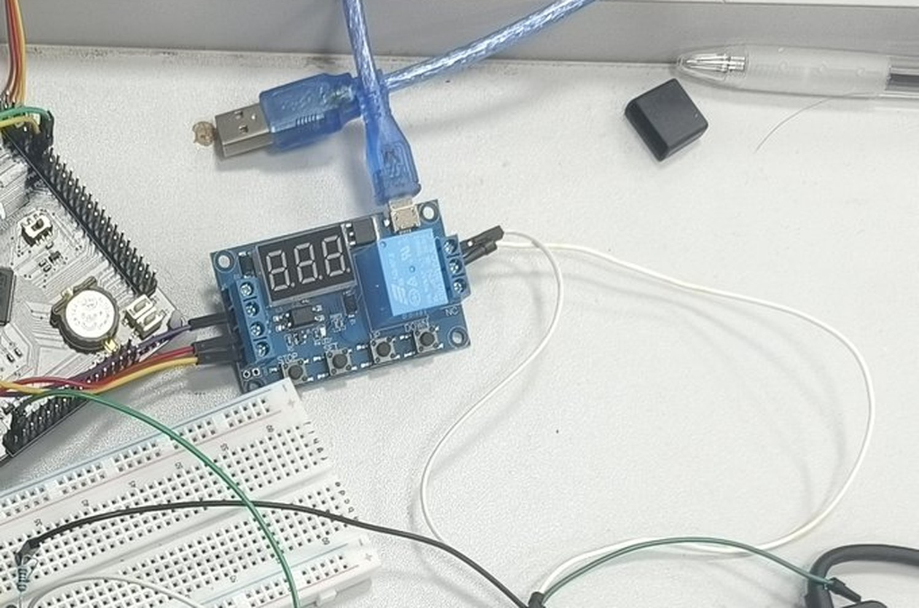
文档/接线_继电器模块区.jpg
