Zhangjiexi229/SMART-M/文档/接线全貌_缩放.jpg

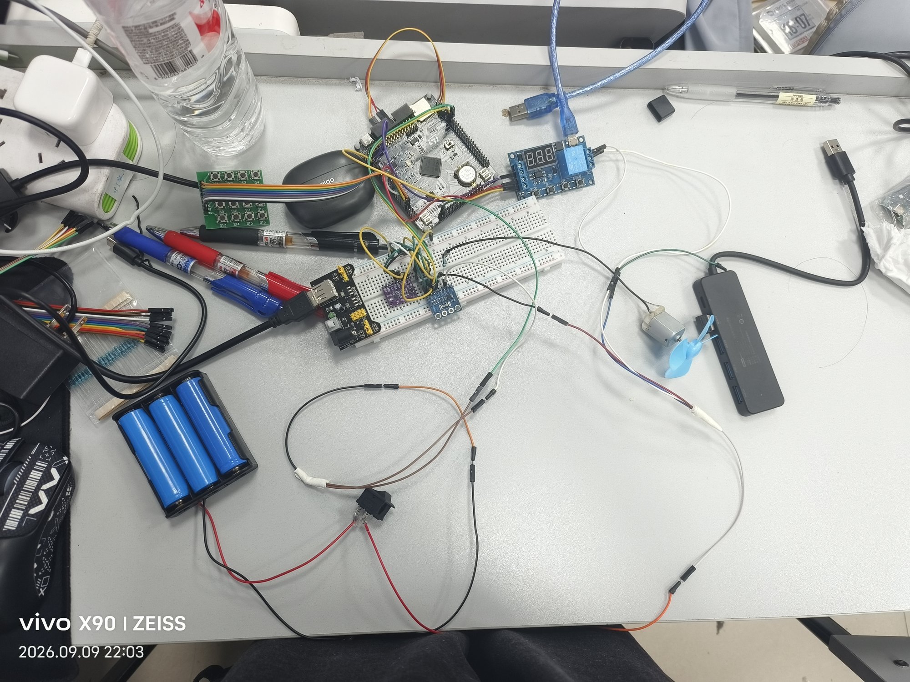
文档/接线全貌_缩放.jpg
