Zhangjiexi229/SMART-M/文档/电机照片.jpg

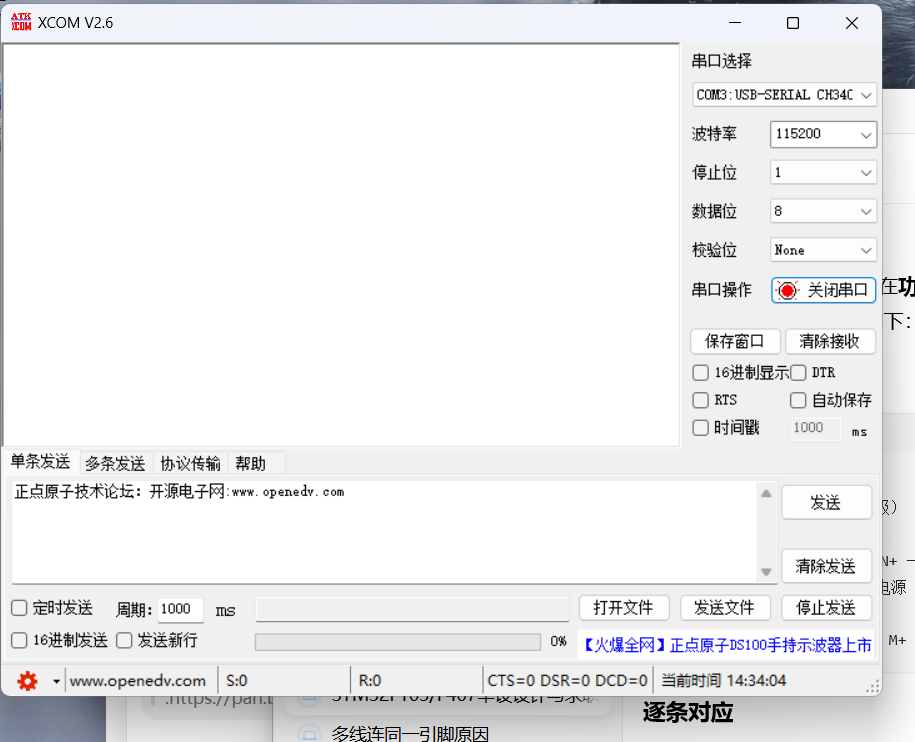
文档/电机照片.jpg
