Zhangjiexi229/SMART-M/文档/电源接线图.png

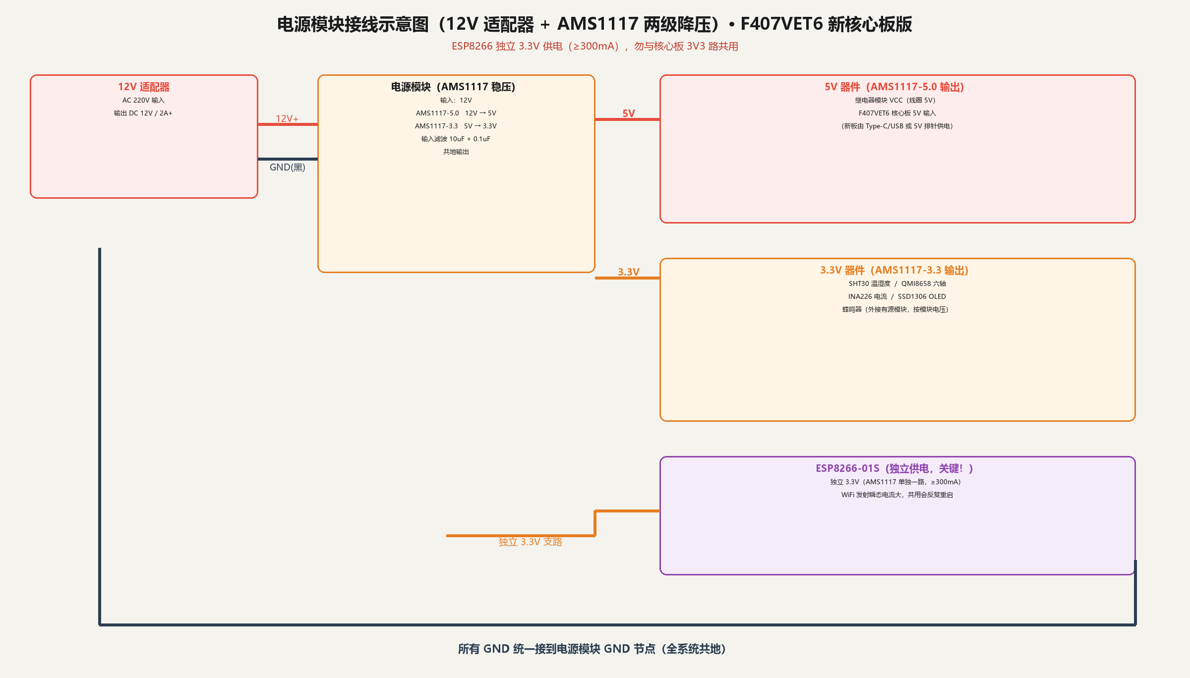
文档/电源接线图.png
