Zhangjiexi229/SMART-M/文档/端子线序_放大.jpg

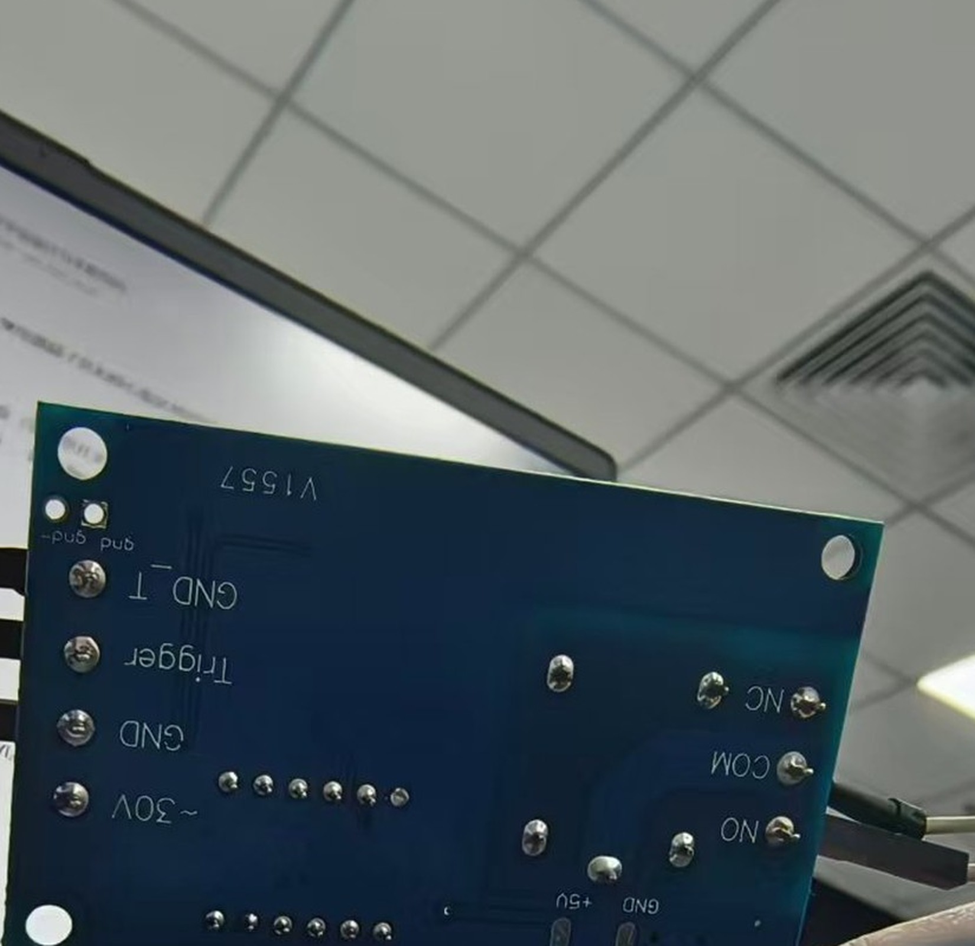
文档/端子线序_放大.jpg
