Zhangjiexi229/SMART-M/文档/系统接线总图.png

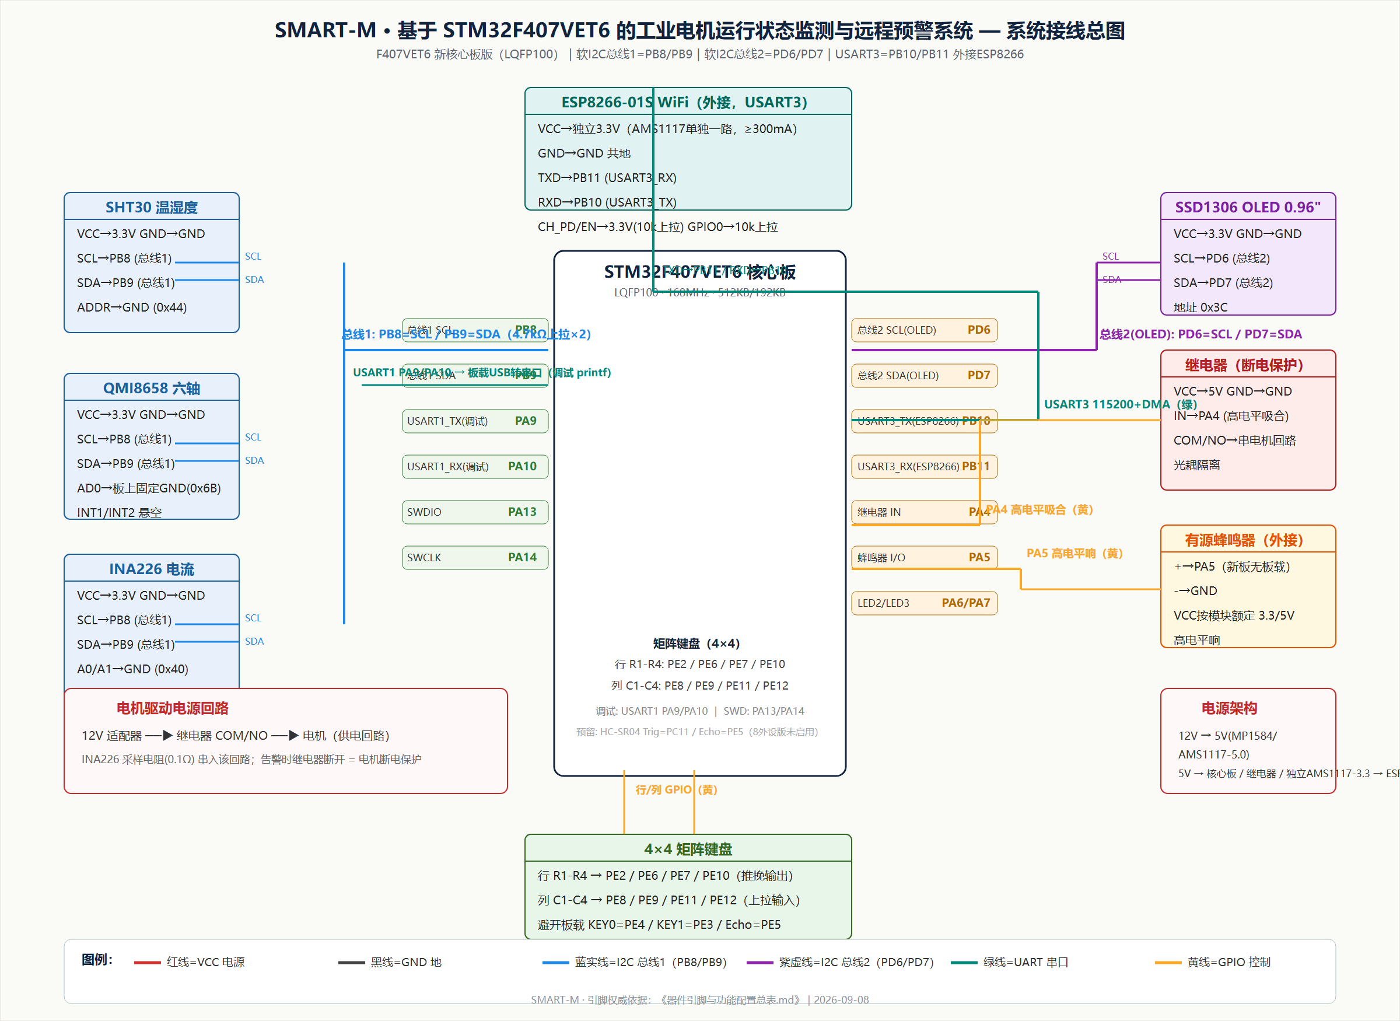
文档/系统接线总图.png
