Zhangjiexi229/SMART-M/文档/进度照片_第二天.jpg

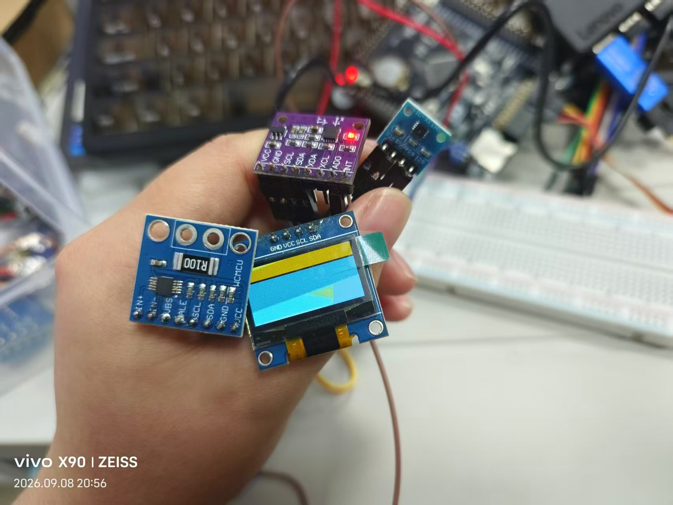
文档/进度照片_第二天.jpg
