Zhangjiexi229/SMART-M/矩阵键盘4x4按键功能.png

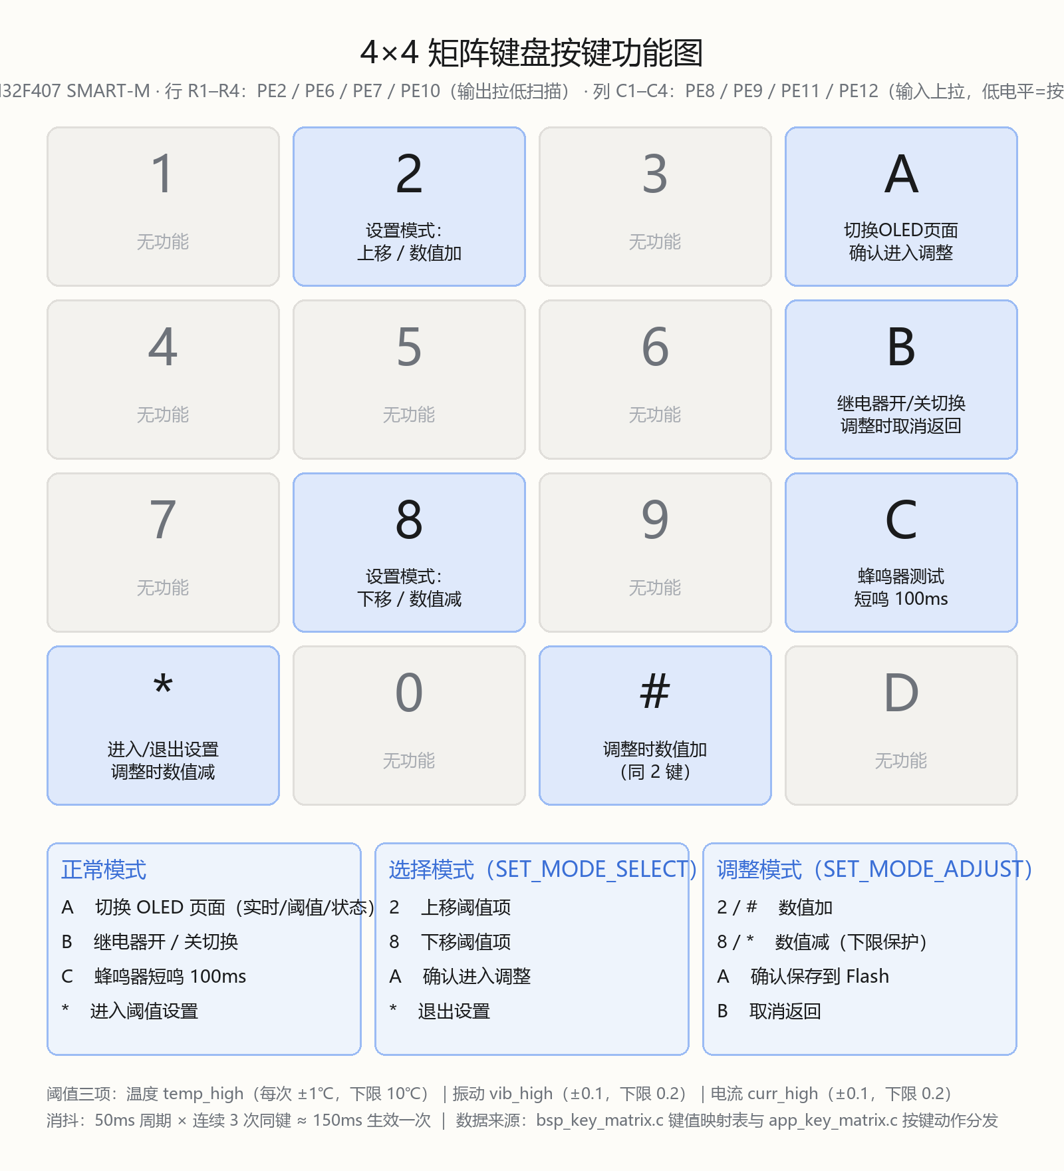
矩阵键盘4x4按键功能.png
