Zhangjiexi229/SMART-M/SD日志实测核验.html

# SD 日志实测核验结果

SMART-M 项目 · 直接读取 F:\SMART\LOG0001.CSV / LOG0002.CSV · 2026-09-14

格式验证通过：8 列、列序、精度、行尾全部正确，无乱码、无空行、无越界值。
但实测数据暴露两个问题：① INA226 三列（电流/电压/功率）全为 0；② 行间隔约 10s，而设计为 5s。

## 文件统计

文件 | 大小 | 数据行数 | uptime 区间 | 来源
LOG0001.CSV | 259 B | 5 行 | 23–63 s | 第二轮固件时期的一次成功会话
LOG0002.CSV | 1176 B | 27 行 | 22–293 s | 当前第三轮固件会话

## 逐列实测

列 | 实测范围 | 判定 | 说明
uptime_s | 22 → 293 | ✓ 正常 | 单调递增
temp_c | 27.1 – 27.4 ℃ | ✓ 合理 | SHT30 室温
hum_rh | 37.8 – 39.5 %RH | ✓ 合理 | SHT30
vib_g | 1.019 – 1.049 g | ✓ 合理 | 静态约 1g + 噪声，符合 QMI8658
current_a | 0.000 | ✗ 异常 | INA226 未提供有效读数：读失败时代码显式写 0（app_ina226.c）——需查 I2C 接线/供电/任务
voltage_v | 0.00 | ✗ 异常
power_w | 0.000 | ✗ 异常
alarm | 0 | ✓ 正常 | 无报警

## 两个发现

① INA226 三列全为 0 —— 格式没问题，是数据源问题：代码在 INA226 读取失败时向快照写 0。串口应能看到 [INA226] Read FAILED 或 I2C failed...bus recovering。检查：INA226 是否供电/接线、I2C 地址(0x40?)、电机负载是否上电。

② 行间隔约 10s（设计 5s） —— 代码路径已核验：HAL 时基 1ms、FreeRTOS tick 1kHz、延时常量 5000，延时本身应为 5s。多出的 ~5s 最可能来自每次 f_sync 落盘耗时（FAT 目录/扇区写入慢，卡写入速度差或触发重试）。与这张卡整体偏弱的表现一致。建议换正品卡后观察是否回到 5s；若需要，可在固件里打印 f_sync 耗时确认。

依据：F:\SMART 两个 CSV 文件实测 + app_ina226.c / app_sd.c / app_watchdog.c / FreeRTOSConfig.h / stm32f4xx_hal_timebase_tim.c
