Zhangjiexi229/SMART-M/SD日志格式核验.html

# SD 日志 CSV 格式核验

SMART-M 项目 · 代码静态核验（app_sd.c + app_diag.h）· 2026-09-14

格式符合预期：表头 8 列与数据行 8 个字段一一对应，列序、单位、小数精度均匹配。实际文件内容待 SD 卡插入电脑后直接读取验证。

## 文件内容规范

uptime_s,temp_c,hum_rh,vib_g,current_a,voltage_v,power_w,alarm

0,24.5,55.2,1.012,0.320,12.10,3.872,0

# | 列名 | 含义 | 来源 | 单位 | 精度 | 预期范围

1 | uptime_s | 运行秒数（自开机） | HAL_GetTick()/1000 | s | 整数 | 0 起递增
2 | temp_c | 温度 | SHT30 | ℃ | %.1f | 约 10~40（可负）
3 | hum_rh | 相对湿度 | SHT30 | %RH | %.1f | 0~100
4 | vib_g | 振动模值 √(ax²+ay²+az²) | QMI8658 | g | %.3f | 静态 ≈1.0，振动时 >1
5 | current_a | 负载电流 | INA226 | A | %.3f | 视负载 0~数 A
6 | voltage_v | 母线电压 | INA226 | V | %.2f | 约 5 或 12
7 | power_w | 功率（U×I） | INA226 | W | %.3f | ≈ 电压×电流
8 | alarm | 报警标志 | g_alarm_active | — | %u | 0 或 1

## 写入与滚动逻辑

项目 | 行为 | 核验
写入节奏 | 每 5s 追加一行，f_sync 每条落盘 | ✓ 符合
文件滚动 | 单文件 >256KB 自动切下一编号 | ✓ 符合
新会话 | 每次成功挂载后开 max+1 新编号（FA_OPEN_ALWAYS） | ✓ 符合（LOG0002 存在 ⇒ 0001 已建）
表头 | 仅空文件（新文件）写入表头 | ✓ 符合

两个使用注意点：
① 每次重新挂载都会新开一个编号文件（不做续写），设备频繁重启会产生多个小文件——属设计行为，不是异常；
② 某传感器失效时，对应列保留上一次的旧值（valid 标志只维护在内存、不写入 CSV），需要结合其他列或报警判断数据是否新鲜。

依据：app_sd.c（SD_OpenNextLogFile / APP_SD_Task 写入格式）+ app_diag.h（快照字段定义）
