Zhangjiexi229/SMART-M/文档/串口日志截图.jpg

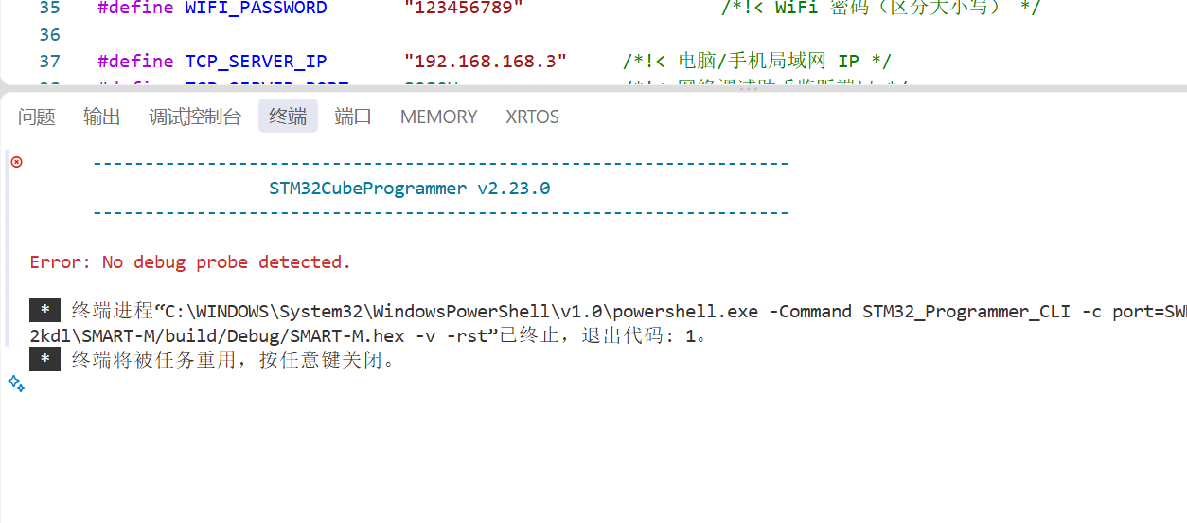
文档/串口日志截图.jpg
