Zhangjiexi229/SMART-M/Core/Src/main.c

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
/* Includes ------------------------------------------------------------------*/
#include "main.h"
#include "cmsis_os.h"
#include <string.h>
#include "adc.h"
#include "dma.h"
#include "tim.h"
#include "usart.h"
#include "gpio.h"

/* USER CODE BEGIN Includes */
#if APP_TASKS_ENABLE
#include "app_tasks.h"
#endif /* APP_TASKS_ENABLE */
/* USER CODE END Includes */


void SystemClock_Config(void);
void MX_FREERTOS_Init(void);
/**
  * @brief  The application entry point.
  * @retval int
  */
int main(void)
{

  /* MCU Configuration--------------------------------------------------------*/

  /* Reset of all peripherals, Initializes the Flash interface and the Systick. */
  HAL_Init();

  /* Configure the system clock */
  SystemClock_Config();

  /* Initialize all configured peripherals */
  MX_GPIO_Init();
  MX_DMA_Init();
  MX_USART1_UART_Init();
  /* MX_ADC3_Init(); 光敏传感器已禁用：F407VET6(LQFP100) 无 PF7(ADC3_IN5) */
  MX_TIM2_Init();
  MX_USART3_UART_Init();
  MX_USART2_UART_Init();
  /* USER CODE BEGIN 2 */
  /* 打印上电复位原因（诊断 IWDG 看门狗复位：每次系统被看门狗复位后启动都会显示） */
  {
    uint32_t csr = RCC->CSR;
    const char *reason = "UNKNOWN";
    if (csr & RCC_CSR_LPWRRSTF)  reason = "LOW-POWER RESET";
    else if (csr & RCC_CSR_WWDGRSTF) reason = "WWDG RESET";
    else if (csr & RCC_CSR_IWDGRSTF) reason = "IWDG (WATCHDOG) RESET";
    else if (csr & RCC_CSR_SFTRSTF)  reason = "SOFTWARE RESET";
    else if (csr & RCC_CSR_PORRSTF)   reason = "POWER-ON/POWER-DOWN RESET";
    else if (csr & RCC_CSR_PINRSTF)   reason = "NRST PIN RESET";
    else if (csr & RCC_CSR_BORRSTF)   reason = "BROWN-OUT RESET";
    HAL_UART_Transmit(&huart1, (uint8_t *)"[BOOT] Reset reason: ", 21, 100);
    HAL_UART_Transmit(&huart1, (uint8_t *)reason, (uint16_t)strlen(reason), 100);
    HAL_UART_Transmit(&huart1, (uint8_t *)"\r\n", 2, 100);
    __HAL_RCC_CLEAR_RESET_FLAGS();
  }
  /* USER CODE END 2 */

  /* Init scheduler */
  osKernelInitialize();  /* Call init function for freertos objects (in cmsis_os2.c) */
  MX_FREERTOS_Init();

  /* Start scheduler */
  osKernelStart();

  /* We should never get here as control is now taken by the scheduler */

  /* Infinite loop */
  /* USER CODE BEGIN WHILE */
  while (1)
  {
    /* USER CODE END WHILE */

    /* USER CODE BEGIN 3 */
  }
  /* USER CODE END 3 */
}

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
/**
  * @brief  Period elapsed callback in non blocking mode
  * @note   This function is called  when TIM6 interrupt took place, inside
  * HAL_TIM_IRQHandler(). It makes a direct call to HAL_IncTick() to increment
  * a global variable "uwTick" used as application time base.
  * @param  htim : TIM handle
  * @retval None
  */
void HAL_TIM_PeriodElapsedCallback(TIM_HandleTypeDef *htim)
{
  /* USER CODE BEGIN Callback 0 */
#if APP_MODBUS_ENABLE
  extern void MB_Slave_TimerExpiredHandler(void);
  extern void MB_Master_TimerExpiredHandler(void);
  if (htim->Instance == TIM7)  { MB_Slave_TimerExpiredHandler();  return; }
  if (htim->Instance == TIM12) { MB_Master_TimerExpiredHandler(); return; }
#endif /* APP_MODBUS_ENABLE */
  /* USER CODE END Callback 0 */
  if (htim->Instance == TIM6)
  {
    HAL_IncTick();
  }
}

/**
  * @brief  This function is executed in case of error occurrence.
  * @retval None
  */
void Error_Handler(void)
{
  /* USER CODE BEGIN Error_Handler_Debug */
  /* User can add his own implementation to report the HAL error return state */
  __disable_irq();
  while (1)
  {
  }
  /* USER CODE END Error_Handler_Debug */
}
#ifdef USE_FULL_ASSERT
/**
  * @brief  Reports the name of the source file and the source line number
  *         where the assert_param error has occurred.
  * @param  file: pointer to the source file name
  * @param  line: assert_param error line source number
  * @retval None
  */
void assert_failed(uint8_t *file, uint32_t line)
{
  /* USER CODE BEGIN 6 */
  /* User can add his own implementation to report the file name and line number,
     ex: printf("Wrong parameters value: file %s on line %d\r\n", file, line) */
  /* USER CODE END 6 */
}
#endif /* USE_FULL_ASSERT */
