Zhangjiexi229/SMART-M/SMART-M.ioc

Mcu.UserName=STM32F407VETx
PA10.Signal=USART1_RX
PA13.Signal=SYS_JTMS-SWDIO
PA14.Signal=SYS_JTCK-SWCLK
PA2.Signal=USART2_TX
PA3.Signal=USART2_RX
PA5.GPIO_Label=BEEP
PA5.Signal=GPIO_Output
PA9.Signal=USART1_TX
PB10.Signal=USART3_TX
PB11.Signal=USART3_RX
PB3.GPIO_Label=SPI_SCLK
PB3.Signal=GPIO_Output
PB4.GPIO_Label=SPI_MISO
PB4.Signal=GPIO_Input
PB5.GPIO_Label=SPI_MOSI
PB5.Signal=GPIO_Output
PB8.GPIO_Label=AT24C02_SCL
PB8.Signal=GPIO_Output
PB9.GPIO_Label=AT24C02_SDA
PB9.Signal=GPIO_Output
PC11.GPIO_Label=trig
PC11.Signal=GPIO_Output
PD6.GPIO_Label=OLED_SCL
PD6.Signal=GPIO_Output
PD7.GPIO_Label=OLED_SDA
PD7.Signal=GPIO_Output
PE5.GPIO_Label=echo
PE5.Signal=GPIO_Input
PA6.GPIO_Label=LED1
PA6.Signal=GPIO_Output
PA7.GPIO_Label=LED2
PA7.Signal=GPIO_Output
PH0-OSC_IN.Signal=RCC_OSC_IN
PH1-OSC_OUT.Signal=RCC_OSC_OUT
