Zhangjiexi229/SMART-M/Core/Inc/main.h

#define echo_Pin GPIO_PIN_5
#define echo_GPIO_Port GPIOE
#define BEEP_Pin GPIO_PIN_5
#define BEEP_GPIO_Port GPIOA
#define LED3_Pin GPIO_PIN_6
#define LED3_GPIO_Port GPIOA
#define trig_Pin GPIO_PIN_11
#define trig_GPIO_Port GPIOC
#define OLED_SCL_Pin GPIO_PIN_6
#define OLED_SCL_GPIO_Port GPIOD
#define OLED_SDA_Pin GPIO_PIN_7
#define OLED_SDA_GPIO_Port GPIOD
#define LED4_Pin GPIO_PIN_7
#define LED4_GPIO_Port GPIOA
#define LED2_Pin GPIO_PIN_7
#define LED2_GPIO_Port GPIOA
#define LED1_Pin GPIO_PIN_6
#define LED1_GPIO_Port GPIOA
#define SPI_SCLK_Pin GPIO_PIN_3
#define SPI_SCLK_GPIO_Port GPIOB
#define SPI_MISO_Pin GPIO_PIN_4
#define SPI_MISO_GPIO_Port GPIOB
#define SPI_MOSI_Pin GPIO_PIN_5
#define SPI_MOSI_GPIO_Port GPIOB
#define AT24C02_SCL_Pin GPIO_PIN_8
#define AT24C02_SCL_GPIO_Port GPIOB
#define AT24C02_SDA_Pin GPIO_PIN_9
#define AT24C02_SDA_GPIO_Port GPIOB
