Zhangjiexi229/SMART-M/(commit log)

2026-09-11 v1.0: STM32F407 工业电机智能监测系统（SMART-M）
    - 多传感器采集：SHT30 温湿度 / QMI8658 六轴IMU / INA226 电源监测
    - 边缘智能：振动特征提取 + 故障诊断规则引擎 + 滑动平均滤波
    - 告警联动：三路阈值 + 继电器断电保护 + 蜂鸣器 + 内部Flash阈值持久化
    - 云平台：ESP8266 + Paho MQTT 接入华为云 IoTDA，物模型上报/命令下发
    - 断网补传：RAM 环形缓冲 300 条，重连批量补发
    - 人机交互：4x4 矩阵键盘 + OLED 三页面显示
    - 分层架构：Common / BSP / Protocol / APP 四层，模块条件编译裁剪
2026-09-12 v2.0: 五层架构重构 + WiFi/MQTT 上云全链路精进
    - 架构升级：APP/SVC/PLAT/BSP/COMMON 五层解耦，protocol 归入应用层子目录
    - WiFi 精进：IPv4 直连 IP 解决 ESP8266 IPv6 DNS 解析超时；指数退避重连(1s-30s)；连续5次失败自动复位模块；10s TCP 保活+强制重建
    - MQTT 精进：线程安全外部发布接口 APP_MQTT_Publish/PublishTopic；离线缓存16条补发；LED_Control 双模式+新增 RELAY_Control；属性上报扩展(SHT30/QMI8658/INA226/告警/诊断)；设备消息队列主题
    - 新增串口日志任务；README 更新至 v2.0
2026-09-13 v3.0: 03_plat平台层框架落地 + WiFi断线感知精进
    - 03_plat 对象化平台框架实现：plat_obj/plat_devmgr/plat_svcmgr/plat_conn/plat_brdmgr/plat_oled
    - module_cfg 新增 PLAT_* 平台层开关与 BSP_IWDG 独立看门狗
    - WiFi 断线感知：异步 WIFI DISCONNECT 事件检测、CIPSTATUS 防假在线、断线立即重连
    - 新增 BSP_ESP8266_IsWiFiConnected/IsWiFiClosed/ClearWiFiClosedFlag
    - README 更新至 v3.0
2026-09-15 v4.0: 引脚与连接方式进阶 + 蓝牙透传 + SD卡存储
    - 三传感器共享I2C总线(PB6/PB7)：SHT30/QMI8658/INA226统一挂载，总线恢复防死锁
    - INA226换新模块：地址0x40(A0/A1接GND)、采样电阻0.01Ω R010
    - 新增DX-BT24蓝牙透传：USART2(PA2/PA3)9600bps，BT24Task上报快照JSON+小程序命令(QUERY/RELAY/LED/PING/BEEP)
    - 新增SD卡存储：SDIO 4bit(PC8-PC12+PD2)FatFs，每5s诊断快照CSV落盘(256KB滚动)
    - WiFi断线感知三态检测：1=在线/0=断线/-1=查询失败(信任GetIP避免反复重连)
    - 串口调试过滤开关 BSP_UART1_SD_ONLY
    - README更新至v4.0
2026-09-15 v5.0: 小程序完整版 v1.11 + 蓝牙模块增强 + 网络配置运行时化
    - 微信小程序 v1.11 三页面：首页实时遥测+命令控制、设备配置(GETTH/SETTH+GETCFG/SETCFG)、历史数据
    - 蓝牙命令集扩充：GETTH/SETTH 阈值在线修改，GETCFG/SETCFG 网络配置在线修改，AT+NOTI1 连接判定
    - 网络配置运行时化 app_netcfg：WiFi/云参数存 Flash Sector7 掉电不丢，保存后 MQTT 自动重连
    - 内部 Flash 配置存储统一 BSP_FLASH_CONFIG：阈值 Sector6 + 网络配置 Sector7
    - app_mqtt/MQTTClient/bsp_esp8266/ring_buffer 等配套重构
    - README 更新至 v5.0
